ahmedoab/cargo_robot/cad/README.md

# Cargo robot: mechanical design v2 with a tilting bed (Phase II)

**Overall size:** 407 × 382 × 220 mm (L × W × H) with the bed flat.

**Layout:**

- Two drive wheels in the middle (JGB37-520 110 RPM motor sets with 65 mm wheels), and a printed ball caster at the front and rear (a 25 mm steel ball in a cup, on an M8 bolt whose nuts set the height).
- All four plates are laser-cut from **6 mm acrylic**.
- The bottom plate carries the electronics: ESP32, motor drivers, battery, two buck converters.
- The top deck sits on 6 M6 threaded rods. The E-stop and master switch are at its front, the start button and two LEDs at its rear.
- **Tilting bed:** the tilting plate carries the cargo plate on 4 printed risers. Two 60 kg·cm servos on the deck's right edge, one at each end of the bed, turn it about their shafts (the shafts are the hinge). The bed tips 40° to the right and the package slides off onto the conveyor. Flat, it rests on two printed posts.
- **Sensors:** 3 IR line sensors on a printed bar under the bottom plate (in front of the wheels, nothing sticks out), and one HC-SR04 ultrasonic sensor at the front of the electronics bay looking ahead. Everything is wired straight to the ESP32 (no I/O expander, no I2C).

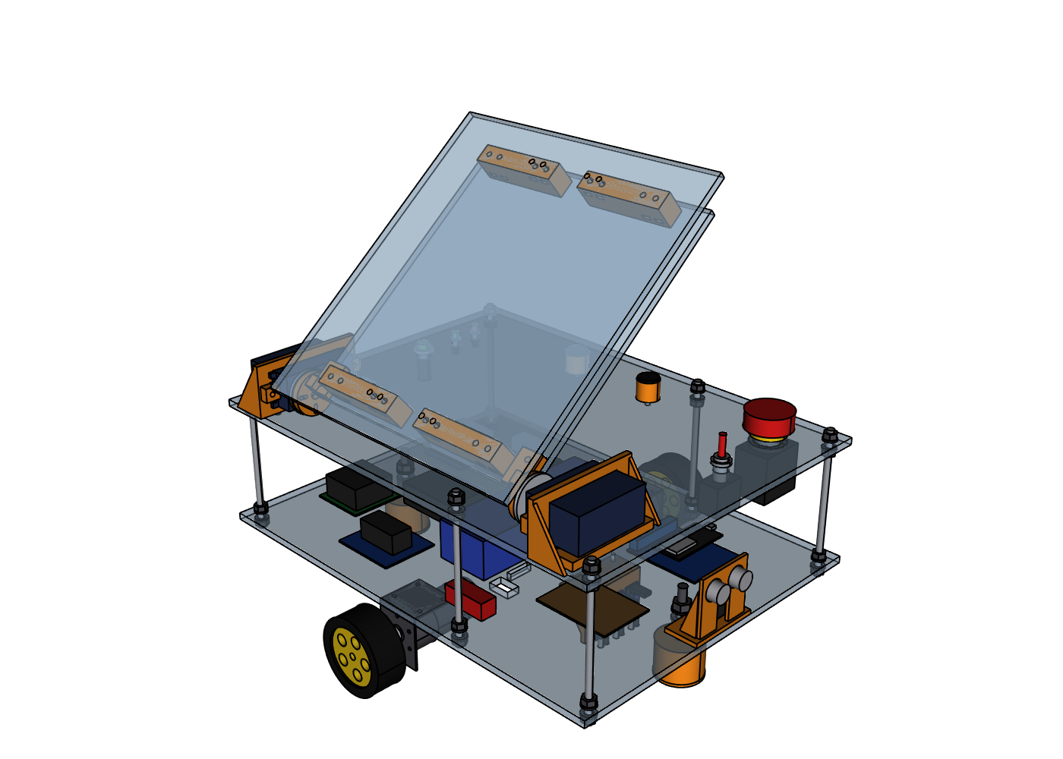
[picture p2: cad/output/views/render_tipped.png]
The robot, bed tipped


## AutoCAD

`autocad/CargoRobot_v2.dxf` is the design in AutoCAD's own format.

- **Open it:** File → Open → *Files of type: DXF* → the file. Then File → Save As → *AutoCAD 2018 Drawing (*.dwg)*.
- **Model tab:** the full 3D robot on layers `3D-CHASSIS`, `3D-DRIVE`, `3D-ELECTRONICS`, `3D-SENSORS`, `3D-CONTROLS`, `3D-TILT` (servos and their mounts) and `3D-PAYLOAD` (everything that tips).
  - Orbit with Shift + middle mouse button, or the ViewCube.
  - Set the visual style (top-left corner of the view) to *Shaded with Edges*.
- **Layout tabs 01–10:** A3 engineering drawings with dimensions, a title block and a bill of materials.
  - 01 general arrangement, 02 layout with the deck removed, 03–06 the four plates with hole tables, 07 the tilting bed, 08–09 printed parts, 10 BOM.
  - They're set up to plot on *DWG To PDF*, A3, 1:1.
  - Fill in the "DRAWN" box in the title block.
- **True 3D solids** (full AutoCAD, not LT): type `IMPORT` and pick `output/robot_assembly.step` (or `robot_assembly_tipped.step`).

`autocad/CargoRobot_v2_drawings.pdf` has the same 10 sheets as a PDF (true A3 pages, 1:1), for printing or showing without AutoCAD.

## Electrical schematics

`autocad/CargoRobot_v2_schematics.dxf` (AutoCAD, 4 layout tabs) and `autocad/CargoRobot_v2_schematics.pdf`:

- **E01 System block diagram:** every part and how power and signals flow between them.
- **E02 Power distribution:** battery → fuse → master switch → E-stop → motor drivers, motors and the 7.4 V servo buck; the 5.1 V buck for the ESP32 and sensors; the battery/E-stop sense divider. Wire IDs P1–P19 match the power wire list in `BUILD_GUIDE.md` (week 2).
- **E03 ESP32 wiring:** the DevKit's 38 pins with every used one, the motor/encoder cables, both BTS7960 drivers, the ultrasonic sensor with its divider, and the servo signals.
- **E04 Line sensors and panel:** the 3 IR modules, the start button, LEDs, buzzer and the motor-enable pull-down.

Pin numbers come from `firmware/cargo_robot/config.h`: change a pin there and re-run `make_schematics.py`.

## Assembly and connections

- `autocad/CargoRobot_v2_assembly.pdf`: every component (bought, laser-cut, 3D-printed), the tools, and the assembly in 11 steps with a picture of each stage; then drawing sheets 01, 02 and 07.
- `autocad/CargoRobot_v2_connections.pdf`: every wire (power P1–P19, signal S1–S28), the parts on the I/O board, the connections of each part pin by pin, then the 4 schematic sheets.

Both are made by `make_docs.py` from `robot_cad.py` (parts), `wiring.py` (wires) and `firmware/cargo_robot/config.h` (pin numbers).

## Open it in other CAD programs

- **Fusion 360:** Upload → `output/robot_assembly.step`
- **SolidWorks:** File → Open → change the file type to STEP → `output/robot_assembly.step`
- **Onshape:** Import → `output/robot_assembly.step`
- **FreeCAD:** File → Open → `output/robot_assembly.step`

## Make it

| File | How it's made |
|---|---|
| `output/dxf/bottom_plate.dxf`, `top_deck.dxf`, `tilt_plate.dxf`, `cargo_plate.dxf` | Laser-cut 6 mm acrylic. Every hole and slot is in the files. Use washers on the acrylic and tighten only until snug. |
| `output/parts/*.stl` (ONLY the printed parts, see below) | 3D print, PETG. Each file already lies in its printing position. |
| `output/bom.csv` | Everything else (bought parts, rods, nuts) |

Printed parts (11 files, 19 prints): `servo_mount_front`, `servo_mount_rear`, `servo_clamp` (× 4), `horn_adapter_front`, `horn_adapter_rear`, `bed_rest` (× 2), `bed_riser` (× 4), `line_sensor_bar`, `sonar_bracket`, `caster_cup` (× 2), `caster_ring` (× 2). The plates are not in `output/parts/`: they are the DXF files, for the laser.

> **How the prints were checked.** `check_render.py` runs a rod slightly thinner than each bolt through every bolt path (57 of them) to prove the holes line up through all the parts they join, checks every part against every other with the bed at 0–45°, and checks that each printed part is one piece, fits a 200 × 200 mm printer and has a flat face on the bed. The servo mounts follow the DS5160 maker's drawing (65 × 30 mm body, 75 mm over the ears, ears 31 mm above the bottom); they clamp the ears and slide ±4 mm, so they don't depend on the details the maker doesn't publish. The casters and the line sensors adjust on the robot for whatever height your motor brackets give.

## Change it

Edit the parameters at the top of `robot_cad.py`, then run:

```
.venv\Scripts\python robot_cad.py       # regenerate every file
.venv\Scripts\python check_render.py    # bolt paths, collisions (bed flat and tipped), printability, wheels on the floor, torque, PNG renders
.venv\Scripts\python make_autocad.py    # AutoCAD DXF (3D model + 10 drawing sheets) + PDF
.venv\Scripts\python make_schematics.py # electrical schematics DXF + PDF
.venv\Scripts\python make_docs.py       # assembly PDF + connections PDF (+ updates BUILD_GUIDE.md's wire tables)
.venv\Scripts\python make_missing_parts.py  # ../Missing_Parts_List.pdf: what is still to buy (edit its lists)
```

`make_docs.py` also needs `reportlab` and `pypdf`: `.venv\Scripts\python -m pip install reportlab pypdf`.
