ahmedoab/cargo_robot/cad/autocad/CargoRobot_v2_connections.pdf

Autonomous cargo robot - design v2 - connections | page 1

# Cargo robot v2 - all connections

Graduation Project II - 12 November 2026. Every wire of the robot: the power wires (P), the signal wires (S), the small parts on the I/O board, then the connections of each part. The 4 schematic sheets follow at the end (A3). GPIO numbers come from firmware/cargo_robot/config.h.

How to read it. One row = one wire, from the first place to the second. Rows with the same ID belong to one job (e.g. S6 = the VCC of both motor drivers). Label every wire with its ID at both ends. Buses: WAGO +12 V MAIN (after the switch), WAGO +12 V MOTOR (after the E-stop), WAGO +5 V, WAGO +7.4 V and WAGO GND are lever connectors on the bottom plate; the 3V3 bus and GND bus are rows of linked pins on the I/O board (3V3 comes from the ESP32's 3V3 pin).
Never connect 5 V or more to an ESP32 pin, the encoders or the line sensors: they all run on 3.3 V. Wire with the master switch OFF and the battery unplugged.

## Power wires

ID | From | To | Wire | Note
P1 | Battery BT1 + (XT60) | Fuse holder F1 in | 16 AWG red, 10 cm | XT60 soldered
P2 | Fuse holder F1 out | Master switch SW1 terminal 1 | 16 AWG red
P3 | Master switch SW1 terminal 2 | WAGO +12 V MAIN | 16 AWG red | WAGO 221-415
P4 | Battery BT1 - (XT60) | WAGO GND | 16 AWG black | WAGO 221-415, link a second one
P5 | WAGO +12 V MAIN | E-stop S1 NC terminal 1 | 16 AWG red, 40 cm | ferrule
P6 | E-stop S1 NC terminal 2 | WAGO +12 V MOTOR | 16 AWG red, 40 cm | ferrule
P7 | WAGO +12 V MOTOR | BTS7960 left U2 B+ | 16 AWG red | ferrule
P8 | WAGO +12 V MOTOR | BTS7960 right U3 B+ | 16 AWG red | ferrule
P9 | WAGO GND | BTS7960 left U2 B- | 16 AWG black | ferrule
P10 | WAGO GND | BTS7960 right U3 B- | 16 AWG black | ferrule
P11 | BTS7960 left U2 M+ | Left motor M1 red (motor +) | 20 AWG or the motor's wire | ferrule
P11 | BTS7960 left U2 M- | Left motor M1 white (motor -) | 20 AWG or the motor's wire | ferrule
P12 | BTS7960 right U3 M+ | Right motor M2 red (motor +) | 20 AWG or the motor's wire | ferrule
P12 | BTS7960 right U3 M- | Right motor M2 white (motor -) | 20 AWG or the motor's wire | ferrule
P13 | WAGO +12 V MAIN | 5 V buck U1 IN+ | 20 AWG red | ferrule
P14 | WAGO GND | 5 V buck U1 IN- | 20 AWG black | ferrule
P15 | 5 V buck U1 OUT+ | WAGO +5 V | 20 AWG red | set to 5.10 V first
P15 | 5 V buck U1 OUT- | WAGO GND | 20 AWG black
P15 | WAGO +5 V | ESP32 (breakout) 5V | 20 AWG red
P15 | WAGO GND | ESP32 (breakout) GND | 20 AWG black | the logic ground starts here
P16 | Battery BT1 balance plug | LiPo voltage alarm | - | set it to 3.5 V per cell

ID | From | To | Wire | Note
P17 | WAGO +12 V MOTOR | Servo buck U5 IN+ | 16 AWG red | ferrule
P18 | WAGO GND | Servo buck U5 IN- | 16 AWG black | ferrule
P19 | Servo buck U5 OUT+ | WAGO +7.4 V | 16 AWG red | set to 7.4 V first
P19 | Servo buck U5 OUT- | WAGO GND | 16 AWG black
P19 | WAGO +7.4 V | Front servo SV1 red (+) | servo lead
P19 | WAGO GND | Front servo SV1 brown (-) | servo lead
P19 | WAGO +7.4 V | Rear servo SV2 red (+) | servo lead
P19 | WAGO GND | Rear servo SV2 brown (-) | servo lead

## Signal wires

ID | From | To | Wire | Note
S1 | BTS7960 left U2 RPWM | ESP32 (breakout) GPIO 25 | jumper 24-26 AWG | forward PWM
S2 | BTS7960 left U2 LPWM | ESP32 (breakout) GPIO 26 | jumper 24-26 AWG | reverse PWM
S3 | BTS7960 right U3 RPWM | ESP32 (breakout) GPIO 27 | jumper 24-26 AWG | forward PWM
S4 | BTS7960 right U3 LPWM | ESP32 (breakout) GPIO 14 | jumper 24-26 AWG | reverse PWM
S5 | BTS7960 left U2 R_EN + L_EN (linked) | ESP32 (breakout) GPIO 13 | jumper 24-26 AWG | MOTOR_EN; 10k pull-down to GND
S5 | BTS7960 right U3 R_EN + L_EN (linked) | ESP32 (breakout) GPIO 13 | jumper 24-26 AWG | MOTOR_EN
S6 | BTS7960 left U2 VCC | 3V3 bus | jumper 24-26 AWG | 3.3 V, not 5 V
S6 | BTS7960 right U3 VCC | 3V3 bus | jumper 24-26 AWG | 3.3 V, not 5 V
S7 | BTS7960 left U2 GND (logic) | GND bus | jumper 24-26 AWG
S7 | BTS7960 right U3 GND (logic) | GND bus | jumper 24-26 AWG
S8 | Left motor M1 blue (encoder VCC) | 3V3 bus | jumper 24-26 AWG | 3.3 V, never 5 V
S9 | Left motor M1 black (encoder GND) | GND bus | jumper 24-26 AWG
S10 | Left motor M1 yellow (encoder A) | ESP32 (breakout) GPIO 34 | jumper 24-26 AWG | 10k pull-up to 3V3
S11 | Left motor M1 green (encoder B) | ESP32 (breakout) GPIO 35 | jumper 24-26 AWG | 10k pull-up to 3V3
S12 | Right motor M2 blue (encoder VCC) | 3V3 bus | jumper 24-26 AWG | 3.3 V, never 5 V
S13 | Right motor M2 black (encoder GND) | GND bus | jumper 24-26 AWG
S14 | Right motor M2 yellow (encoder A) | ESP32 (breakout) GPIO 36 (VP) | jumper 24-26 AWG | 10k pull-up to 3V3
S15 | Right motor M2 green (encoder B) | ESP32 (breakout) GPIO 39 (VN) | jumper 24-26 AWG | 10k pull-up to 3V3
S16 | HC-SR04 (front) VCC | WAGO +5 V | jumper 24-26 AWG | 5 V
S17 | HC-SR04 (front) GND | GND bus | jumper 24-26 AWG
S18 | HC-SR04 (front) TRIG | ESP32 (breakout) GPIO 4 | jumper 24-26 AWG
S19 | HC-SR04 (front) ECHO | ESP32 (breakout) GPIO 23 | jumper 24-26 AWG | through a 1k / 2k divider (5 V -> 3.3 V)
S20 | Front servo SV1 orange (signal) | ESP32 (breakout) GPIO 2 | servo lead
S21 | Rear servo SV2 orange (signal) | ESP32 (breakout) GPIO 12 | servo lead | nothing else on this pin (must be LOW at start-up)
S22 | ESP32 (breakout) 3V3 | 3V3 bus | jumper 24-26 AWG | feeds every 3.3 V part
S22 | ESP32 (breakout) GND | GND bus | jumper 24-26 AWG
S23 | IR line sensor 1 (left) VCC | 3V3 bus | jumper 24-26 AWG | 3.3 V, not 5 V
S23 | IR line sensor 1 (left) GND | GND bus | jumper 24-26 AWG
S23 | IR line sensor 2 (middle) VCC | 3V3 bus | jumper 24-26 AWG | 3.3 V, not 5 V
S23 | IR line sensor 2 (middle) GND | GND bus | jumper 24-26 AWG
S23 | IR line sensor 3 (right) VCC | 3V3 bus | jumper 24-26 AWG | 3.3 V, not 5 V
S23 | IR line sensor 3 (right) GND | GND bus | jumper 24-26 AWG
S24 | IR line sensor 1 (left) OUT | ESP32 (breakout) GPIO 16 | jumper 24-26 AWG | left

ID | From | To | Wire | Note
S24 | IR line sensor 2 (middle) OUT | ESP32 (breakout) GPIO 17 | jumper 24-26 AWG | middle
S24 | IR line sensor 3 (right) OUT | ESP32 (breakout) GPIO 18 | jumper 24-26 AWG | right
S25 | Start button S2 terminal 1 | ESP32 (breakout) GPIO 19 | jumper 24-26 AWG | internal pull-up
S25 | Start button S2 terminal 2 | GND bus | jumper 24-26 AWG
S26 | Green LED D1 + (long leg) | ESP32 (breakout) GPIO 21 | jumper 24-26 AWG | through 330 ohm
S26 | Green LED D1 - (short leg) | GND bus | jumper 24-26 AWG
S26 | Red LED D2 + (long leg) | ESP32 (breakout) GPIO 22 | jumper 24-26 AWG | through 330 ohm
S26 | Red LED D2 - (short leg) | GND bus | jumper 24-26 AWG
S27 | Buzzer module VCC | 3V3 bus | jumper 24-26 AWG
S27 | Buzzer module GND | GND bus | jumper 24-26 AWG
S27 | Buzzer module I/O | ESP32 (breakout) GPIO 32 | jumper 24-26 AWG
S28 | Bus-sense divider top of 10k | WAGO +12 V MOTOR | jumper 24-26 AWG | after the E-stop
S28 | Bus-sense divider bottom of 2.2k | GND bus | jumper 24-26 AWG | 100 nF across the 2.2k
S28 | Bus-sense divider junction | ESP32 (breakout) GPIO 33 | jumper 24-26 AWG | about 2.3 V at 12.6 V; 0 V = E-stop pressed

## The I/O board (5 x 7 cm perfboard, schematic E04)

Part | Connected
1 x 10k | MOTOR_EN (GPIO 13) -> GND: motors off until the ESP32 has started
4 x 10k | encoder lines GPIO 34, 35, 36, 39 -> 3V3 (these pins have no pull-ups inside)
1k + 2k | ultrasonic ECHO divider: ECHO - 1k - junction - 2k - GND; junction to the ESP32
10k + 2.2k + 100 nF | bus sense: +12 V MOTOR - 10k - junction - 2.2k - GND; junction to GPIO 33
2 x 330 | in series with the green and red LEDs
3 rows of linked pins | 3V3 bus, GND bus, 5 V (from WAGO +5 V)

# Connections of each part

The same wires again, listed under every part they touch: use it to check one part at a time.

## Battery BT1

ID | Pin here | Goes to | Wire | Note
P1 | + (XT60) | Fuse holder F1 in | 16 AWG red, 10 cm | XT60 soldered
P4 | - (XT60) | WAGO GND | 16 AWG black | WAGO 221-415, link a second one
P16 | balance plug | LiPo voltage alarm | - | set it to 3.5 V per cell

## Fuse holder F1

ID | Pin here | Goes to | Wire | Note
P1 | in | Battery BT1 + (XT60) | 16 AWG red, 10 cm | XT60 soldered
P2 | out | Master switch SW1 terminal 1 | 16 AWG red

## Master switch SW1

ID | Pin here | Goes to | Wire | Note
P2 | terminal 1 | Fuse holder F1 out | 16 AWG red
P3 | terminal 2 | WAGO +12 V MAIN | 16 AWG red | WAGO 221-415

## WAGO +12 V MAIN

ID | Pin here | Goes to | Wire | Note
P3 | | Master switch SW1 terminal 2 | 16 AWG red | WAGO 221-415
P5 | | E-stop S1 NC terminal 1 | 16 AWG red, 40 cm | ferrule
P13 | | 5 V buck U1 IN+ | 20 AWG red | ferrule

## WAGO GND

ID | Pin here | Goes to | Wire | Note
P4 | | Battery BT1 - (XT60) | 16 AWG black | WAGO 221-415, link a second one
P9 | | BTS7960 left U2 B- | 16 AWG black | ferrule
P10 | | BTS7960 right U3 B- | 16 AWG black | ferrule
P14 | | 5 V buck U1 IN- | 20 AWG black | ferrule
P15 | | 5 V buck U1 OUT- | 20 AWG black
P15 | | ESP32 (breakout) GND | 20 AWG black | the logic ground starts here
P18 | | Servo buck U5 IN- | 16 AWG black | ferrule
P19 | | Servo buck U5 OUT- | 16 AWG black
P19 | | Front servo SV1 brown (-) | servo lead
P19 | | Rear servo SV2 brown (-) | servo lead

## E-stop S1

ID | Pin here | Goes to | Wire | Note
P5 | NC terminal 1 | WAGO +12 V MAIN | 16 AWG red, 40 cm | ferrule
P6 | NC terminal 2 | WAGO +12 V MOTOR | 16 AWG red, 40 cm | ferrule

## WAGO +12 V MOTOR

ID | Pin here | Goes to | Wire | Note
P6 | | E-stop S1 NC terminal 2 | 16 AWG red, 40 cm | ferrule
P7 | | BTS7960 left U2 B+ | 16 AWG red | ferrule
P8 | | BTS7960 right U3 B+ | 16 AWG red | ferrule
P17 | | Servo buck U5 IN+ | 16 AWG red | ferrule
S28 | | Bus-sense divider top of 10k | jumper 24-26 AWG | after the E-stop

## BTS7960 left U2

ID | Pin here | Goes to | Wire | Note
P7 | B+ | WAGO +12 V MOTOR | 16 AWG red | ferrule
P9 | B- | WAGO GND | 16 AWG black | ferrule
P11 | M+ | Left motor M1 red (motor +) | 20 AWG or the motor's wire | ferrule
P11 | M- | Left motor M1 white (motor -) | 20 AWG or the motor's wire | ferrule
S1 | RPWM | ESP32 (breakout) GPIO 25 | jumper 24-26 AWG | forward PWM
S2 | LPWM | ESP32 (breakout) GPIO 26 | jumper 24-26 AWG | reverse PWM
S5 | R_EN + L_EN (linked) | ESP32 (breakout) GPIO 13 | jumper 24-26 AWG | MOTOR_EN; 10k pull-down to GND
S6 | VCC | 3V3 bus | jumper 24-26 AWG | 3.3 V, not 5 V
S7 | GND (logic) | GND bus | jumper 24-26 AWG

## BTS7960 right U3

ID | Pin here | Goes to | Wire | Note
P8 | B+ | WAGO +12 V MOTOR | 16 AWG red | ferrule
P10 | B- | WAGO GND | 16 AWG black | ferrule
P12 | M+ | Right motor M2 red (motor +) | 20 AWG or the motor's wire | ferrule
P12 | M- | Right motor M2 white (motor -) | 20 AWG or the motor's wire | ferrule
S3 | RPWM | ESP32 (breakout) GPIO 27 | jumper 24-26 AWG | forward PWM
S4 | LPWM | ESP32 (breakout) GPIO 14 | jumper 24-26 AWG | reverse PWM
S5 | R_EN + L_EN (linked) | ESP32 (breakout) GPIO 13 | jumper 24-26 AWG | MOTOR_EN
S6 | VCC | 3V3 bus | jumper 24-26 AWG | 3.3 V, not 5 V
S7 | GND (logic) | GND bus | jumper 24-26 AWG

## Left motor M1

ID | Pin here | Goes to | Wire | Note
P11 | red (motor +) | BTS7960 left U2 M+ | 20 AWG or the motor's wire | ferrule
P11 | white (motor -) | BTS7960 left U2 M- | 20 AWG or the motor's wire | ferrule
S8 | blue (encoder VCC) | 3V3 bus | jumper 24-26 AWG | 3.3 V, never 5 V
S9 | black (encoder GND) | GND bus | jumper 24-26 AWG
S10 | yellow (encoder A) | ESP32 (breakout) GPIO 34 | jumper 24-26 AWG | 10k pull-up to 3V3
S11 | green (encoder B) | ESP32 (breakout) GPIO 35 | jumper 24-26 AWG | 10k pull-up to 3V3

## Right motor M2

ID | Pin here | Goes to | Wire | Note
P12 | red (motor +) | BTS7960 right U3 M+ | 20 AWG or the motor's wire | ferrule
P12 | white (motor -) | BTS7960 right U3 M- | 20 AWG or the motor's wire | ferrule
S12 | blue (encoder VCC) | 3V3 bus | jumper 24-26 AWG | 3.3 V, never 5 V
S13 | black (encoder GND) | GND bus | jumper 24-26 AWG
S14 | yellow (encoder A) | ESP32 (breakout) GPIO 36 (VP) | jumper 24-26 AWG | 10k pull-up to 3V3
S15 | green (encoder B) | ESP32 (breakout) GPIO 39 (VN) | jumper 24-26 AWG | 10k pull-up to 3V3

## 5 V buck U1

ID | Pin here | Goes to | Wire | Note
P13 | IN+ | WAGO +12 V MAIN | 20 AWG red | ferrule
P14 | IN- | WAGO GND | 20 AWG black | ferrule
P15 | OUT+ | WAGO +5 V | 20 AWG red | set to 5.10 V first
P15 | OUT- | WAGO GND | 20 AWG black

## WAGO +5 V

ID | Pin here | Goes to | Wire | Note
P15 | | 5 V buck U1 OUT+ | 20 AWG red | set to 5.10 V first
P15 | | ESP32 (breakout) 5V | 20 AWG red
S16 | | HC-SR04 (front) VCC | jumper 24-26 AWG | 5 V

## ESP32 (breakout)

ID | Pin here | Goes to | Wire | Note
P15 | 5V | WAGO +5 V | 20 AWG red
P15 | GND | WAGO GND | 20 AWG black | the logic ground starts here
S1 | GPIO 25 | BTS7960 left U2 RPWM | jumper 24-26 AWG | forward PWM
S2 | GPIO 26 | BTS7960 left U2 LPWM | jumper 24-26 AWG | reverse PWM
S3 | GPIO 27 | BTS7960 right U3 RPWM | jumper 24-26 AWG | forward PWM
S4 | GPIO 14 | BTS7960 right U3 LPWM | jumper 24-26 AWG | reverse PWM
S5 | GPIO 13 | BTS7960 left U2 R_EN + L_EN (linked) | jumper 24-26 AWG | MOTOR_EN; 10k pull-down to GND
S5 | GPIO 13 | BTS7960 right U3 R_EN + L_EN (linked) | jumper 24-26 AWG | MOTOR_EN
S10 | GPIO 34 | Left motor M1 yellow (encoder A) | jumper 24-26 AWG | 10k pull-up to 3V3
S11 | GPIO 35 | Left motor M1 green (encoder B) | jumper 24-26 AWG | 10k pull-up to 3V3
S14 | GPIO 36 (VP) | Right motor M2 yellow (encoder A) | jumper 24-26 AWG | 10k pull-up to 3V3
S15 | GPIO 39 (VN) | Right motor M2 green (encoder B) | jumper 24-26 AWG | 10k pull-up to 3V3
S18 | GPIO 4 | HC-SR04 (front) TRIG | jumper 24-26 AWG
S19 | GPIO 23 | HC-SR04 (front) ECHO | jumper 24-26 AWG | through a 1k / 2k divider (5 V -> 3.3 V)
S20 | GPIO 2 | Front servo SV1 orange (signal) | servo lead
S21 | GPIO 12 | Rear servo SV2 orange (signal) | servo lead | nothing else on this pin (must be LOW at start-up)
S22 | 3V3 | 3V3 bus | jumper 24-26 AWG | feeds every 3.3 V part
S22 | GND | GND bus | jumper 24-26 AWG
S24 | GPIO 16 | IR line sensor 1 (left) OUT | jumper 24-26 AWG | left
S24 | GPIO 17 | IR line sensor 2 (middle) OUT | jumper 24-26 AWG | middle
S24 | GPIO 18 | IR line sensor 3 (right) OUT | jumper 24-26 AWG | right
S25 | GPIO 19 | Start button S2 terminal 1 | jumper 24-26 AWG | internal pull-up
S26 | GPIO 21 | Green LED D1 + (long leg) | jumper 24-26 AWG | through 330 ohm
S26 | GPIO 22 | Red LED D2 + (long leg) | jumper 24-26 AWG | through 330 ohm
S27 | GPIO 32 | Buzzer module I/O | jumper 24-26 AWG
S28 | GPIO 33 | Bus-sense divider junction | jumper 24-26 AWG | about 2.3 V at 12.6 V; 0 V = E-stop pressed

## LiPo voltage alarm

ID | Pin here | Goes to | Wire | Note
P16 | | Battery BT1 balance plug | - | set it to 3.5 V per cell

## Servo buck U5

ID | Pin here | Goes to | Wire | Note
P17 | IN+ | WAGO +12 V MOTOR | 16 AWG red | ferrule
P18 | IN- | WAGO GND | 16 AWG black | ferrule
P19 | OUT+ | WAGO +7.4 V | 16 AWG red | set to 7.4 V first
P19 | OUT- | WAGO GND | 16 AWG black

## WAGO +7.4 V

ID | Pin here | Goes to | Wire | Note
P19 | | Servo buck U5 OUT+ | 16 AWG red | set to 7.4 V first
P19 | | Front servo SV1 red (+) | servo lead
P19 | | Rear servo SV2 red (+) | servo lead

## Front servo SV1

ID | Pin here | Goes to | Wire | Note
P19 | red (+) | WAGO +7.4 V | servo lead
P19 | brown (-) | WAGO GND | servo lead
S20 | orange (signal) | ESP32 (breakout) GPIO 2 | servo lead

## Rear servo SV2

ID | Pin here | Goes to | Wire | Note
P19 | red (+) | WAGO +7.4 V | servo lead
P19 | brown (-) | WAGO GND | servo lead
S21 | orange (signal) | ESP32 (breakout) GPIO 12 | servo lead | nothing else on this pin (must be LOW at start-up)

## 3V3 bus

ID | Pin here | Goes to | Wire | Note
S6 | | BTS7960 left U2 VCC | jumper 24-26 AWG | 3.3 V, not 5 V
S6 | | BTS7960 right U3 VCC | jumper 24-26 AWG | 3.3 V, not 5 V
S8 | | Left motor M1 blue (encoder VCC) | jumper 24-26 AWG | 3.3 V, never 5 V
S12 | | Right motor M2 blue (encoder VCC) | jumper 24-26 AWG | 3.3 V, never 5 V
S22 | | ESP32 (breakout) 3V3 | jumper 24-26 AWG | feeds every 3.3 V part
S23 | | IR line sensor 1 (left) VCC | jumper 24-26 AWG | 3.3 V, not 5 V
S23 | | IR line sensor 2 (middle) VCC | jumper 24-26 AWG | 3.3 V, not 5 V
S23 | | IR line sensor 3 (right) VCC | jumper 24-26 AWG | 3.3 V, not 5 V
S27 | | Buzzer module VCC | jumper 24-26 AWG

## GND bus

ID | Pin here | Goes to | Wire | Note
S7 | | BTS7960 left U2 GND (logic) | jumper 24-26 AWG
S7 | | BTS7960 right U3 GND (logic) | jumper 24-26 AWG
S9 | | Left motor M1 black (encoder GND) | jumper 24-26 AWG
S13 | | Right motor M2 black (encoder GND) | jumper 24-26 AWG
S17 | | HC-SR04 (front) GND | jumper 24-26 AWG
S22 | | ESP32 (breakout) GND | jumper 24-26 AWG
S23 | | IR line sensor 1 (left) GND | jumper 24-26 AWG
S23 | | IR line sensor 2 (middle) GND | jumper 24-26 AWG
S23 | | IR line sensor 3 (right) GND | jumper 24-26 AWG
S25 | | Start button S2 terminal 2 | jumper 24-26 AWG
S26 | | Green LED D1 - (short leg) | jumper 24-26 AWG
S26 | | Red LED D2 - (short leg) | jumper 24-26 AWG
S27 | | Buzzer module GND | jumper 24-26 AWG
S28 | | Bus-sense divider bottom of 2.2k | jumper 24-26 AWG | 100 nF across the 2.2k

## HC-SR04 (front)

ID | Pin here | Goes to | Wire | Note
S16 | VCC | WAGO +5 V | jumper 24-26 AWG | 5 V
S17 | GND | GND bus | jumper 24-26 AWG
S18 | TRIG | ESP32 (breakout) GPIO 4 | jumper 24-26 AWG
S19 | ECHO | ESP32 (breakout) GPIO 23 | jumper 24-26 AWG | through a 1k / 2k divider (5 V -> 3.3 V)

## IR line sensor 1 (left)

ID | Pin here | Goes to | Wire | Note
S23 | VCC | 3V3 bus | jumper 24-26 AWG | 3.3 V, not 5 V
S23 | GND | GND bus | jumper 24-26 AWG
S24 | OUT | ESP32 (breakout) GPIO 16 | jumper 24-26 AWG | left

## IR line sensor 2 (middle)

ID | Pin here | Goes to | Wire | Note
S23 | VCC | 3V3 bus | jumper 24-26 AWG | 3.3 V, not 5 V
S23 | GND | GND bus | jumper 24-26 AWG
S24 | OUT | ESP32 (breakout) GPIO 17 | jumper 24-26 AWG | middle

## IR line sensor 3 (right)

ID | Pin here | Goes to | Wire | Note
S23 | VCC | 3V3 bus | jumper 24-26 AWG | 3.3 V, not 5 V
S23 | GND | GND bus | jumper 24-26 AWG
S24 | OUT | ESP32 (breakout) GPIO 18 | jumper 24-26 AWG | right

## Start button S2

ID | Pin here | Goes to | Wire | Note
S25 | terminal 1 | ESP32 (breakout) GPIO 19 | jumper 24-26 AWG | internal pull-up
S25 | terminal 2 | GND bus | jumper 24-26 AWG

## Green LED D1

ID | Pin here | Goes to | Wire | Note
S26 | + (long leg) | ESP32 (breakout) GPIO 21 | jumper 24-26 AWG | through 330 ohm
S26 | - (short leg) | GND bus | jumper 24-26 AWG

## Red LED D2

ID | Pin here | Goes to | Wire | Note
S26 | + (long leg) | ESP32 (breakout) GPIO 22 | jumper 24-26 AWG | through 330 ohm
S26 | - (short leg) | GND bus | jumper 24-26 AWG

## Buzzer module

ID | Pin here | Goes to | Wire | Note
S27 | VCC | 3V3 bus | jumper 24-26 AWG
S27 | GND | GND bus | jumper 24-26 AWG
S27 | I/O | ESP32 (breakout) GPIO 32 | jumper 24-26 AWG

## Bus-sense divider

ID | Pin here | Goes to | Wire | Note
S28 | top of 10k | WAGO +12 V MOTOR | jumper 24-26 AWG | after the E-stop
S28 | bottom of 2.2k | GND bus | jumper 24-26 AWG | 100 nF across the 2.2k
S28 | junction | ESP32 (breakout) GPIO 33 | jumper 24-26 AWG | about 2.3 V at 12.6 V; 0 V = E-stop pressed

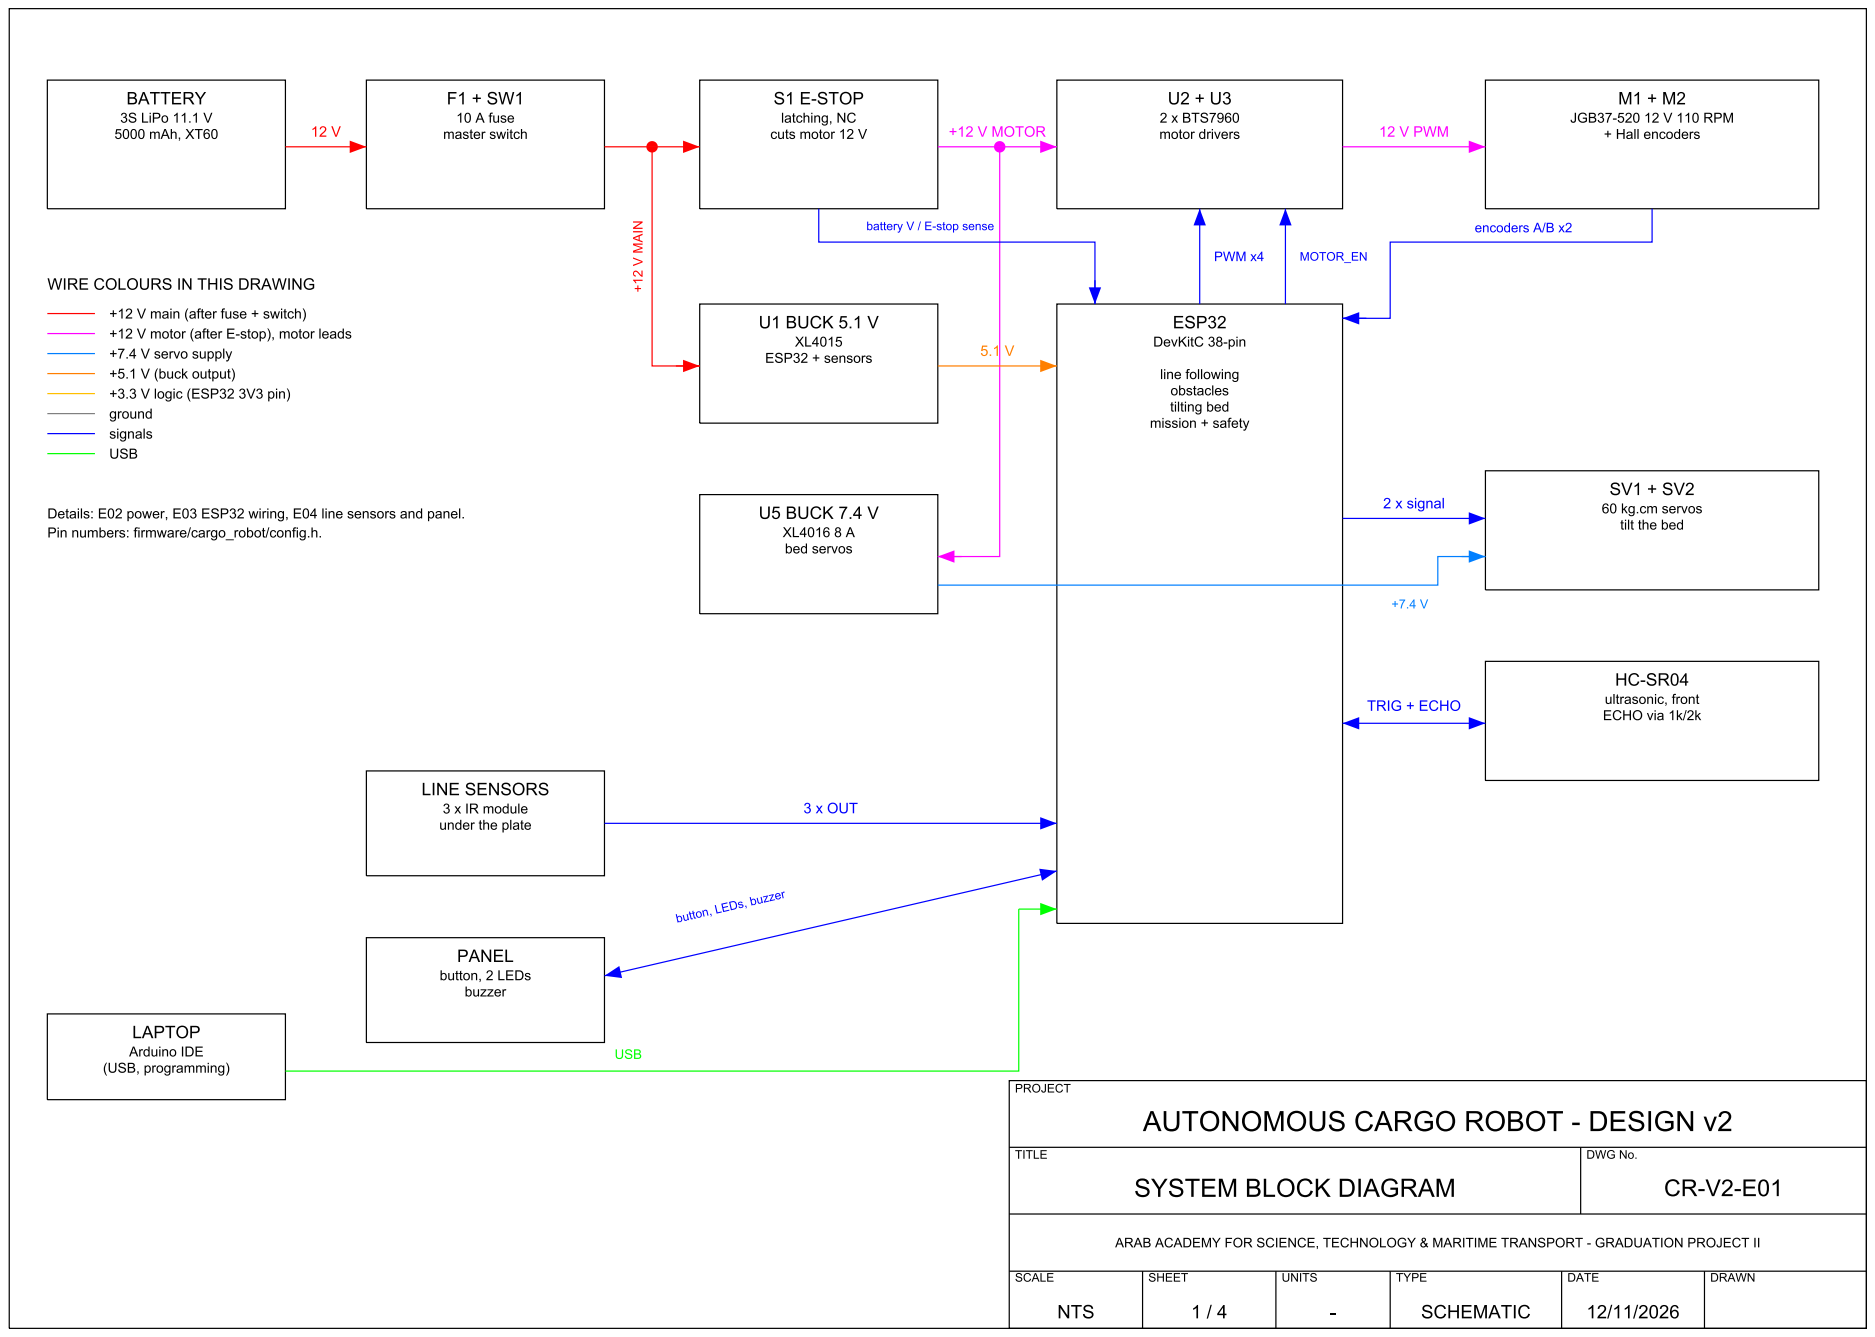
[picture p9: page 14]

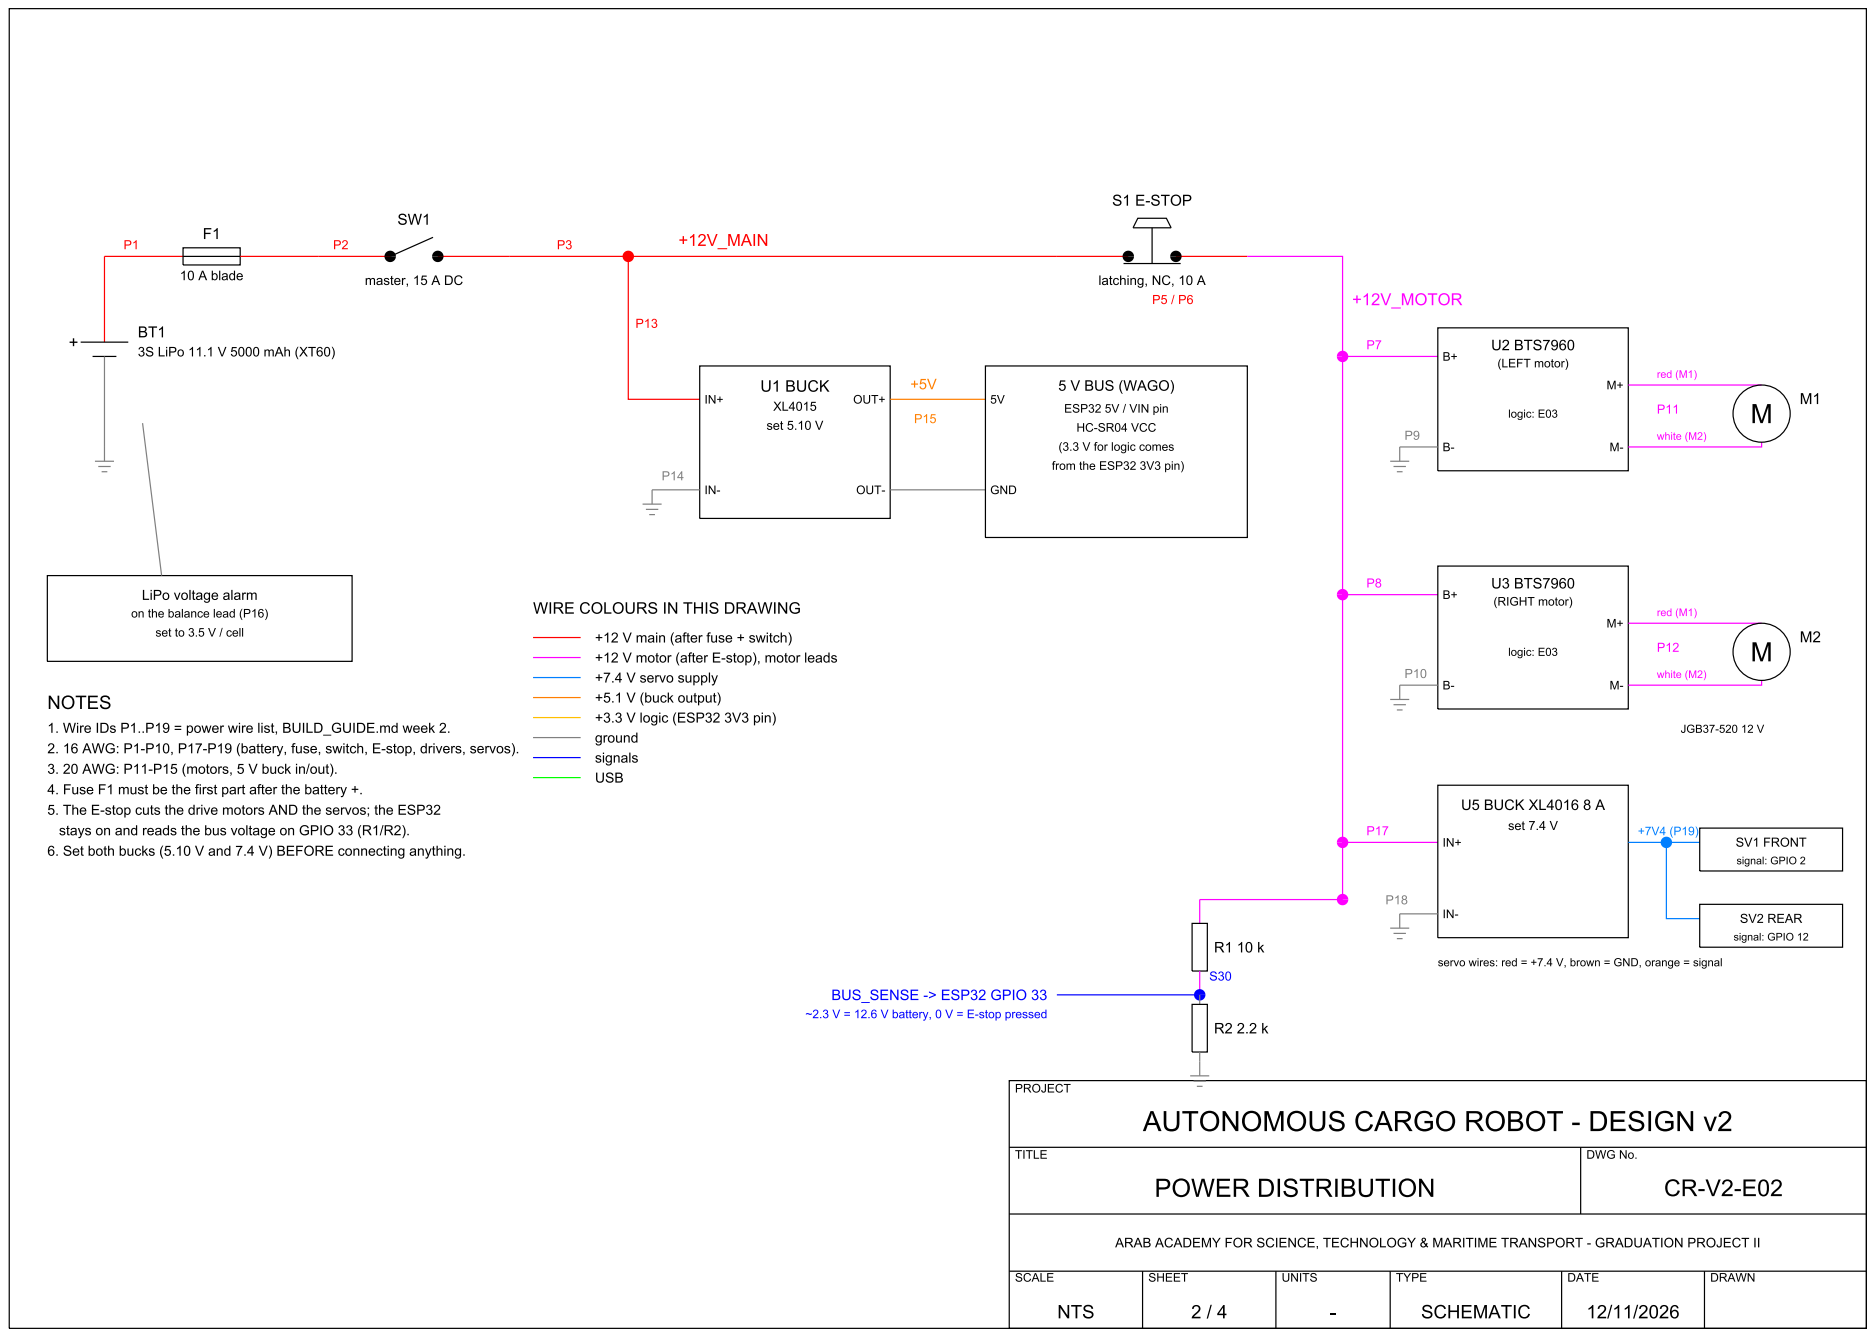
[picture p10: page 15]

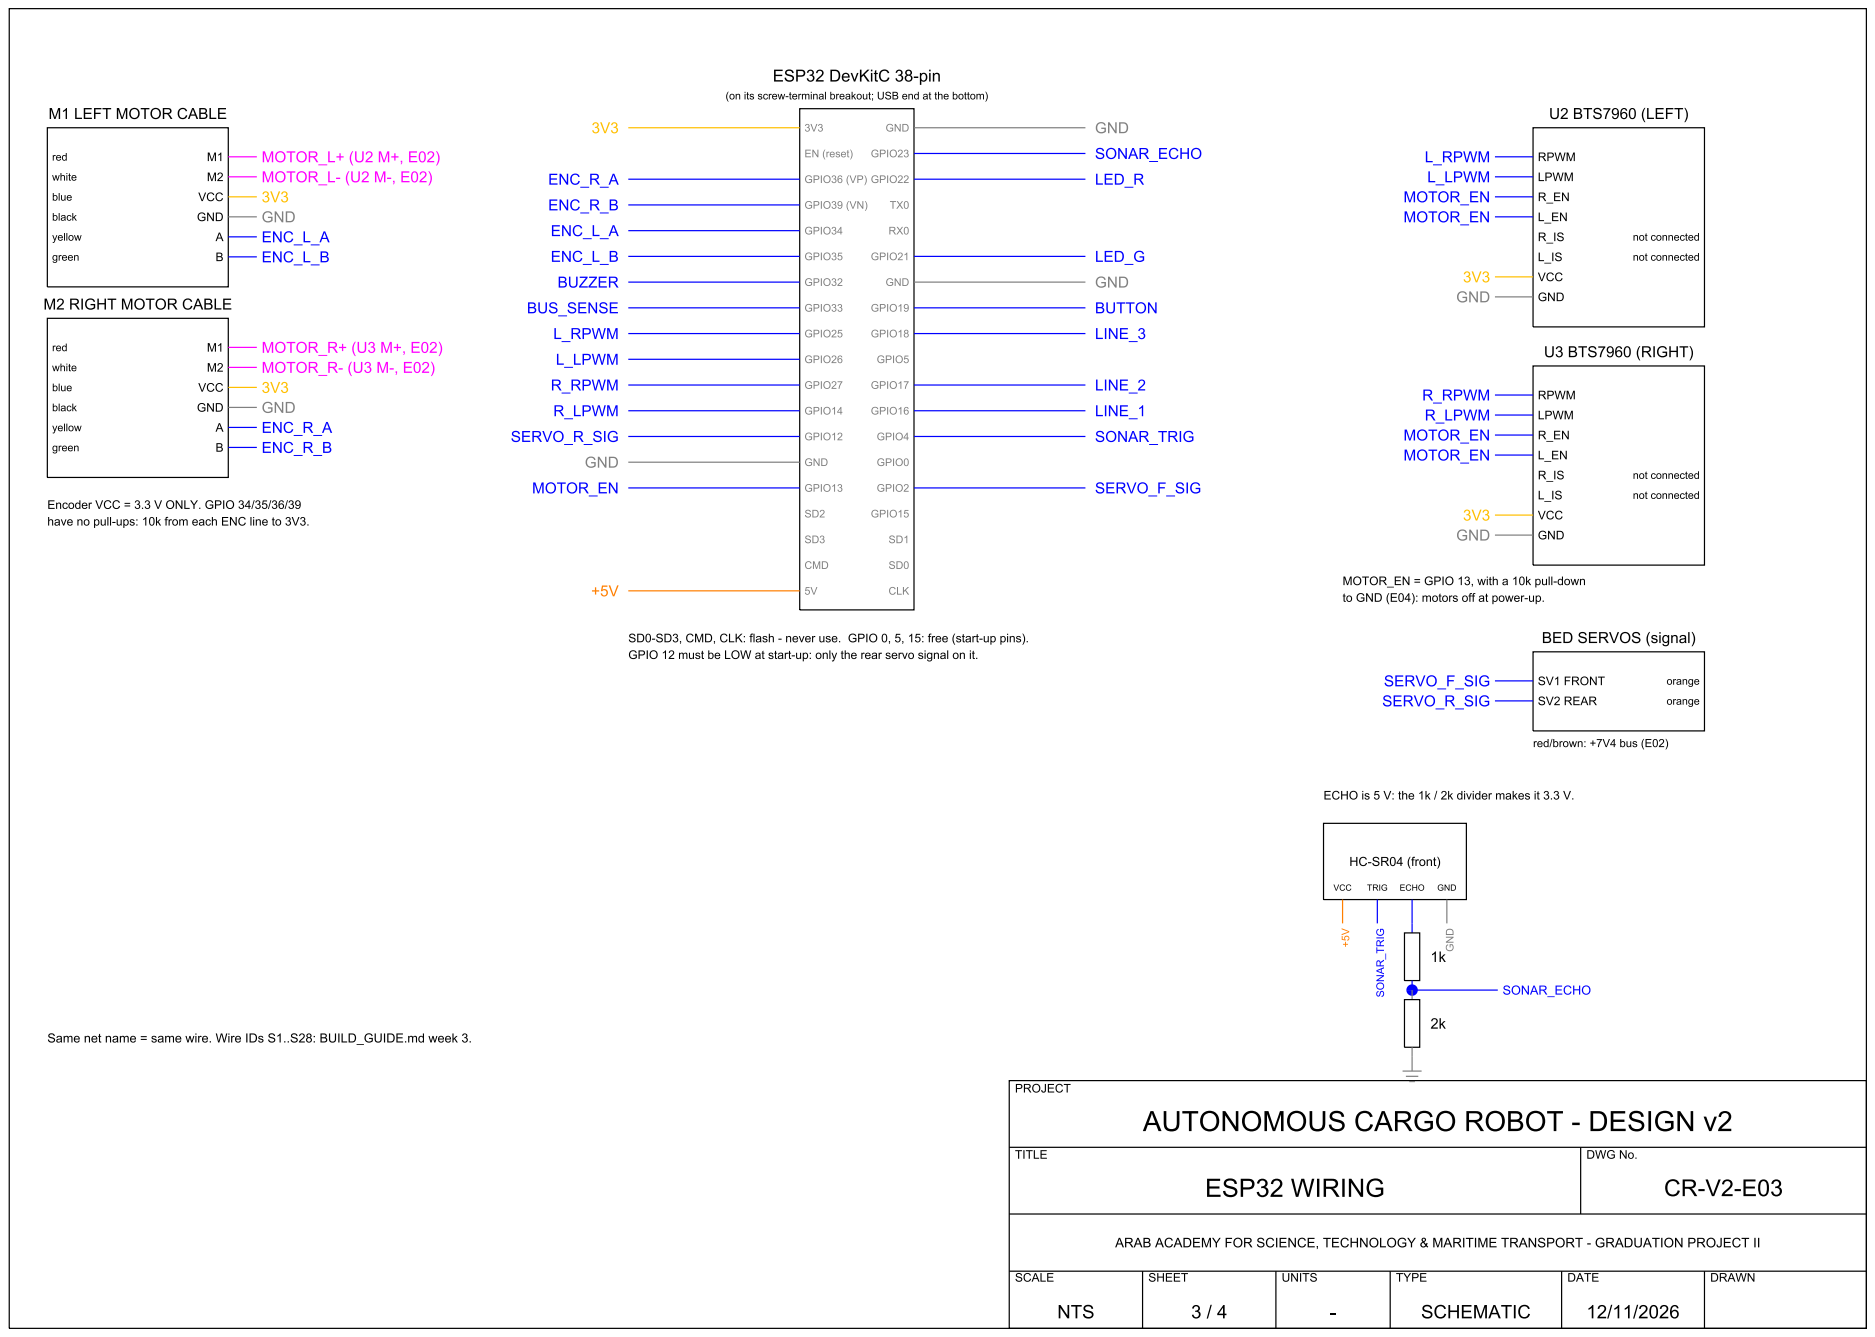
[picture p11: page 16]

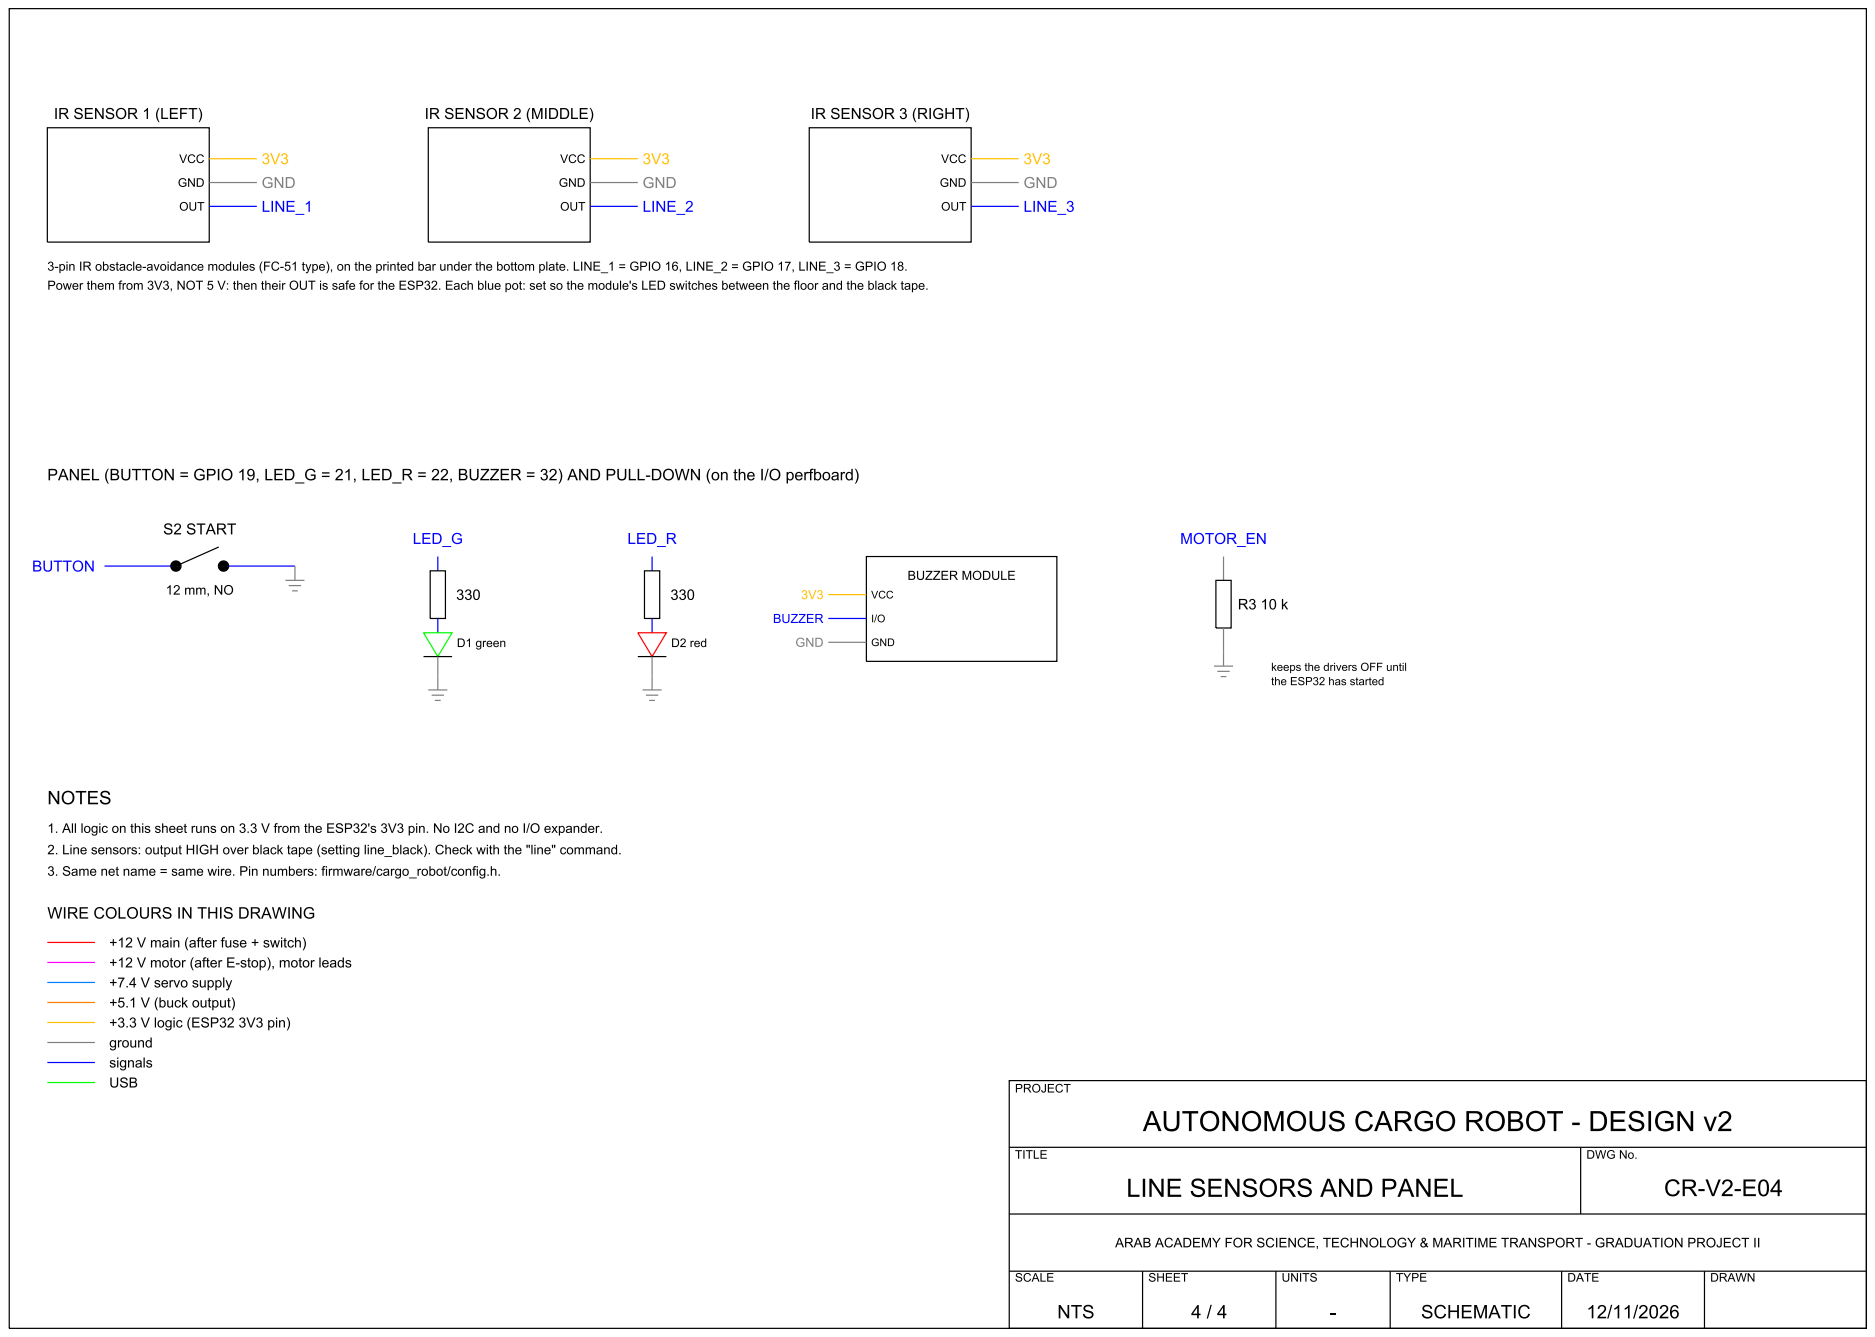
[picture p12: page 17]
