ahmedoab/cargo_robot/backup_v2/cad/autocad/previews/05_CARGO_PLATE.png

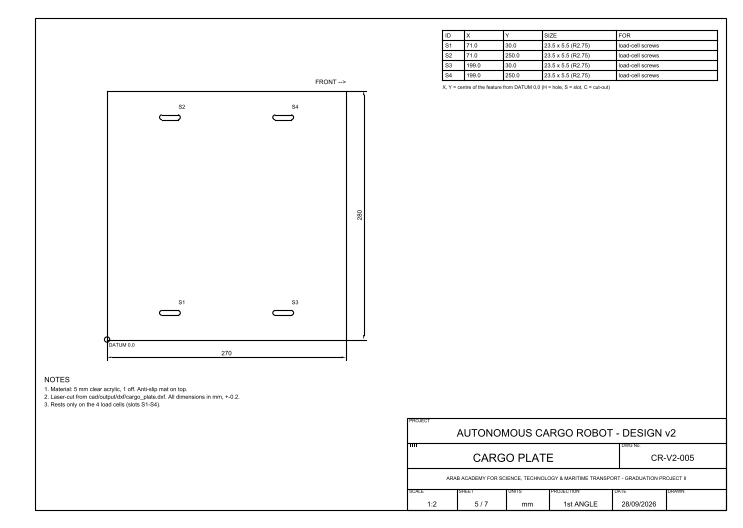
backup_v2/cad/autocad/previews/05_CARGO_PLATE.png
