ahmedoab/cargo_robot/backup_v2/cad/autocad/previews/E01_SYSTEM_BLOCK_DIAGRAM.png

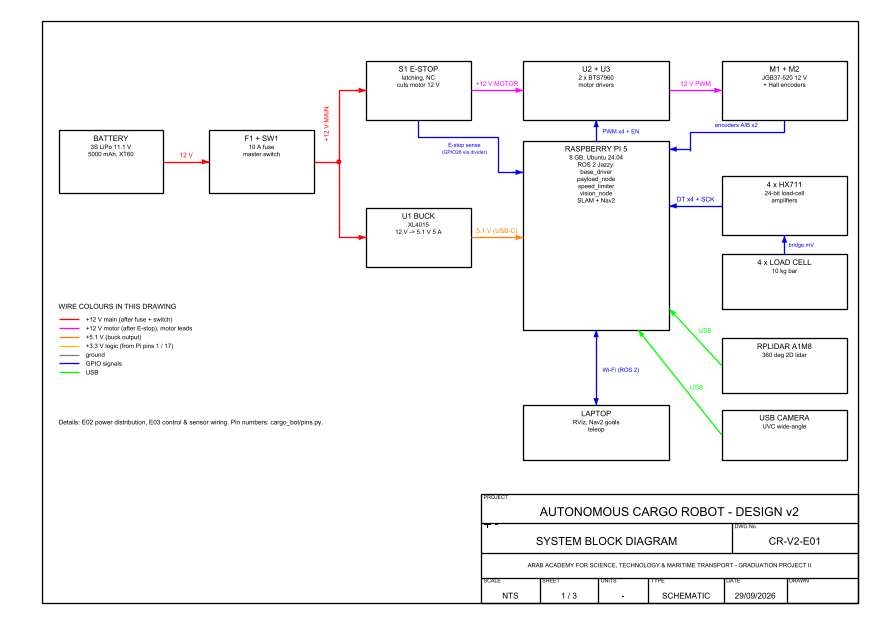
backup_v2/cad/autocad/previews/E01_SYSTEM_BLOCK_DIAGRAM.png
