ahmedoab/cargo_robot/backup_v2/cad/autocad/previews/E02_POWER_DISTRIBUTION.png

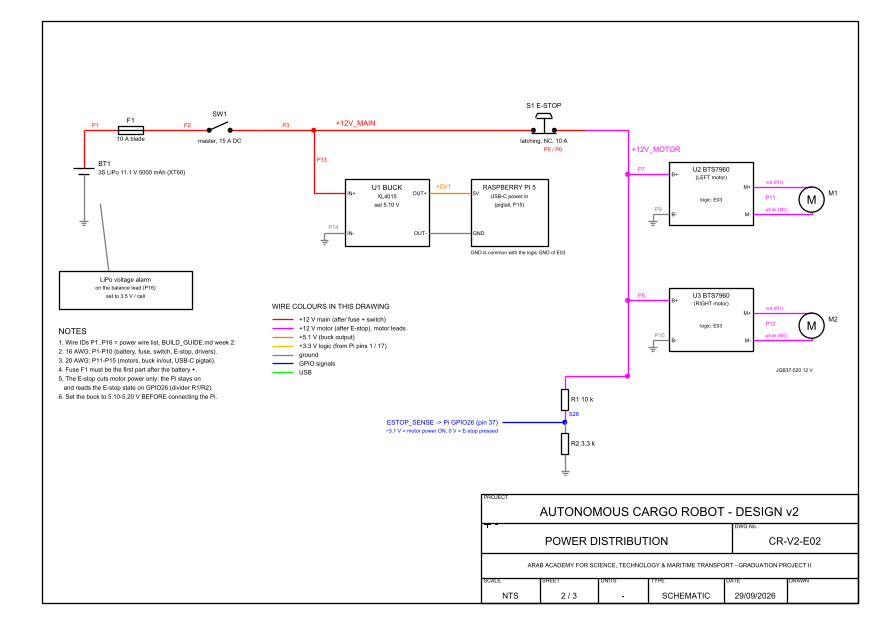
backup_v2/cad/autocad/previews/E02_POWER_DISTRIBUTION.png
