ahmedoab/cargo_robot/backup_v2/cad/output/views/render_front.png

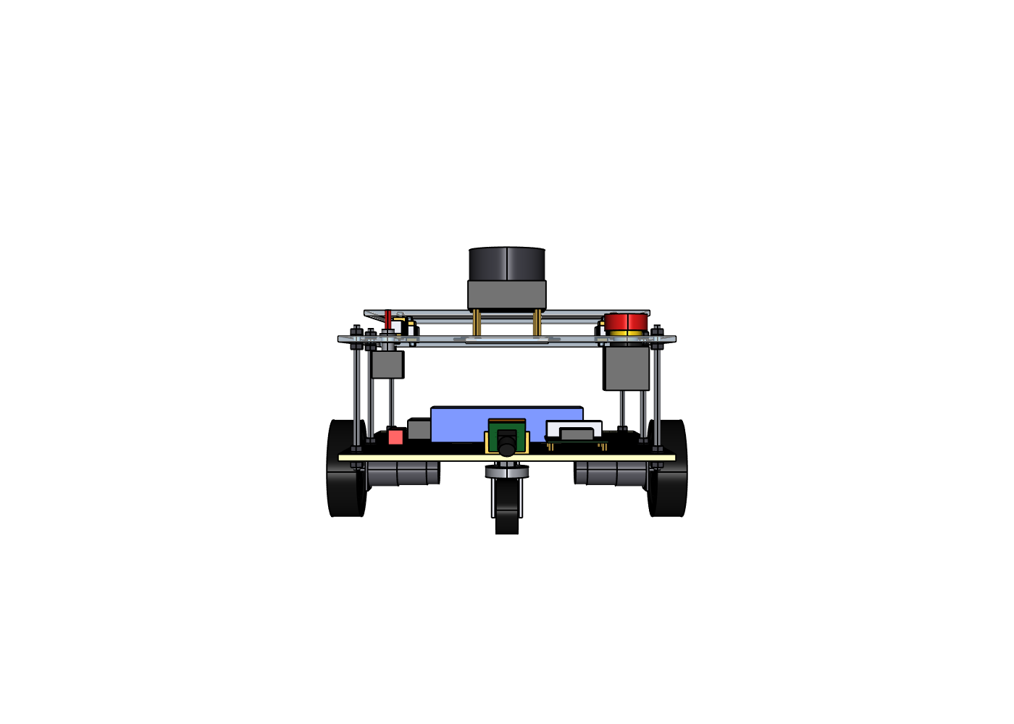
backup_v2/cad/output/views/render_front.png
