ahmedoab/cargo_robot/cad/autocad/previews/01_GENERAL_ARRANGEMENT.png

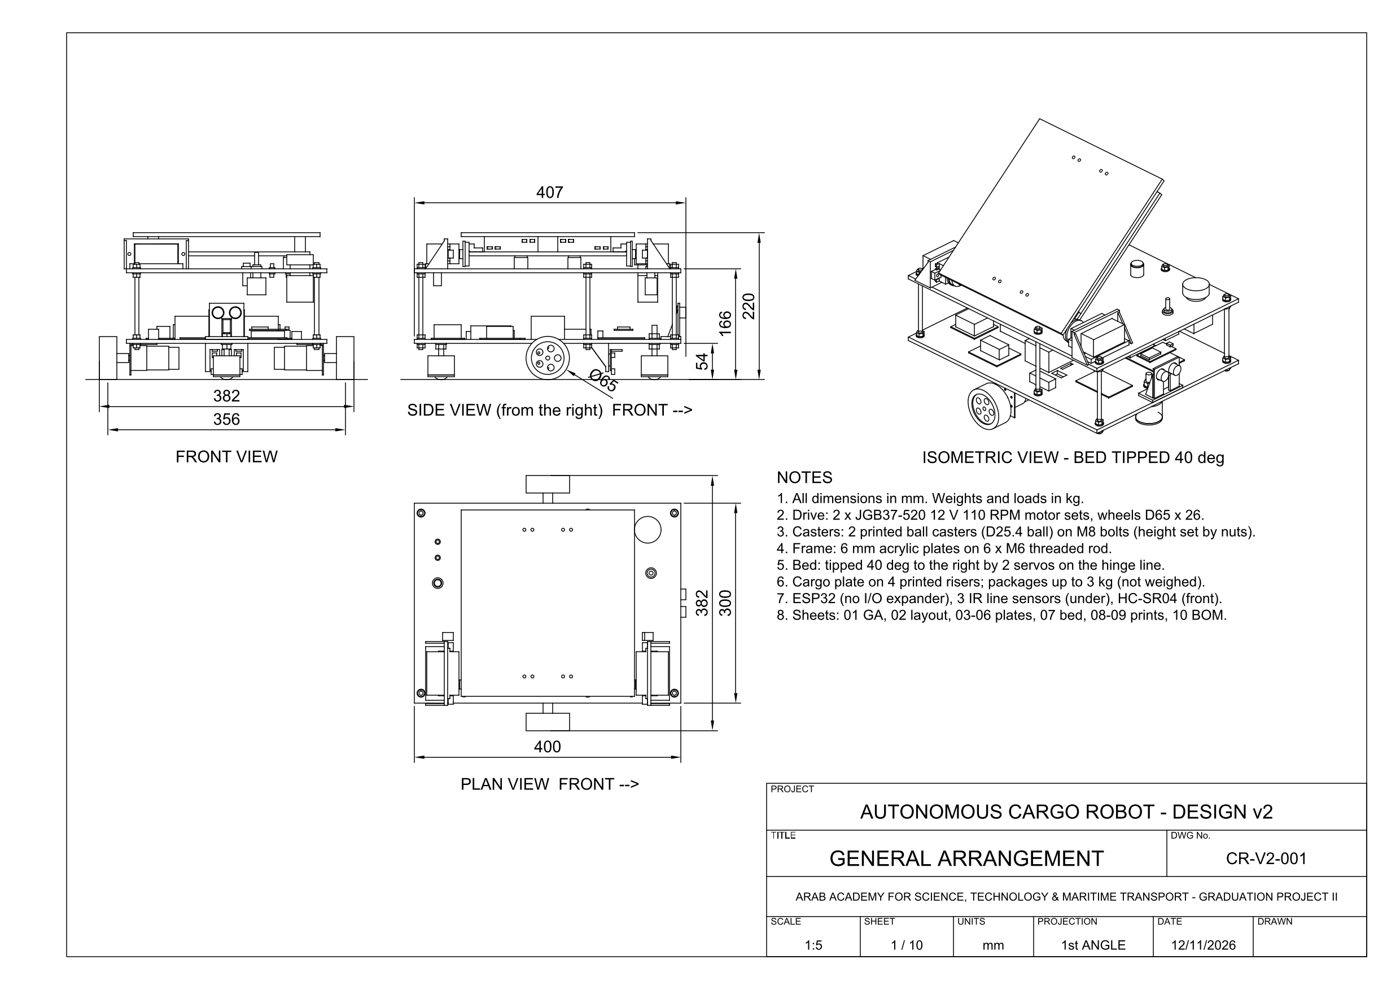
cad/autocad/previews/01_GENERAL_ARRANGEMENT.png
