ahmedoab/cargo_robot/cad/autocad/previews/02_LAYOUT_DECK_REMOVED.png

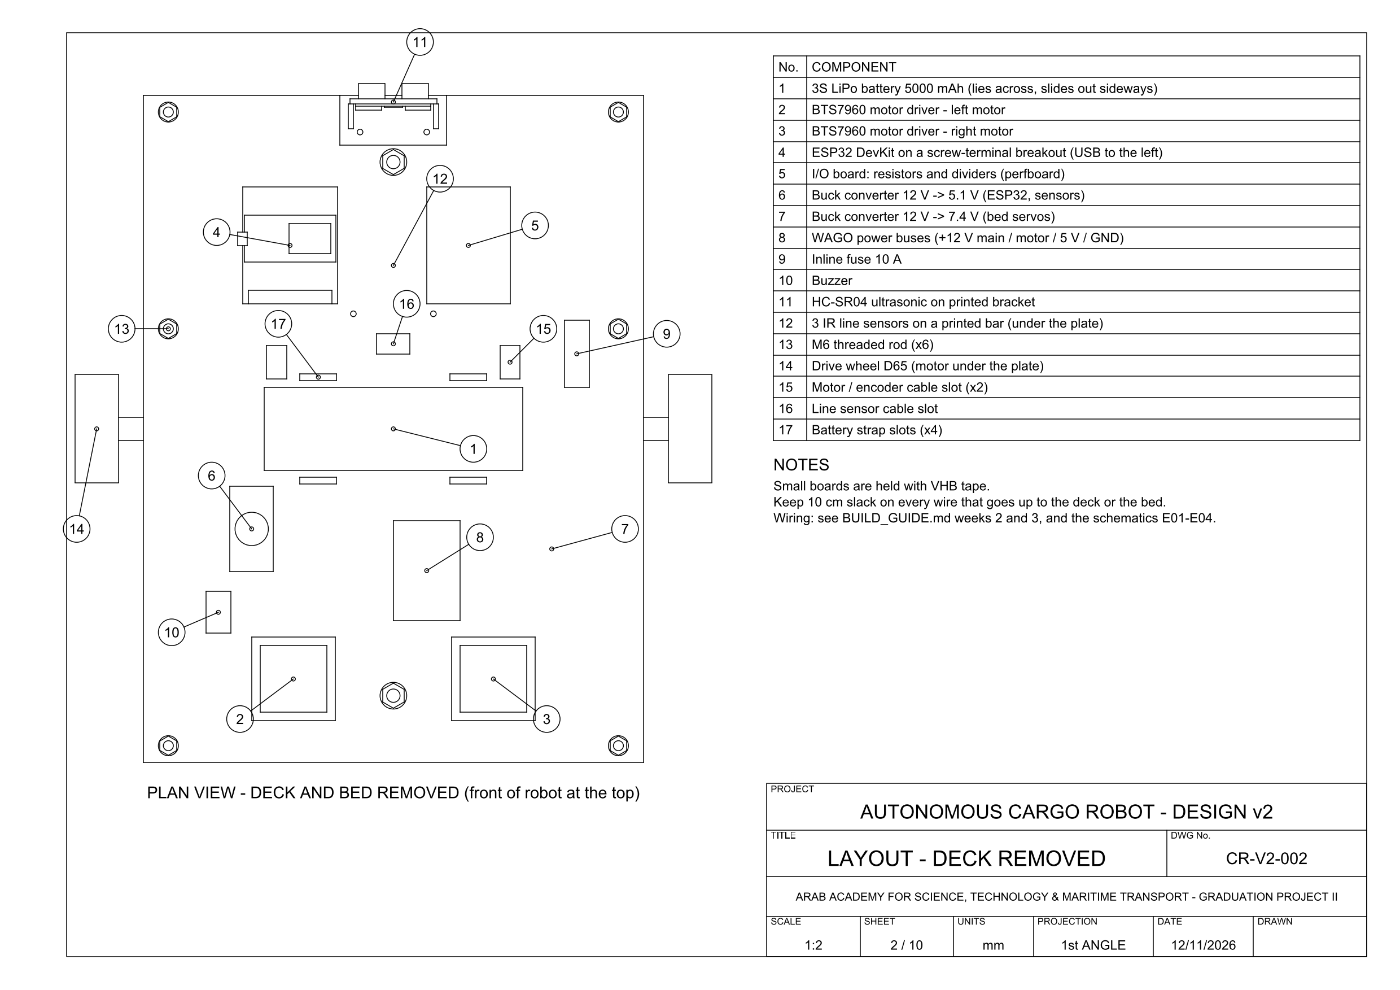
cad/autocad/previews/02_LAYOUT_DECK_REMOVED.png
