ahmedoab/cargo_robot/cad/autocad/previews/03_BOTTOM_PLATE.png

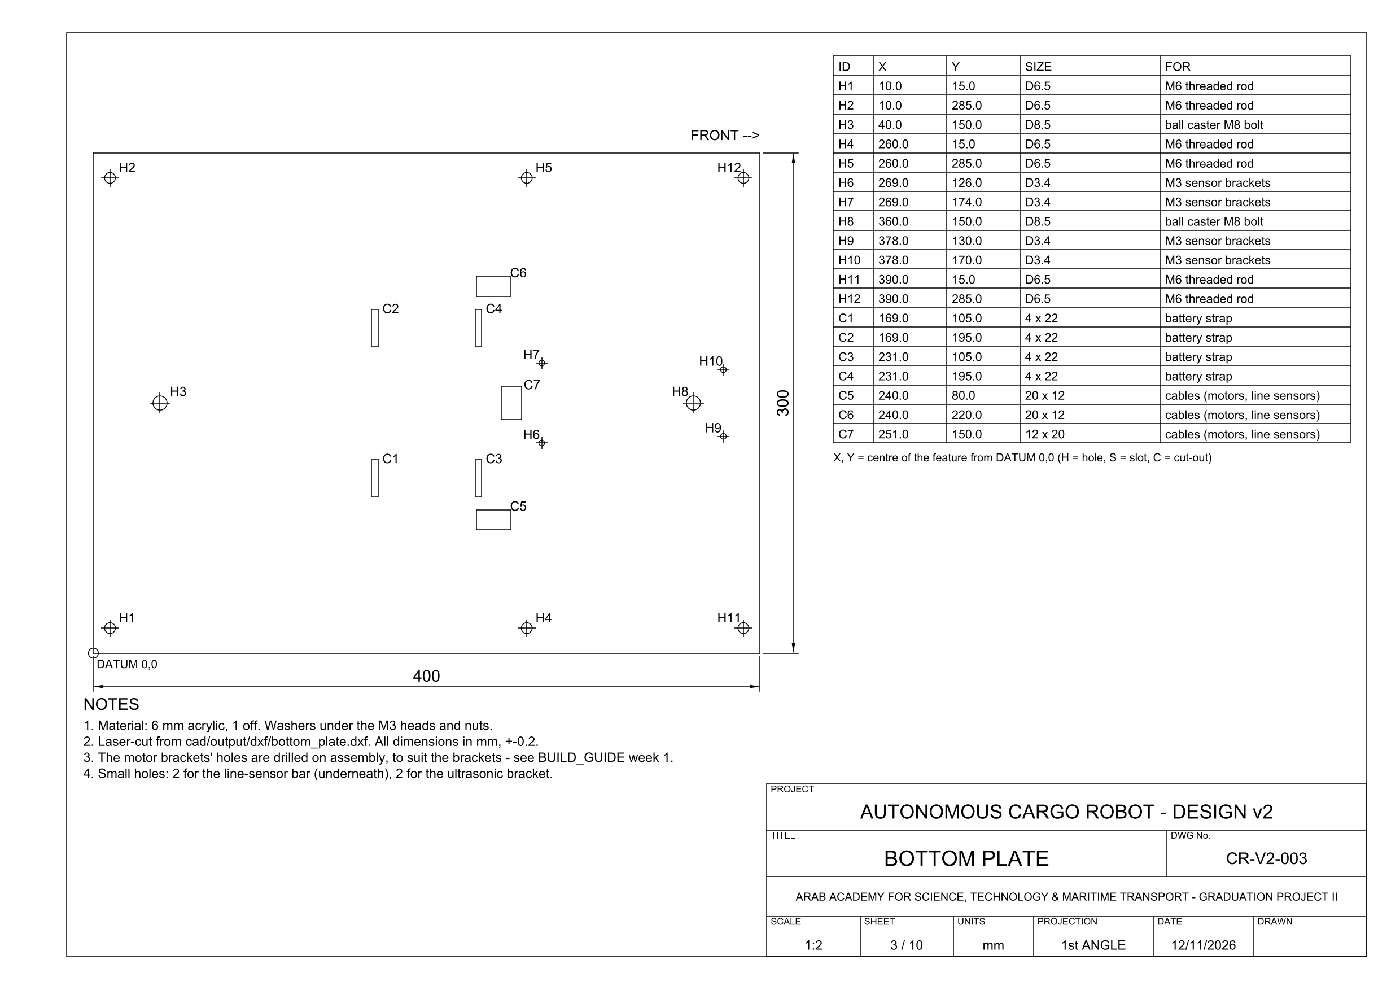
cad/autocad/previews/03_BOTTOM_PLATE.png
