ahmedoab/cargo_robot/cad/autocad/previews/04_TOP_DECK.png

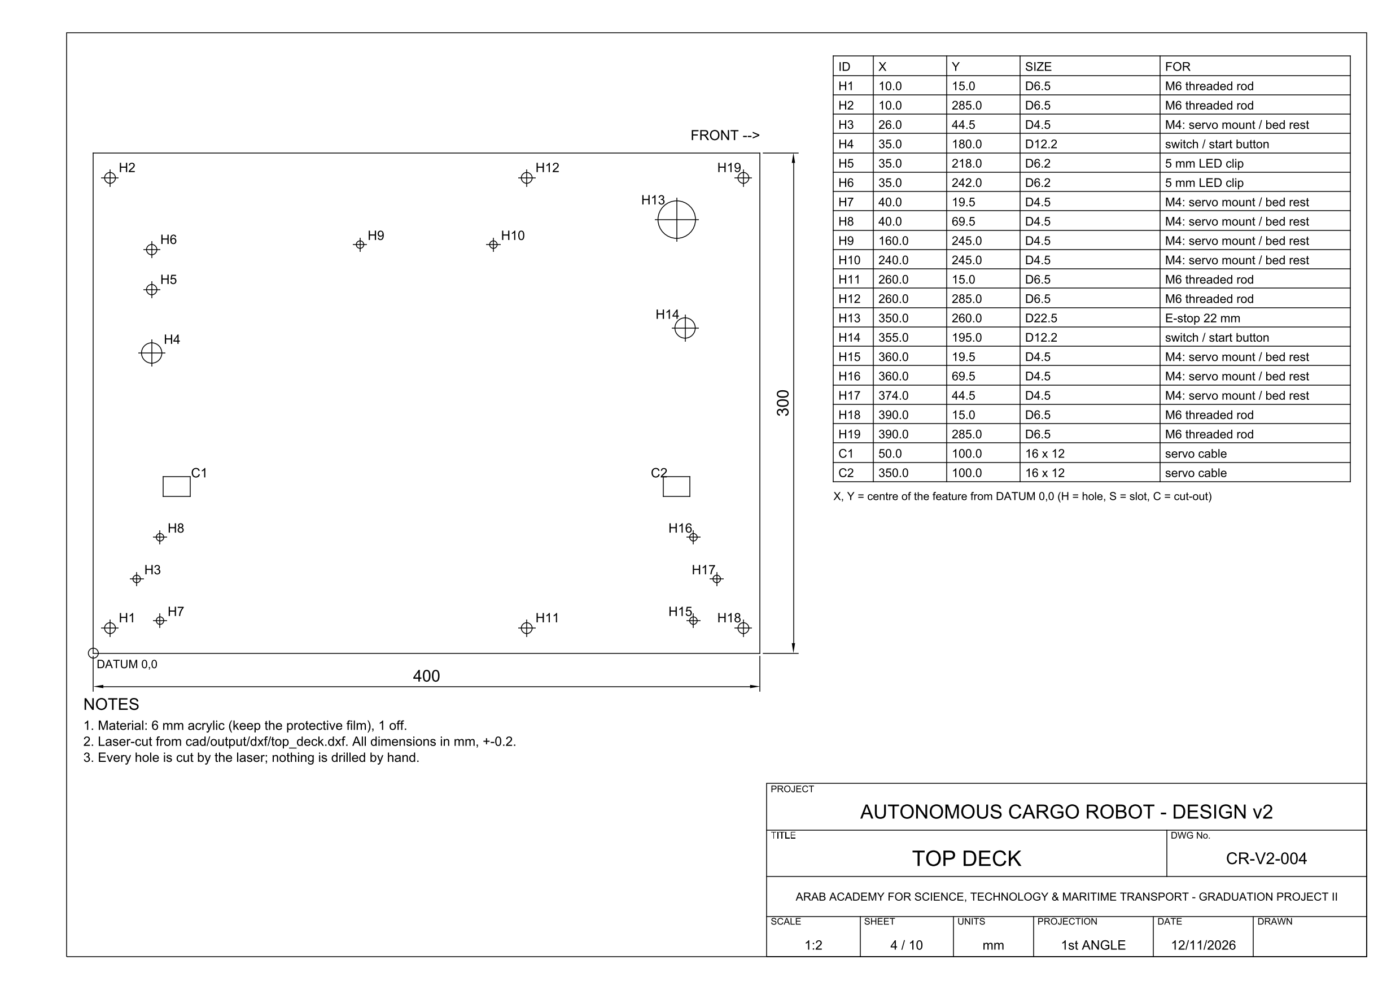
cad/autocad/previews/04_TOP_DECK.png
