ahmedoab/cargo_robot/cad/autocad/previews/05_TILTING_PLATE.png

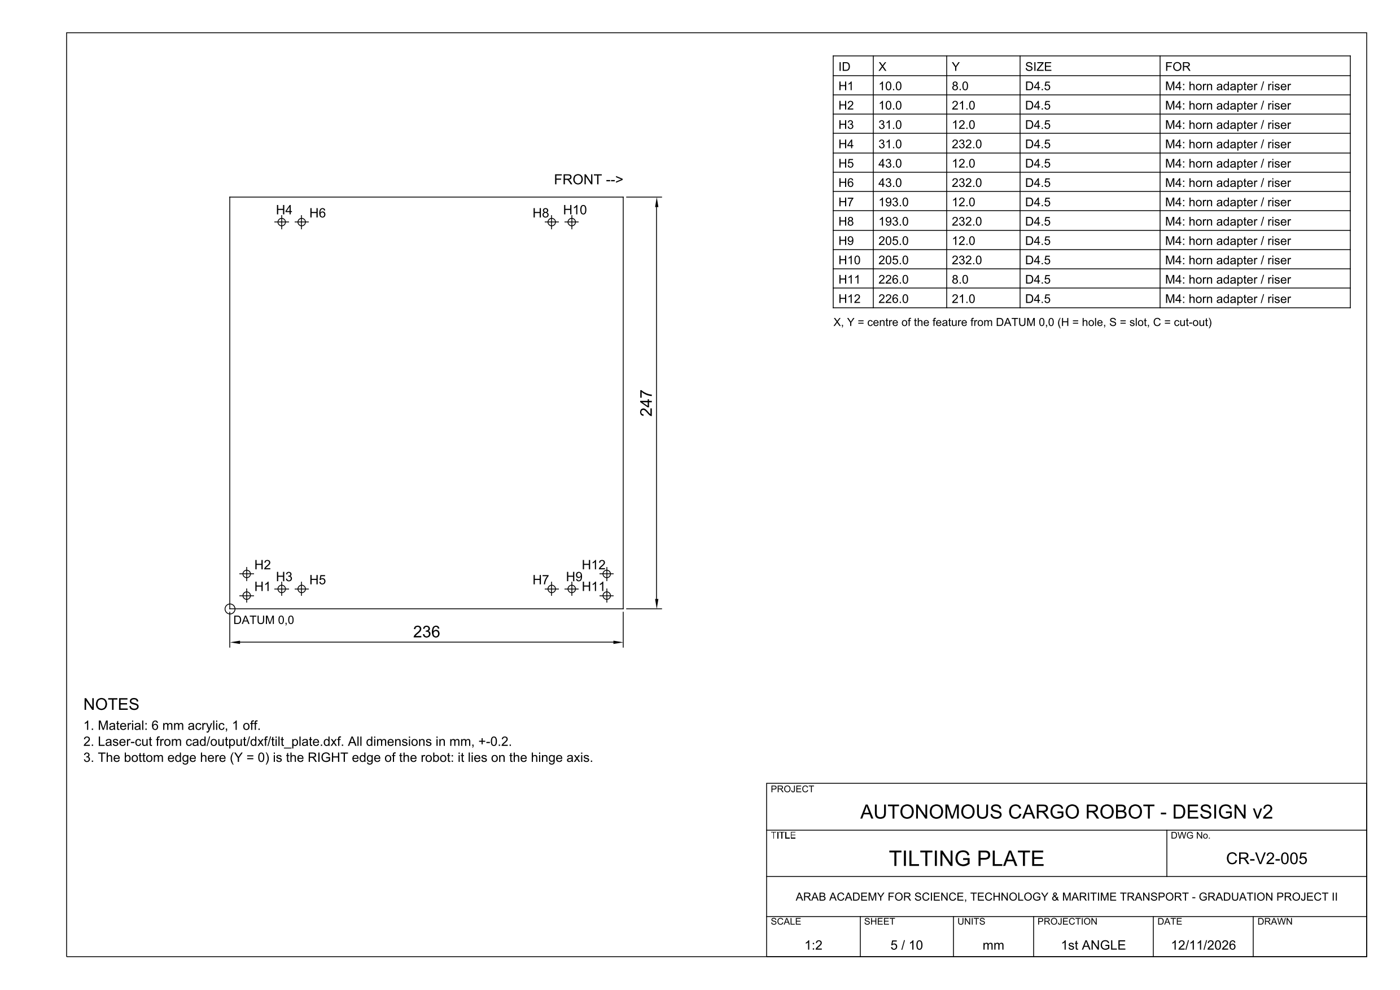
cad/autocad/previews/05_TILTING_PLATE.png
