ahmedoab/cargo_robot/cad/autocad/previews/06_CARGO_PLATE.png

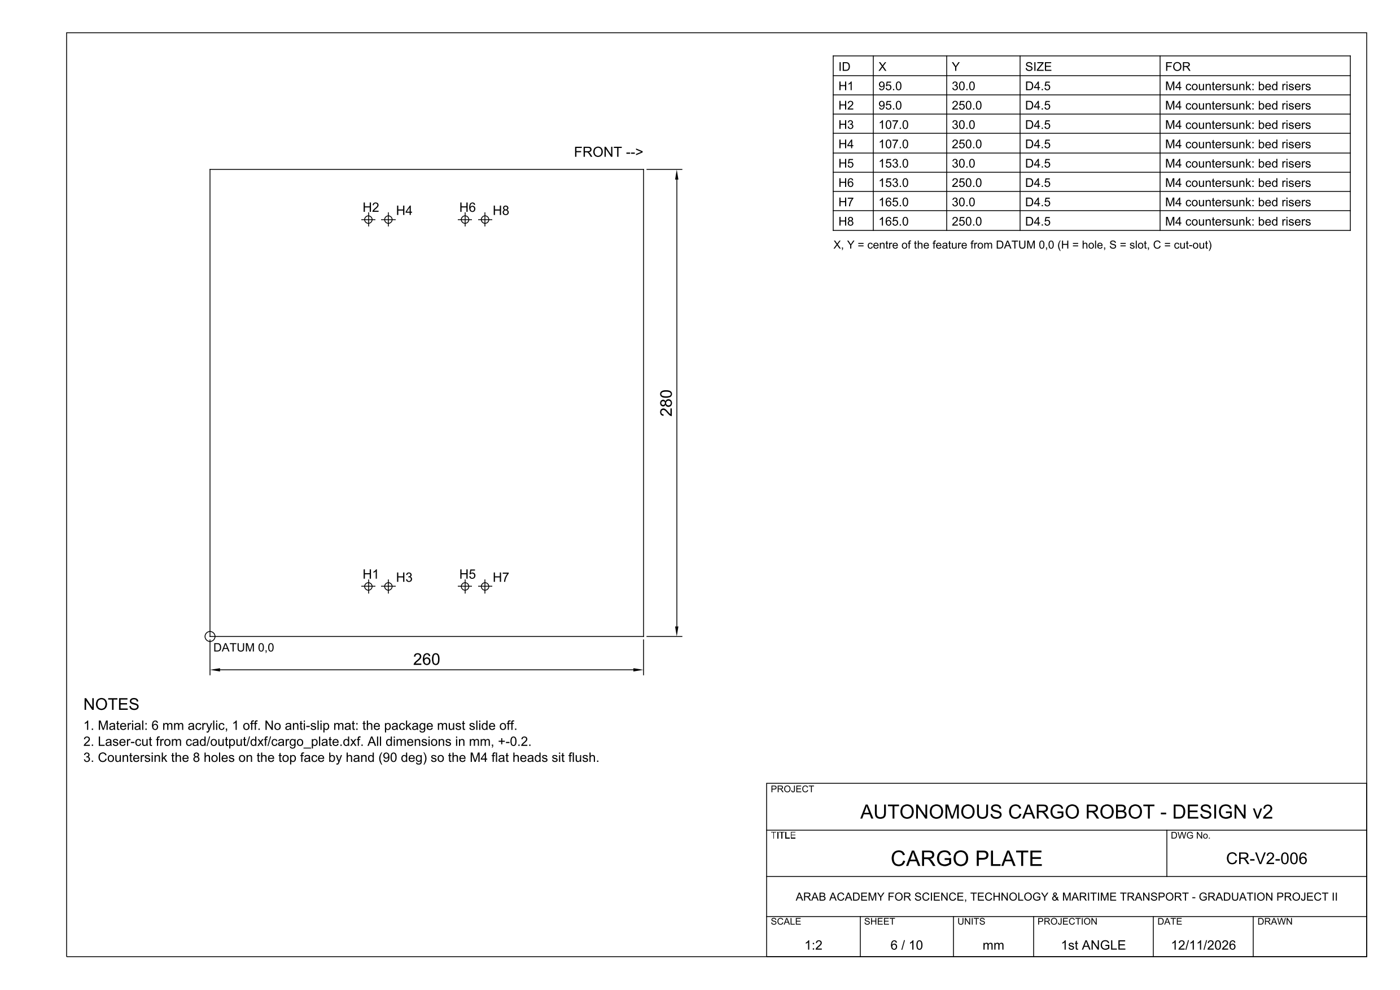
cad/autocad/previews/06_CARGO_PLATE.png
