ahmedoab/cargo_robot/cad/autocad/previews/07_PUSHER.png

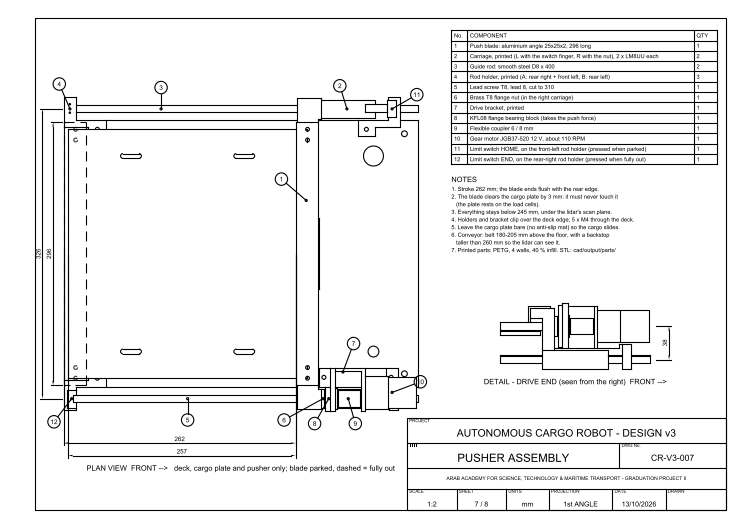
cad/autocad/previews/07_PUSHER.png
