ahmedoab/cargo_robot/cad/autocad/previews/07_TILTING_BED.png

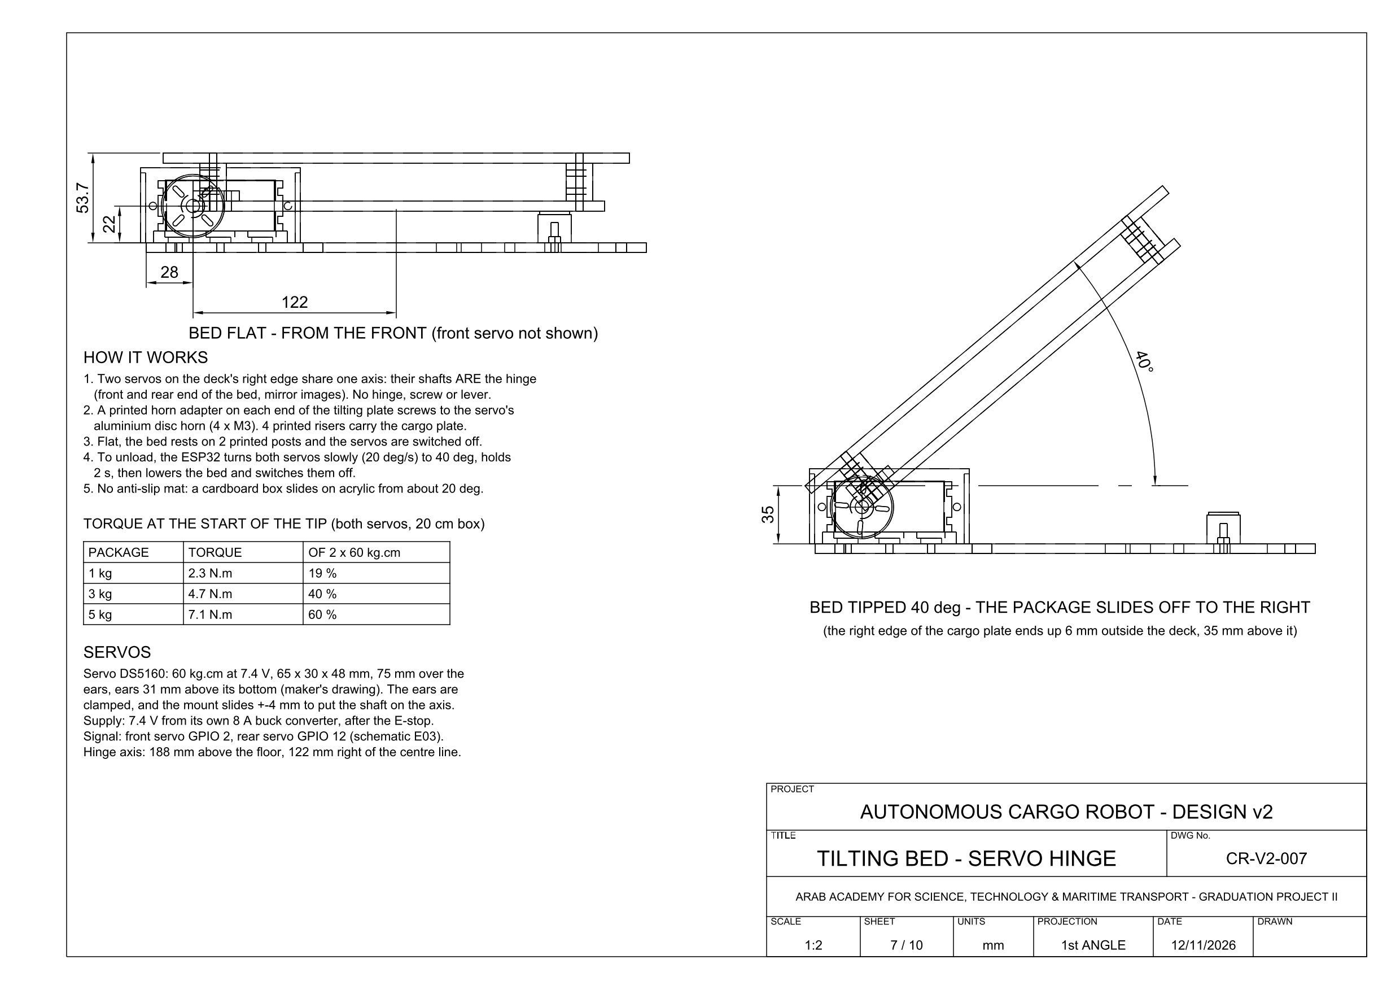
cad/autocad/previews/07_TILTING_BED.png
