ahmedoab/cargo_robot/cad/autocad/previews/E01_SYSTEM_BLOCK_DIAGRAM.png

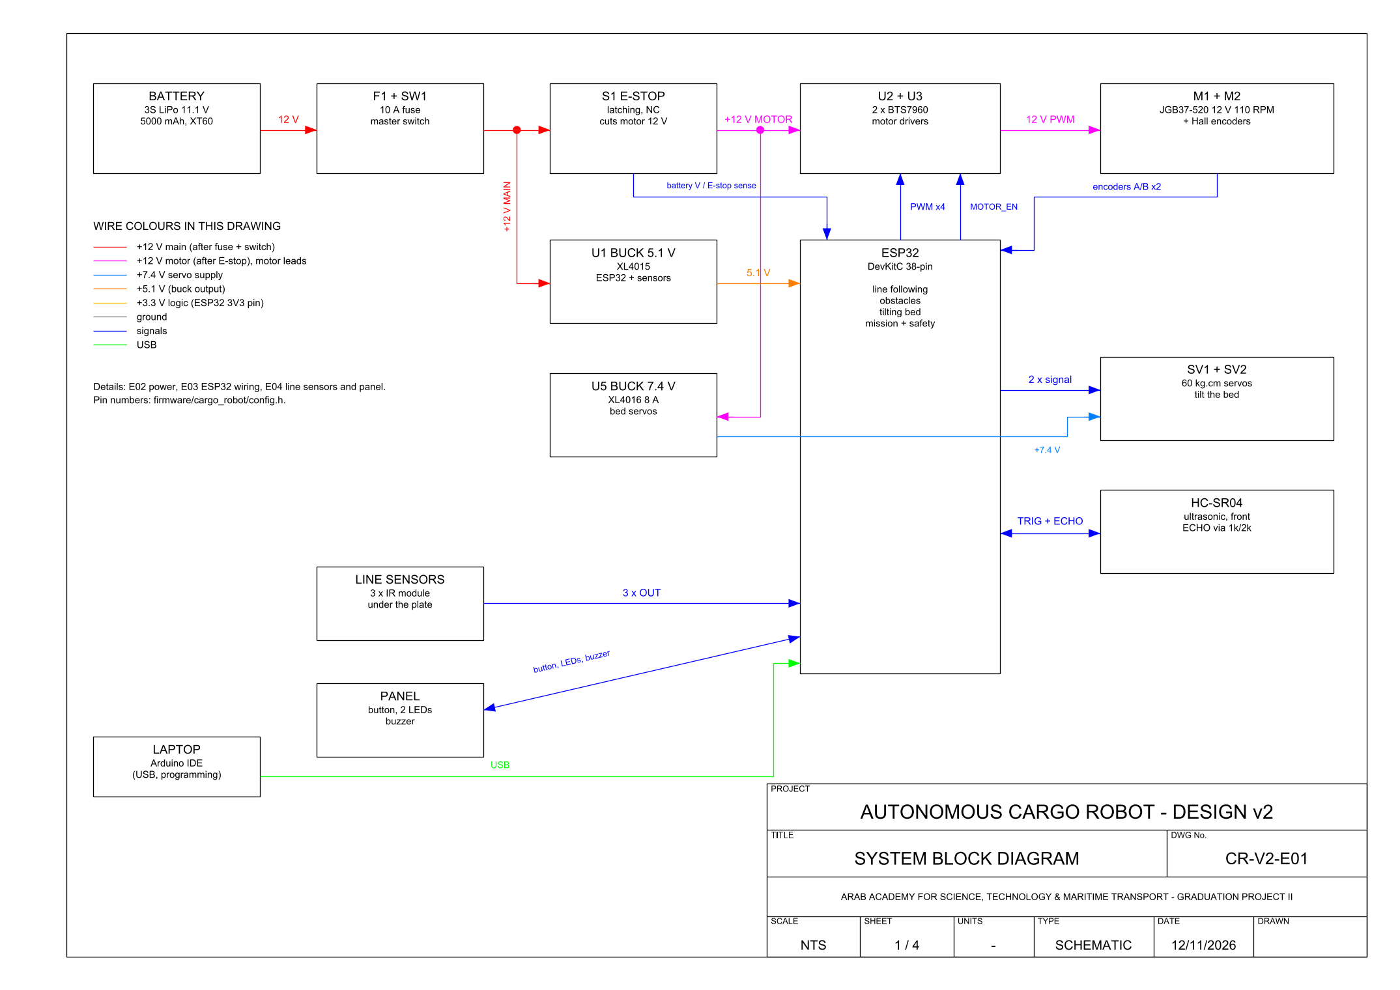
cad/autocad/previews/E01_SYSTEM_BLOCK_DIAGRAM.png
