ahmedoab/cargo_robot/cad/autocad/previews/E02_POWER_DISTRIBUTION.png

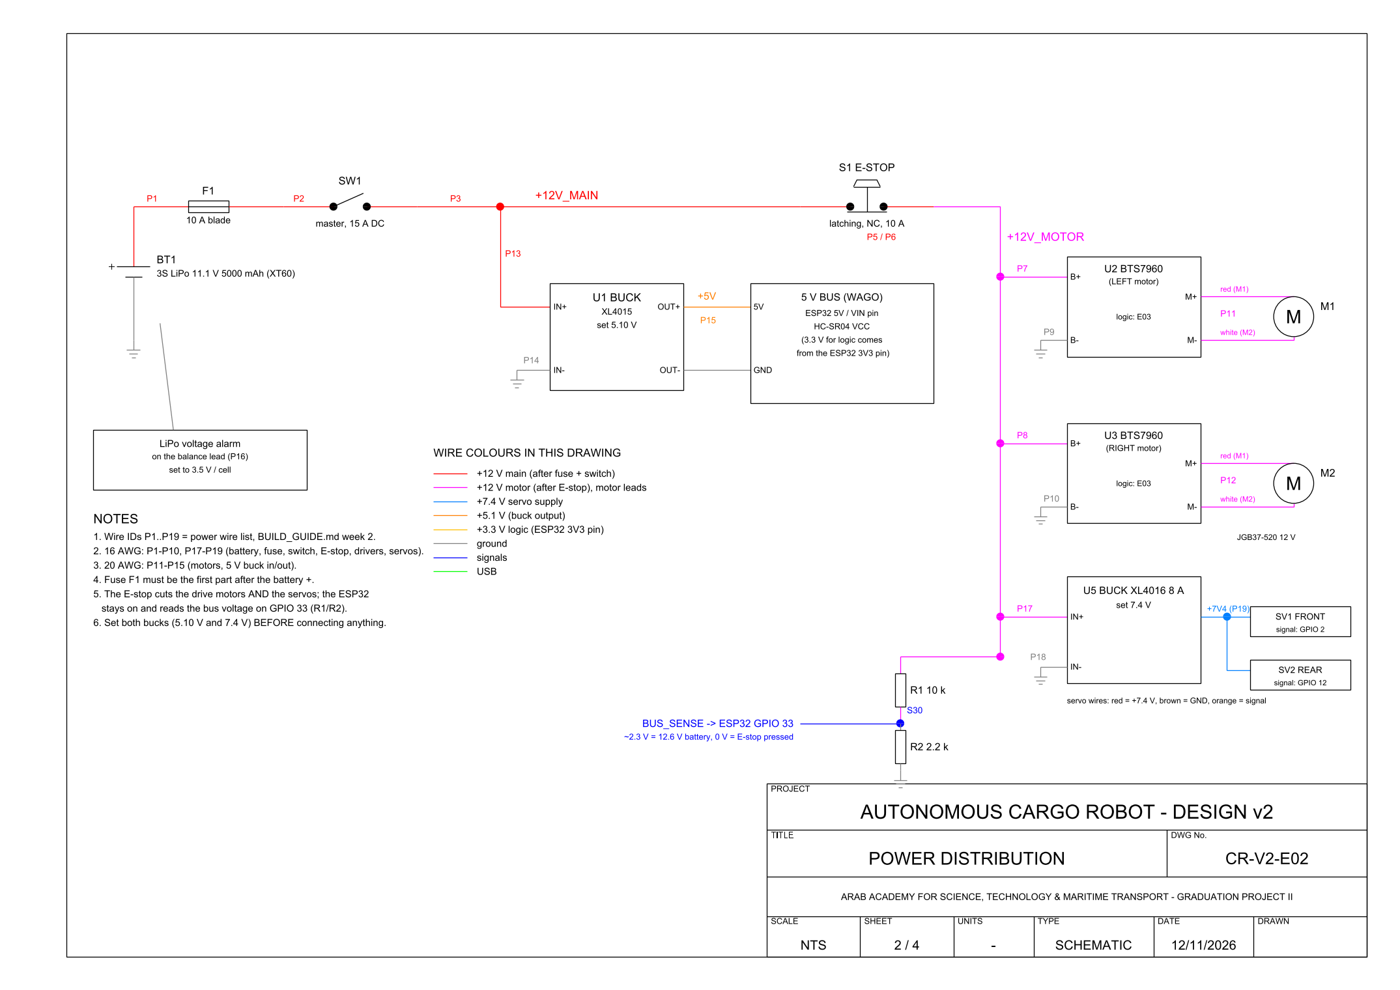
cad/autocad/previews/E02_POWER_DISTRIBUTION.png
