ahmedoab/cargo_robot/cad/autocad/previews/E04_I2C_LINE_SENSOR_AND_PANEL.png

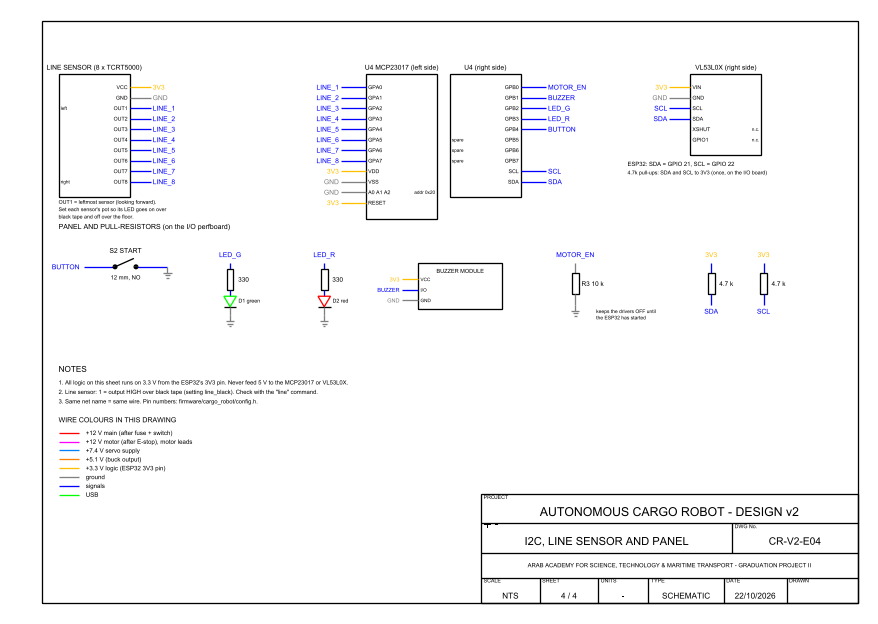
cad/autocad/previews/E04_I2C_LINE_SENSOR_AND_PANEL.png
