ahmedoab/cargo_robot/cad/autocad/previews/E04_LINE_SENSORS_AND_PANEL.png

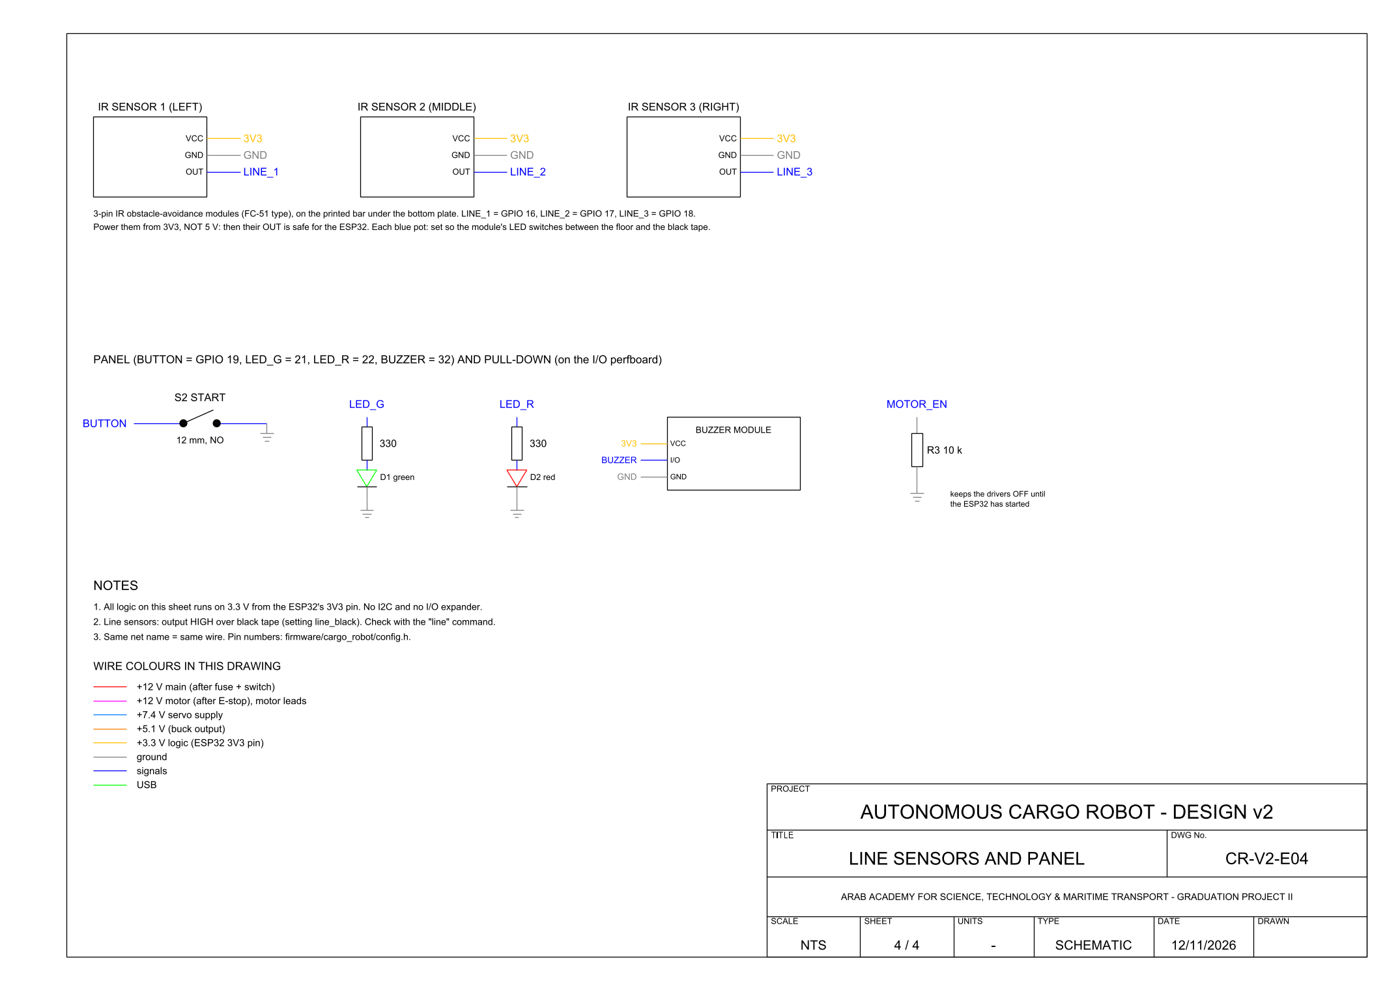
cad/autocad/previews/E04_LINE_SENSORS_AND_PANEL.png
