ahmedoab/cargo_robot/cad/output/views/render_front.png

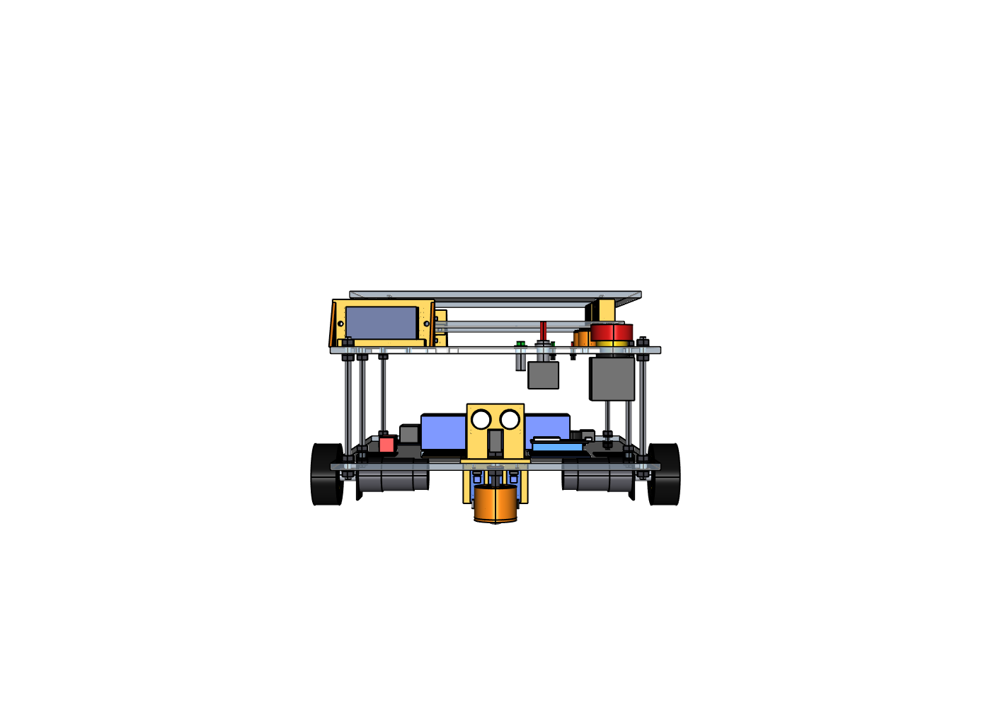
cad/output/views/render_front.png
