ahmedoab/cargo_robot/cad/output/views/render_layout.png

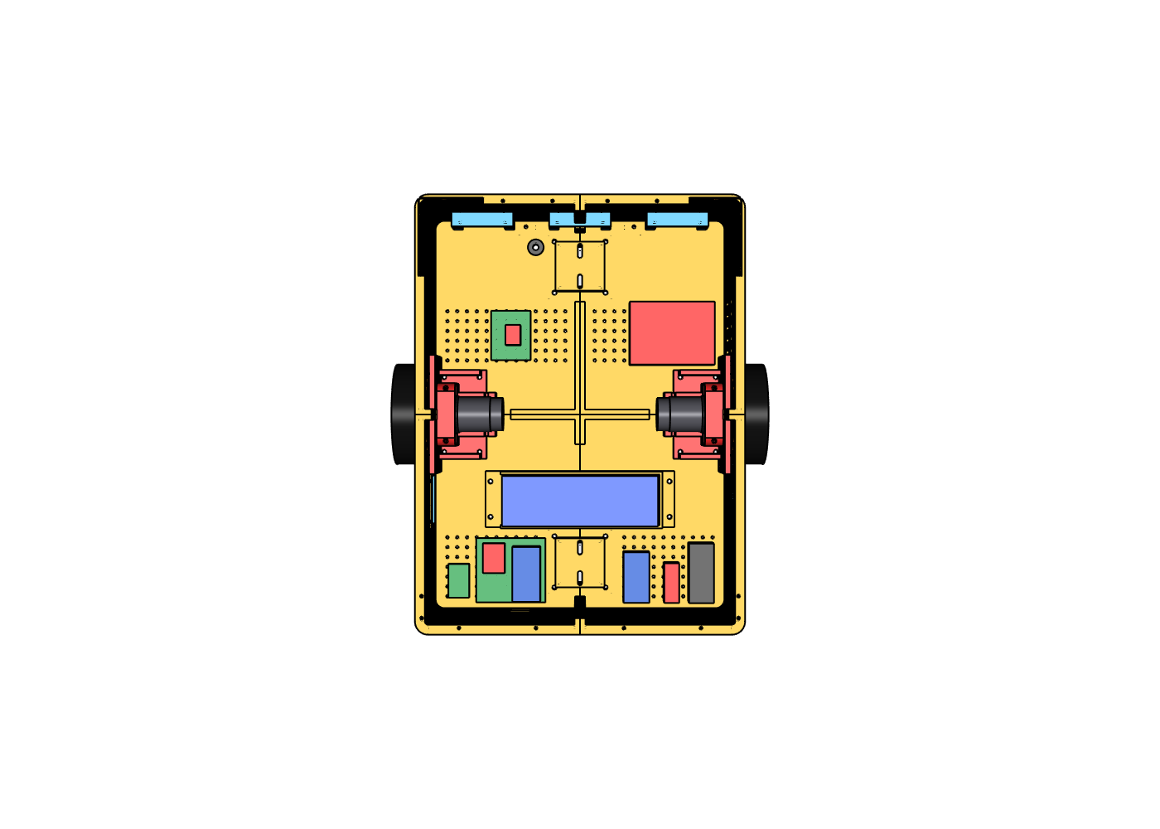
cad/output/views/render_layout.png
