ahmedoab/cargo_robot/cad/output/views/render_side.png

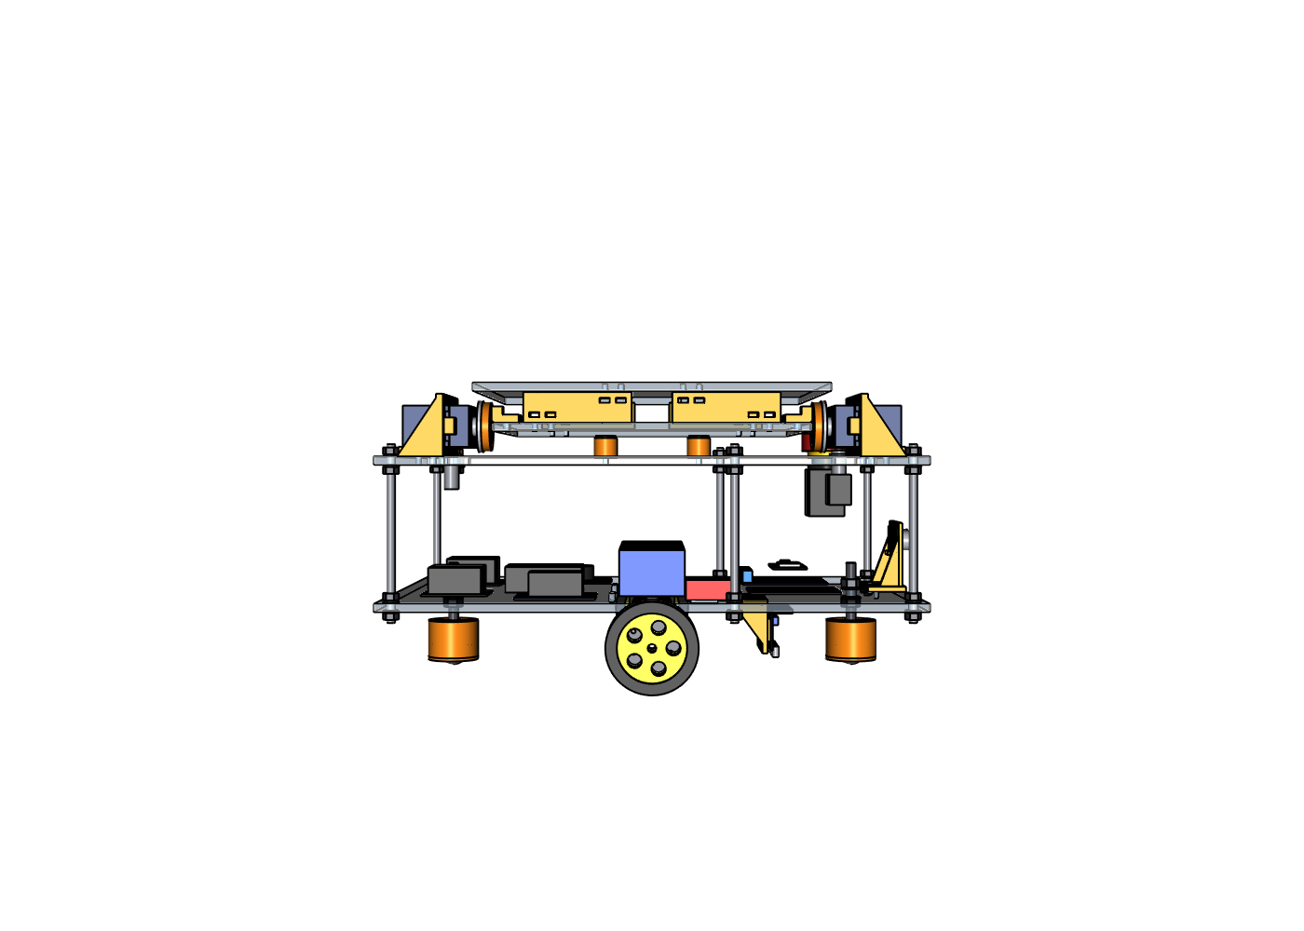
cad/output/views/render_side.png
