ahmedoab/cargo_robot/cad/output/views/render_tipped_front.png

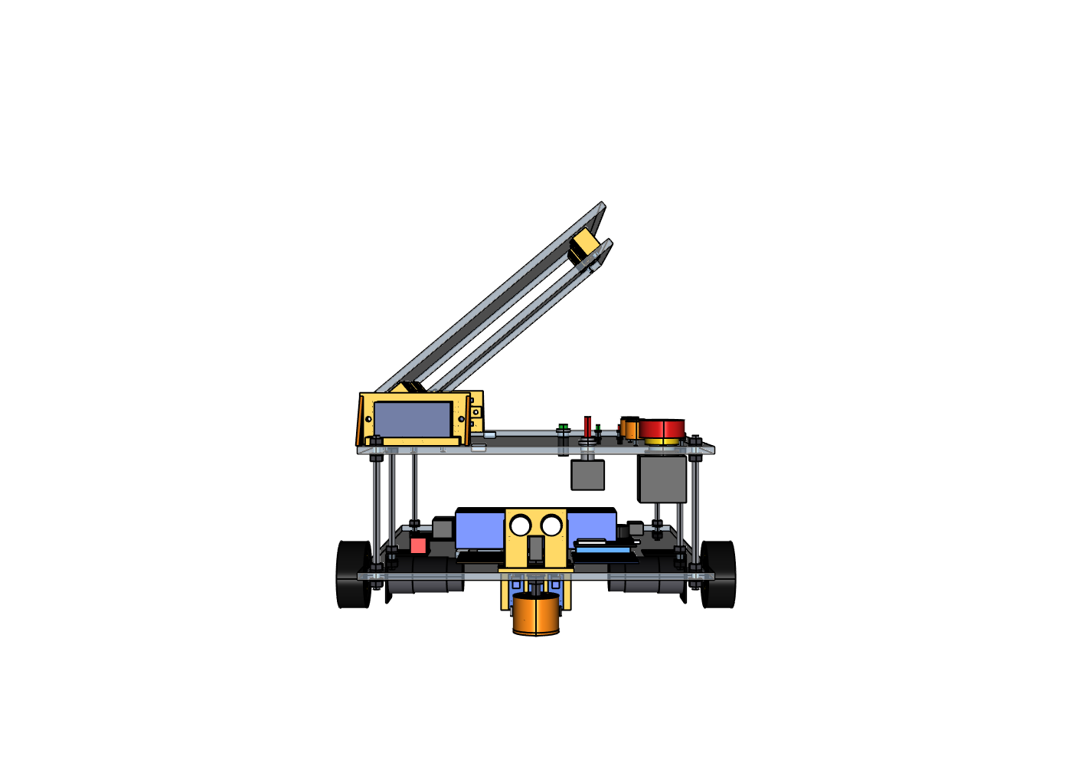
cad/output/views/render_tipped_front.png
