ahmedoab/cargo_robot/conveyor/output/views/render_end.png

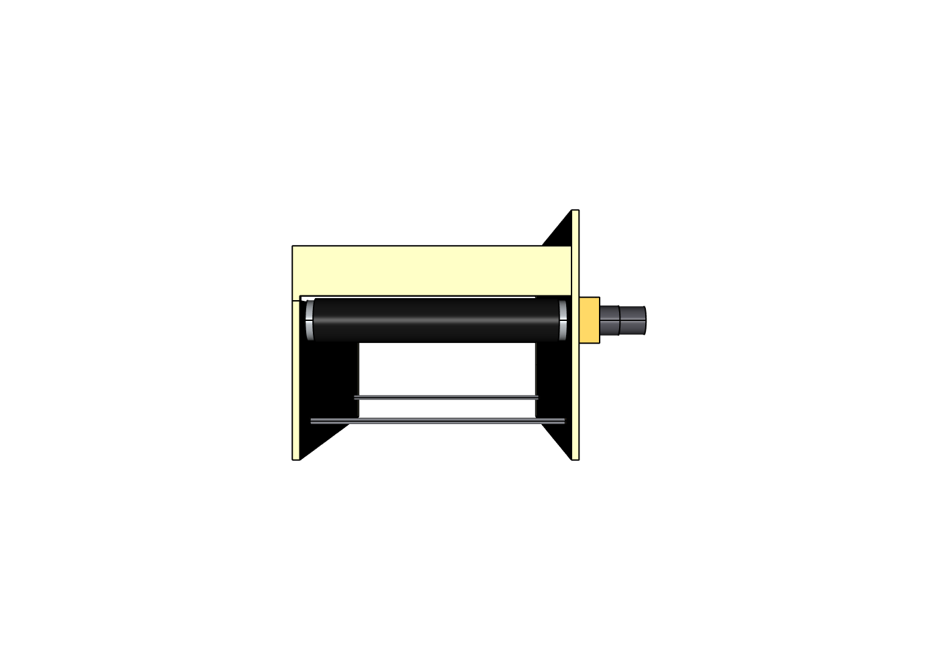
conveyor/output/views/render_end.png
