ahmedoab/cargo_robot/conveyor/output/views/render_iso_far.png

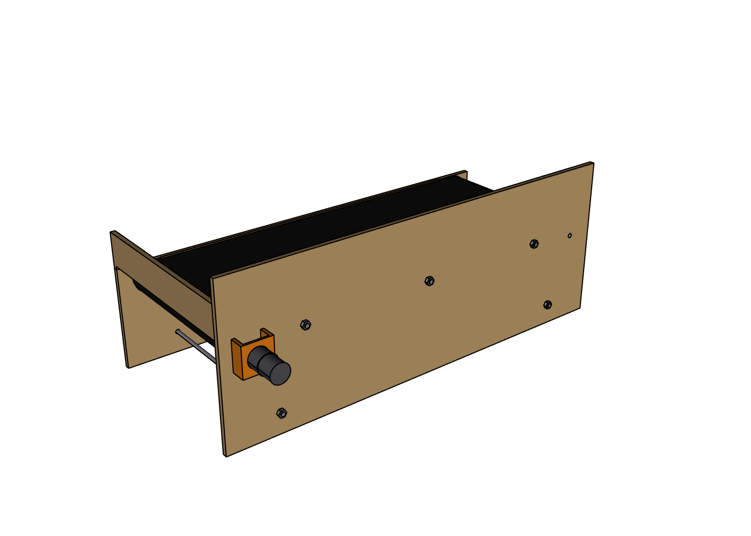
conveyor/output/views/render_iso_far.png
