ahmedoab/cargo_robot/conveyor/output/views/render_top.png

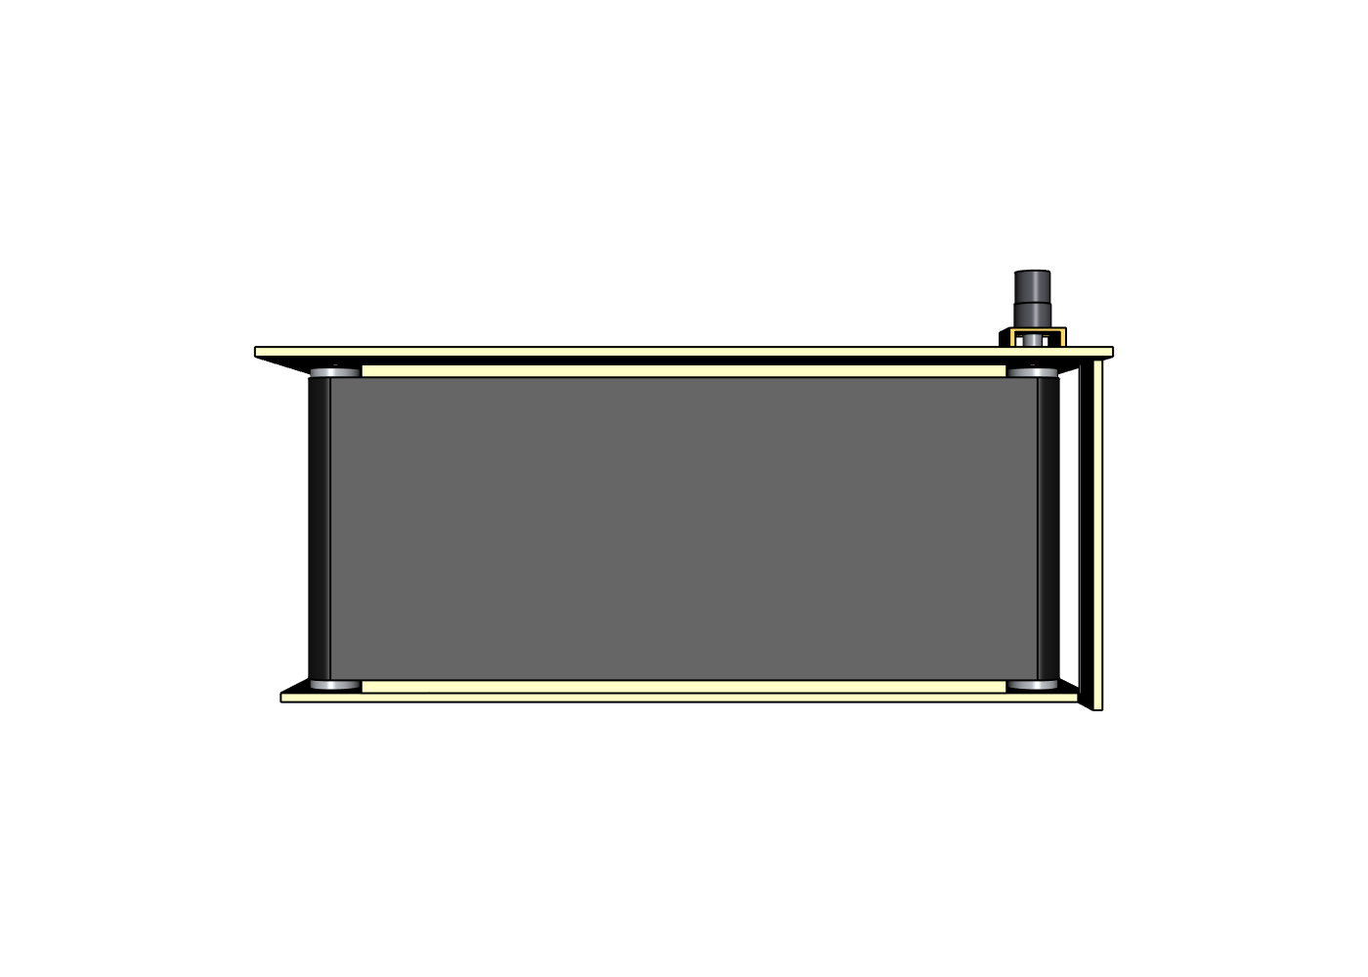
conveyor/output/views/render_top.png
