ahmedoab/cargo_robot/cad/output/bom.csv

Group | Item | Qty | Make/Buy
Compute | ESP32 DevKitC 38-pin (ESP32-WROOM-32, USB) + 38-pin screw-terminal breakout board | 1 | buy (get 2)
Drive | JGB37-520 12 V 110 RPM gear motor SET: motor with Hall encoder (6 wires) + steel bracket + hex coupling + 65 mm wheel | 2 | buy
Drive | BTS7960 (IBT-2) 43 A motor driver | 2 | buy
Drive | Ball caster: cup (caster_cup.stl) + ring (caster_ring.stl) | 2 | 3D print PETG
Drive | Steel bearing ball 25.4 mm (1 inch), or a 25 mm glass marble | 2 | buy (get 3)
Drive | M8 x 50 bolt + 2 M8 nuts + 2 M8 washers (one set per caster) | 2 | buy
Sensors | IR obstacle-avoidance module, 3 pins (VCC, GND, OUT), one blue pot (FC-51 / HW-201 type) | 3 | buy (get 4)
Sensors | Line sensor bar (line_sensor_bar.stl) | 1 | 3D print PETG
Sensors | HC-SR04 ultrasonic distance sensor | 1 | buy (get 2)
Sensors | Ultrasonic sensor bracket (sonar_bracket.stl) | 1 | 3D print PETG
Tilting bed | Cargo plate 260x280x6 (cargo_plate.dxf) | 1 | laser-cut 6 mm acrylic
Tilting bed | Bed riser (bed_riser.stl) | 4 | 3D print PETG
Tilting bed | Tilting plate 236x247x6 (tilt_plate.dxf) | 1 | laser-cut 6 mm acrylic
Tilting bed | Servo DS5160, 60 kg.cm, metal gears, 180 deg, 6-8.4 V, 65 x 30 x 48 mm | 2 | buy
Tilting bed | Aluminium DISC servo horn for the servo's spline (25T on most DS5160), 38 mm or smaller (not the 4-arm horn: its arms hit the deck) | 2 | buy
Tilting bed | Servo mount (servo_mount_front.stl + servo_mount_rear.stl) | 2 | 3D print PETG
Tilting bed | Servo ear clamp (servo_clamp.stl) | 4 | 3D print PETG
Tilting bed | Horn adapter (horn_adapter_front.stl + horn_adapter_rear.stl) | 2 | 3D print PETG 100 %
Tilting bed | Bed rest post (bed_rest.stl) + 18 mm self-adhesive rubber pad 2 mm | 2 | 3D print PETG
Tilting bed | Buck converter XL4016 8 A, set to 7.4 V for the servos | 1 | buy
Power | 3S LiPo 11.1 V 5000 mAh XT60 + balance charger + LiPo bag + voltage alarm | 1 | buy
Power | XL4015 5 A buck converter (5.1 V for the ESP32 and sensors) | 1 | buy
Power | Inline fuse holder + 10 A fuses, WAGO 221 connectors, XT60 pairs | 1 | buy
Power | Emergency stop 22 mm panel-mount, latching, NC contact block (must clamp a 6 mm panel) | 1 | buy
Power | Toggle switch 12 mm panel-mount, 12 V DC >= 15 A, thread >= 9 mm (6 mm deck) | 1 | buy
Controls | Push button 12 mm panel-mount, momentary, normally open (start), thread >= 9 mm | 1 | buy
Controls | 5 mm LED green + red, with panel clips for a 6 mm panel (or hot glue), + 330 ohm resistors | 1 | buy
Controls | Active buzzer module, 3-pin, 3.3-5 V | 1 | buy
Chassis | Bottom plate 400x300x6 (bottom_plate.dxf) | 1 | laser-cut 6 mm acrylic
Chassis | Top deck 400x300x6 (top_deck.dxf) | 1 | laser-cut 6 mm acrylic
Chassis | M6 threaded rod, cut to 130 mm | 6 | cut from 1 m rod
Chassis | M6 nut + M6 washer | 24 | buy
Hardware | M4: x10 (bed rests, 2), x12 (servo mounts, 6, NO washer), x16 (servo ear clamps, 4), x20 (horn adapters 4 + risers from below 8), x20 COUNTERSUNK (risers through the cargo plate, 8); 32 M4 nuts; 32 M4 washers | 1 | buy
Hardware | M3: x8 (servo horns, 8), x8 countersunk (caster rings, 6), x12 + nut (motor brackets 8, holes drilled by hand; IR modules 3), x16 + nut (line sensor bar 2, sonar bracket 2); 30 M3 washers | 1 | buy
Hardware | Resistors 1k x1, 2k x1, 10k x5, 2.2k x1, 100 nF x1, small perfboard; VHB tape, velcro strap, zip ties, a little grease (casters) | 1 | buy
