ahmedoab/cargo_robot/backup_v2/cad/autocad/previews/06_PRINTED_PARTS.png

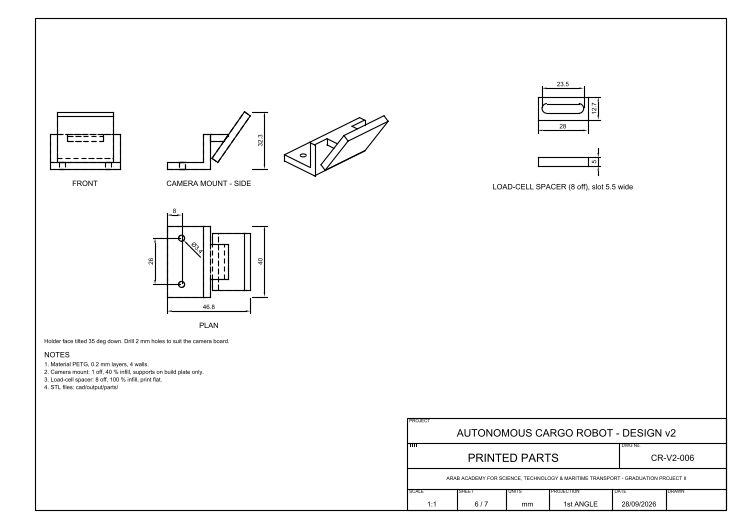
backup_v2/cad/autocad/previews/06_PRINTED_PARTS.png
