ahmedoab/cargo_robot/cad/autocad/previews/08_BILL_OF_MATERIALS.png

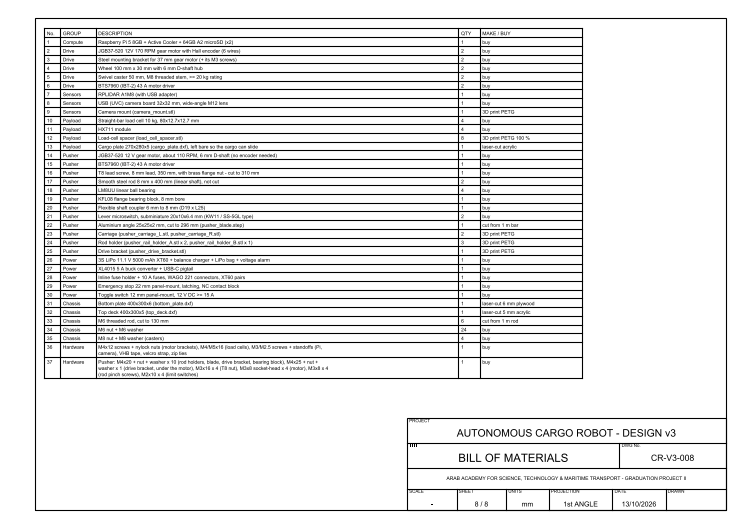
cad/autocad/previews/08_BILL_OF_MATERIALS.png
