ahmedoab/cargo_robot/cad/autocad/previews/08_PRINTED_PARTS_1.png

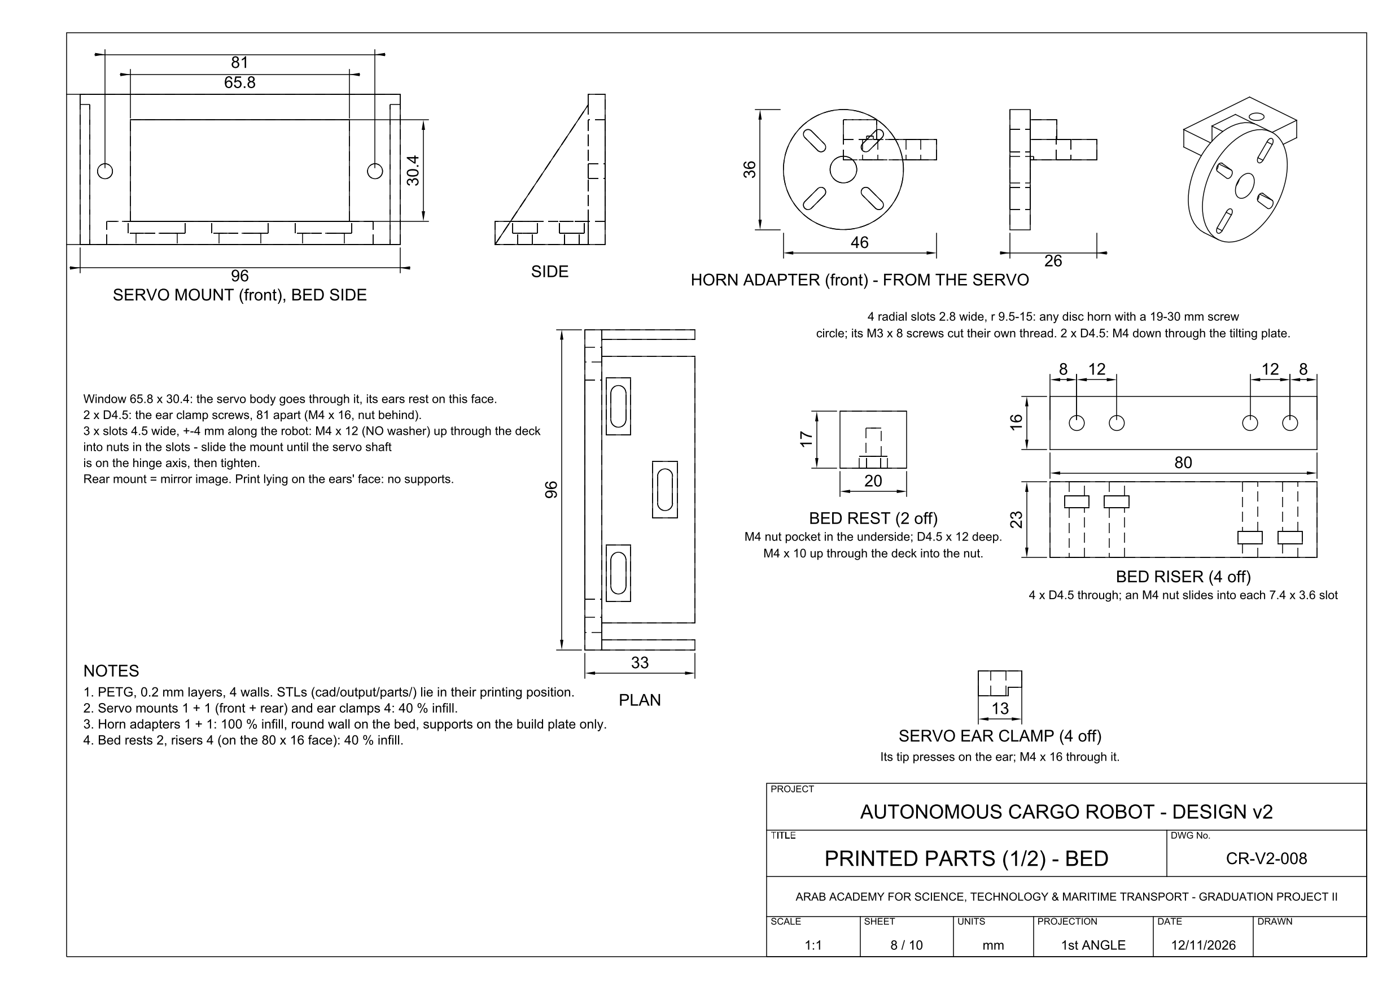
cad/autocad/previews/08_PRINTED_PARTS_1.png
