ahmedoab/cargo_robot/cad/autocad/previews/09_PRINTED_PARTS_2.png

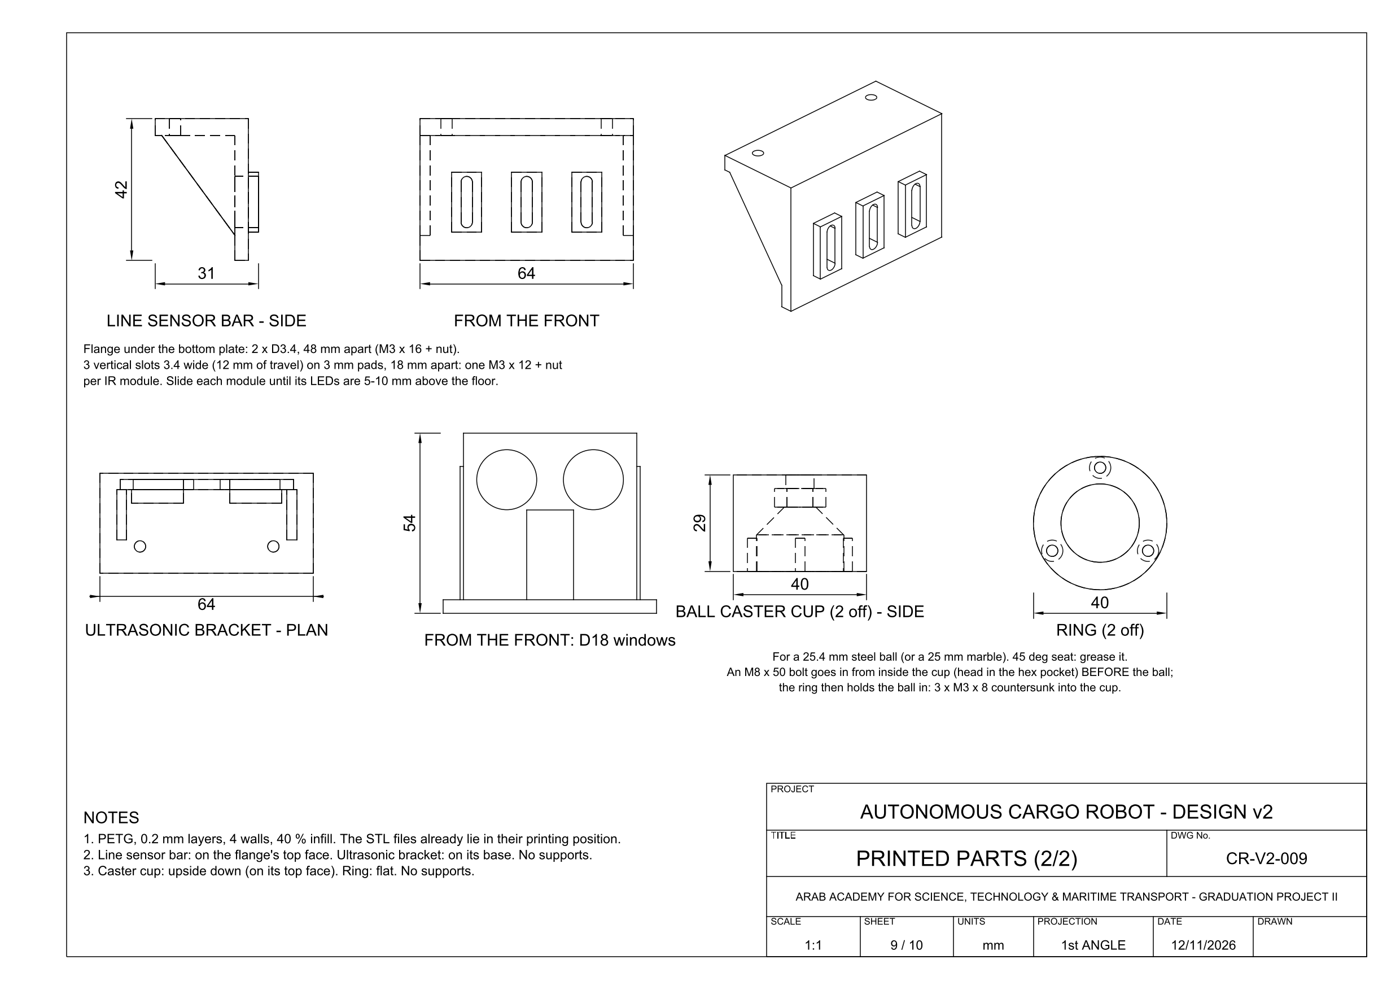
cad/autocad/previews/09_PRINTED_PARTS_2.png
