ahmedoab/cargo_robot/cad/autocad/previews/10_BILL_OF_MATERIALS.png

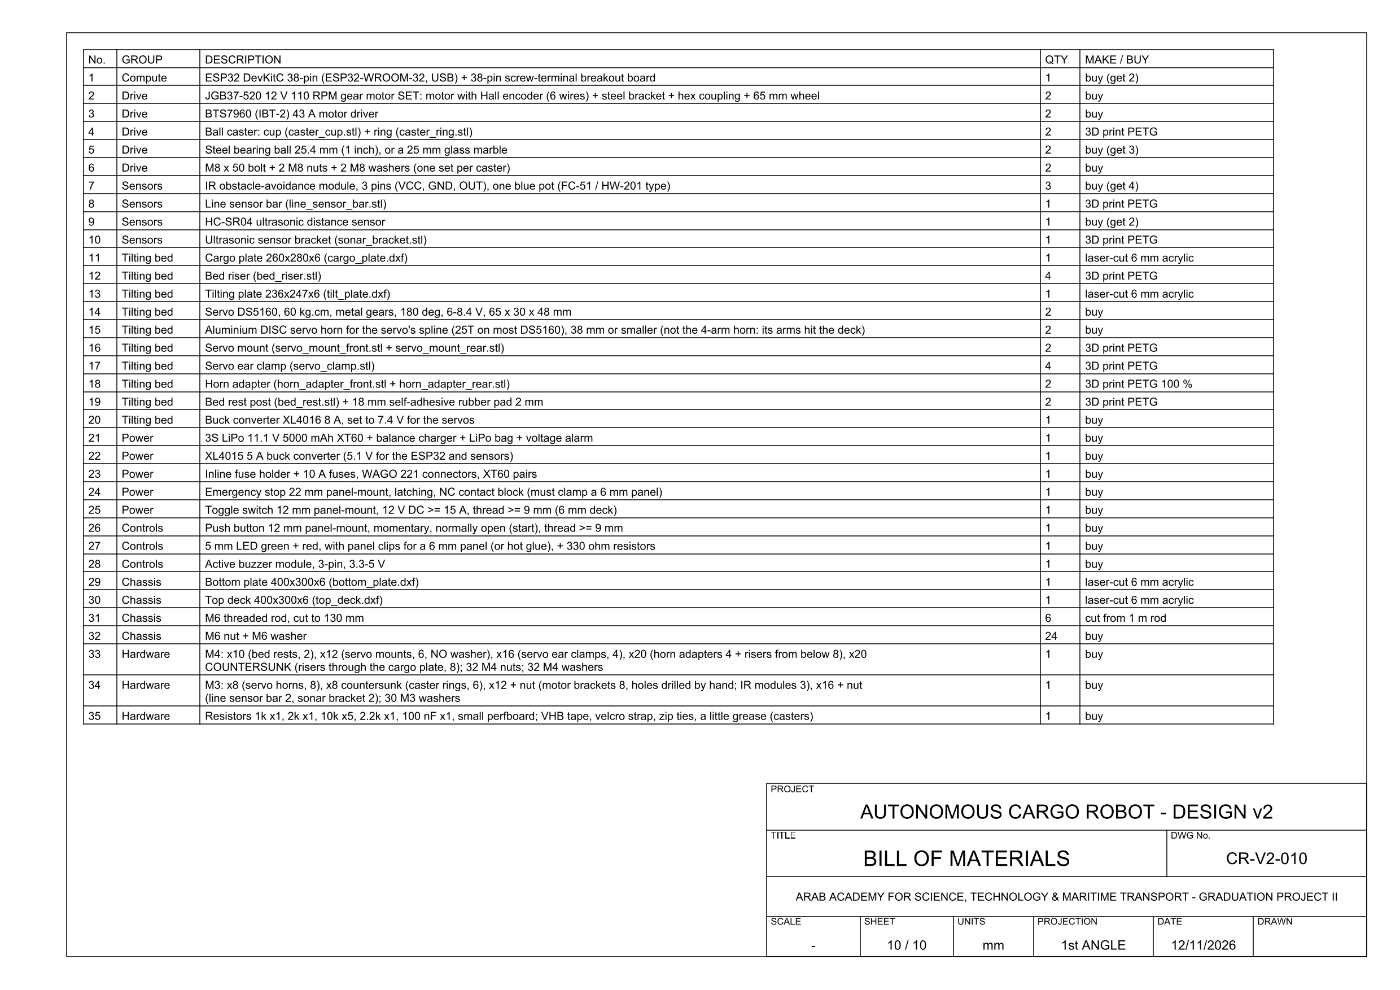
cad/autocad/previews/10_BILL_OF_MATERIALS.png
