ahmedoab/cargo_robot/cad/output/robot_assembly_tipped.step

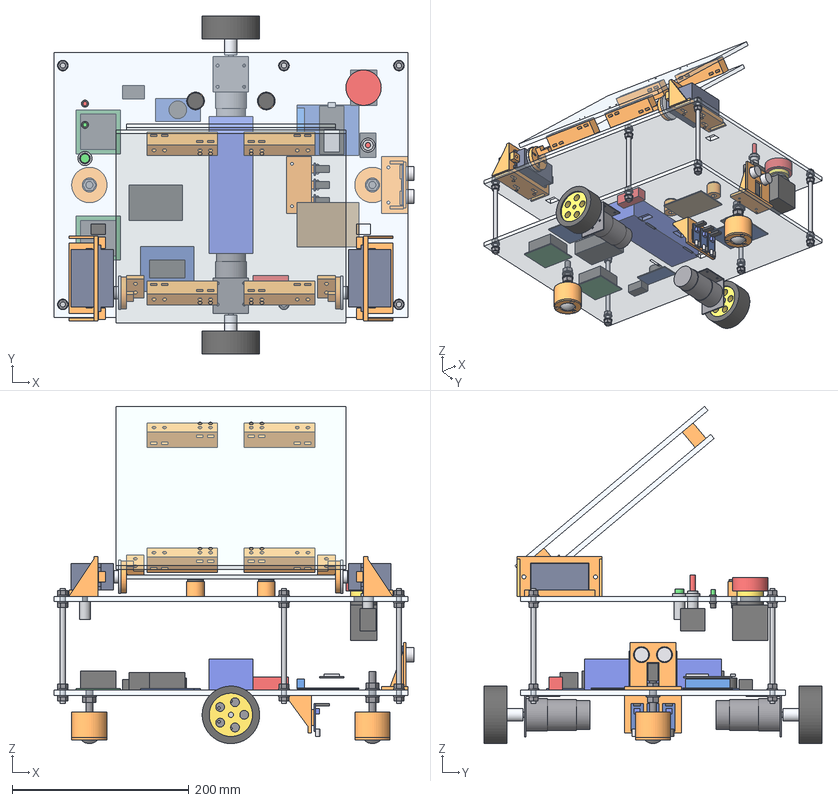
[picture p44: CAD file, 2026-11-12]
cad/output/robot_assembly_tipped.step
407.0 x 382.0 x 381.2 mm
bottom_plate
top_deck
rod_0
rod_nuts_0
rod_1
rod_nuts_1
rod_2
rod_nuts_2
rod_3
rod_nuts_3
rod_4
rod_nuts_4
rod_5
rod_nuts_5
motor_bracket_L
motor_bracket_R
gearmotor_L
gearmotor_R
shaft_L
coupling_L
tire_L
rim_L
shaft_R
coupling_R
tire_R
rim_R
caster_cup_front
caster_ring_front
caster_ball_front
caster_bolt_front
caster_cup_rear
caster_ring_rear
caster_ball_rear
caster_bolt_rear
battery_3S_5000mAh
BTS7960_L_pcb
BTS7960_L_heatsink
BTS7960_R_pcb
BTS7960_R_heatsink
esp32_breakout_pcb
esp32_terminals
esp32_devkit
esp32_module
esp32_usb
io_board_pcb
buck_12V_5V
buck_inductor
servo_buck_12V_7V4_pcb
servo_buck_heatsink
power_bus_wagos
inline_fuse_holder
buzzer_module
line_sensor_bar
ir_module_1_pcb
ir_module_1_leda
ir_module_1_ledb
ir_module_1_pot
ir_module_1_plug
ir_module_2_pcb
ir_module_2_leda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
