ahmedoab/cargo_robot/backup_v2/cad/autocad/CargoRobot_v2.dxf

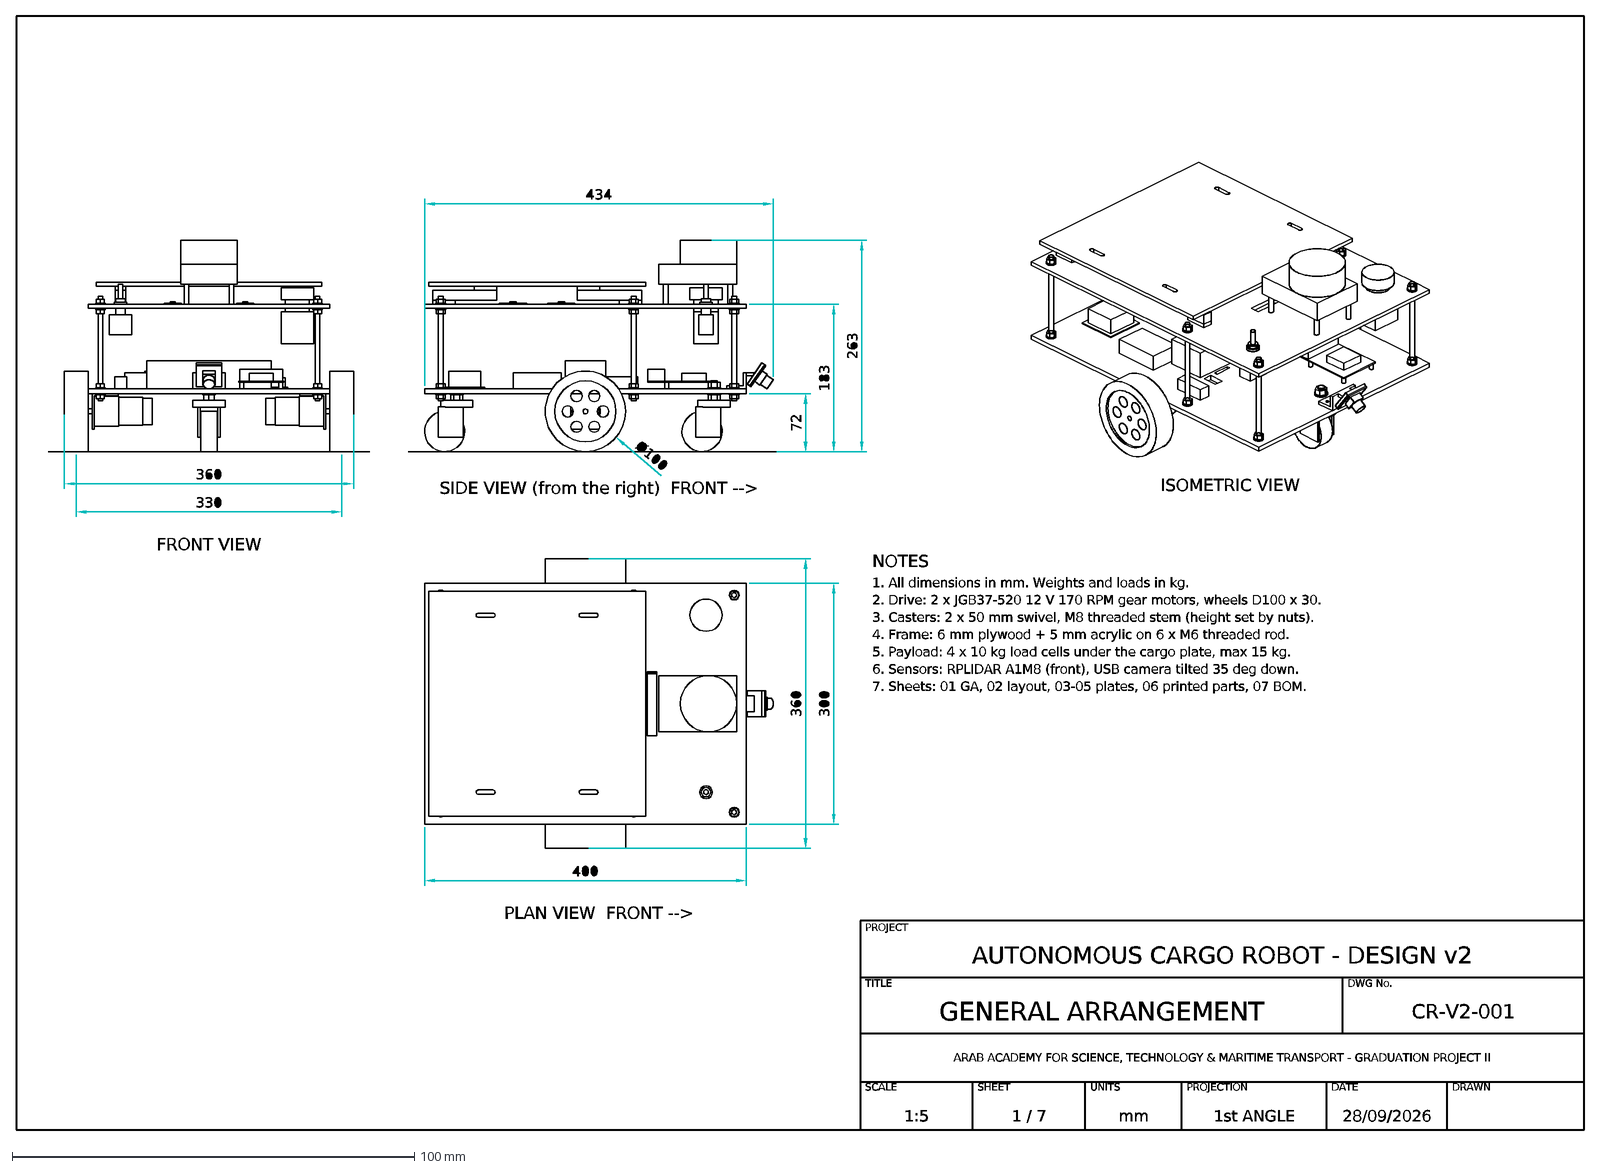
[picture p45: CAD file, 2026-09-29]
backup_v2/cad/autocad/CargoRobot_v2.dxf
SCALE
1:5
SHEET
1 / 7
UNITS
mm
PROJECTION
1st ANGLE
DATE
28/09/2026
DRAWN
PROJECT
AUTONOMOUS CARGO ROBOT - DESIGN v2
TITLE
GENERAL ARRANGEMENT
DWG No.
CR-V2-001
ARAB ACADEMY FOR SCIENCE, TECHNOLOGY & MARITIME TRANSPORT - GRADUATION PROJECT II
SIDE VIEW (from the right) FRONT -->
FRONT VIEW
PLAN VIEW FRONT -->
ISOMETRIC VIEW
NOTES
1. All dimensions in mm. Weights and loads in kg.
2. Drive: 2 x JGB37-520 12 V 170 RPM gear motors, wheels D100 x 30.
3. Casters: 2 x 50 mm swivel, M8 threaded stem (height set by nuts).
4. Frame: 6 mm plywood + 5 mm acrylic on 6 x M6 threaded rod.
5. Payload: 4 x 10 kg load cells under the cargo plate, max 15 kg.
6. Sensors: RPLIDAR A1M8 (front), USB camera tilted 35 deg down.
7. Sheets: 01 GA, 02 layout, 03-05 plates, 06 printed parts, 07 BOM.
