ahmedoab/cargo_robot/backup_v2/cad/output/parts/camera_mount.step

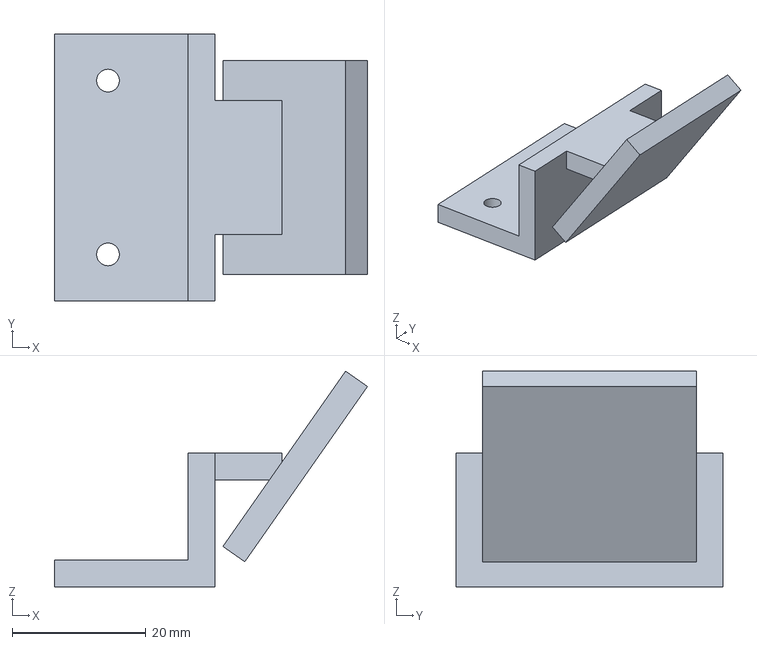
[picture p46: CAD file, 2026-09-29]
backup_v2/cad/output/parts/camera_mount.step
46.8 x 40.0 x 32.3 mm
