ahmedoab/cargo_robot/backup_v2/robot_ws/src/cargo_bot/meshes/cargo_bot_body.stl

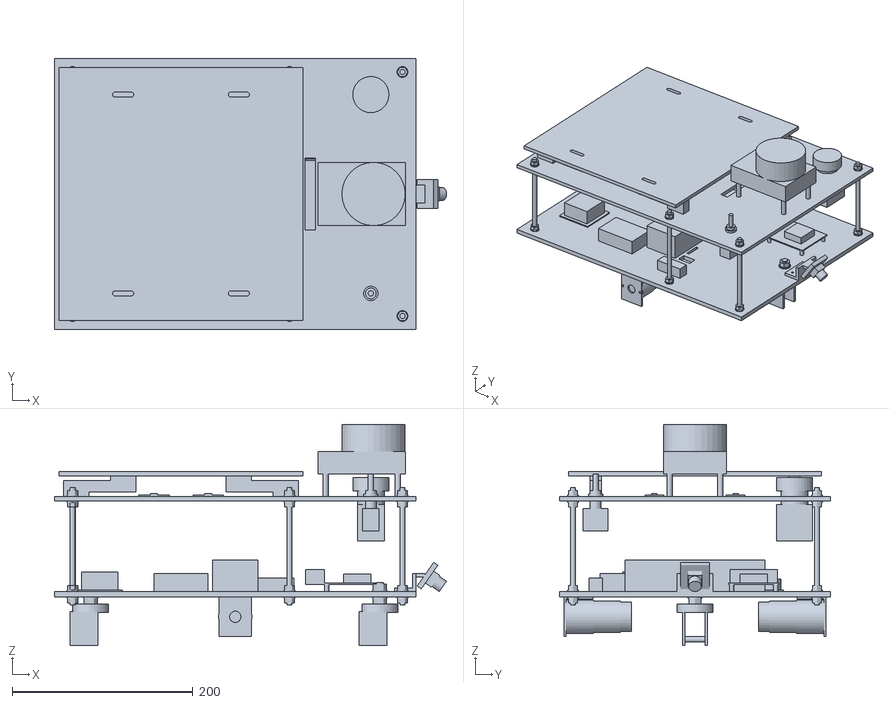
[picture p47: CAD file, 2026-09-29]
backup_v2/robot_ws/src/cargo_bot/meshes/cargo_bot_body.stl
433.7 x 300.0 x 245.0
