ahmedoab/cargo_robot/cad/output/parts/bed_rest.step

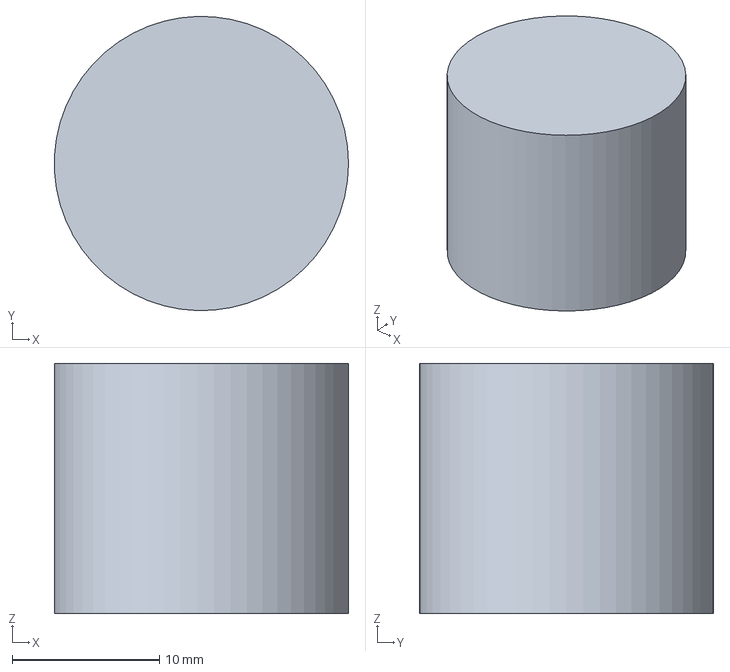
[picture p48: CAD file, 2026-11-10]
cad/output/parts/bed_rest.step
20.0 x 20.0 x 17.0 mm
