ahmedoab/cargo_robot/cad/output/parts_step/caster_pod.step

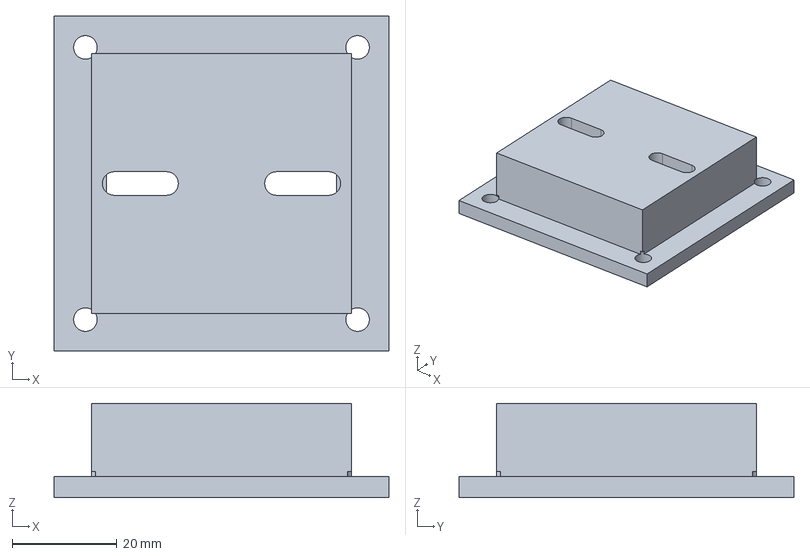
[picture p49: CAD file, 2026-10-20]
cad/output/parts_step/caster_pod.step
64.0 x 64.0 x 18.0 mm
