ahmedoab/cargo_robot/conveyor/output/conveyor.step

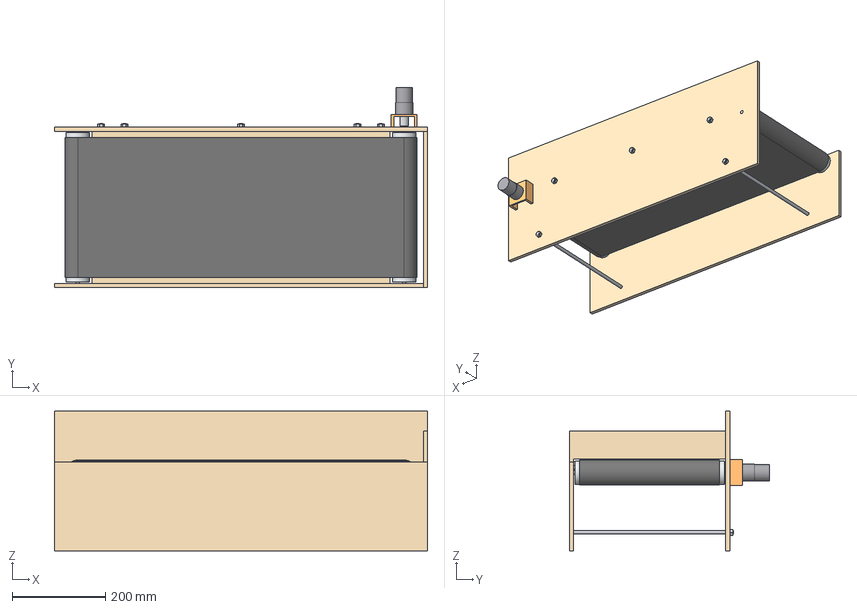
[picture p50: CAD file, 2026-10-13]
conveyor/output/conveyor.step
800.0 x 429.0 x 300.0 mm
side_plate_near
side_plate_far
belt_bed
tie_rods
motor_bracket
coupler
gear_motor
roller_idler
roller_drive
belt
end_stop
