ahmedoab/cargo_robot/conveyor/output/parts/belt.stl

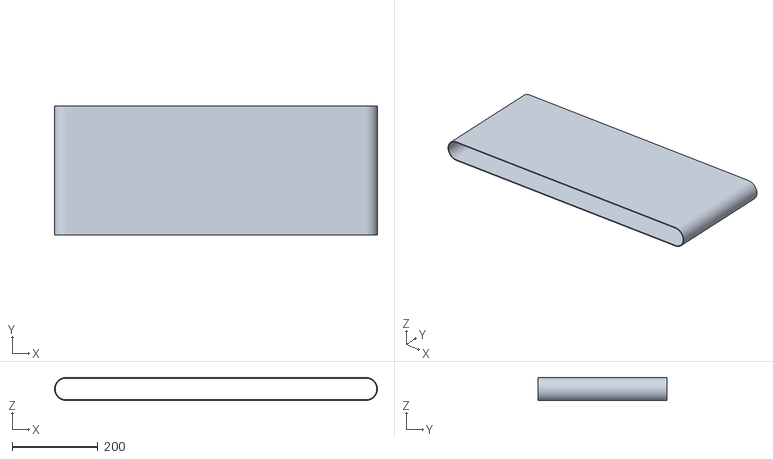
[picture p51: CAD file, 2026-10-13]
conveyor/output/parts/belt.stl
754.0 x 300.0 x 54.0
