ahmedoab/cargo_robot/print/ABS/motor_mount_left.stl

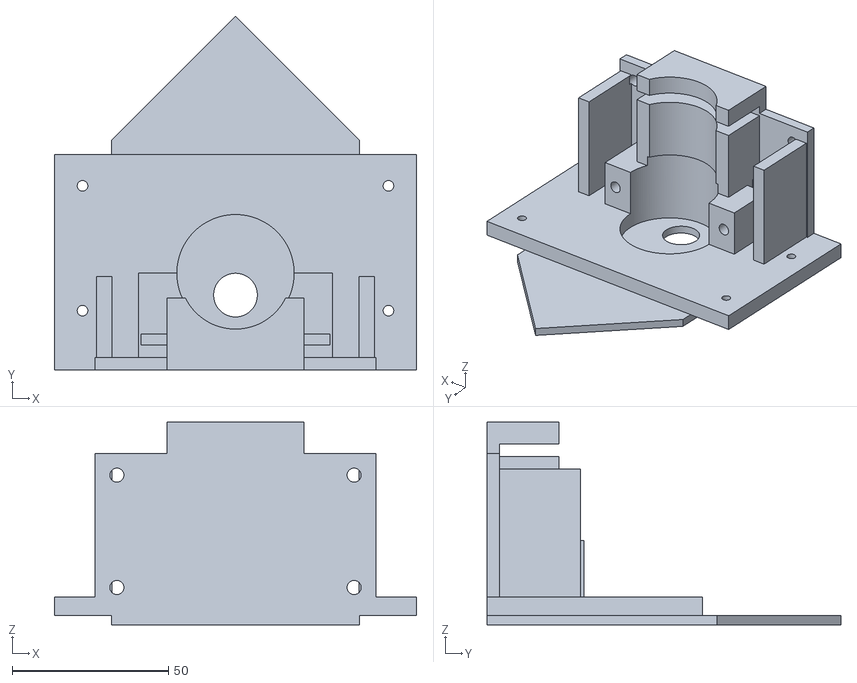
[picture p52: CAD file, 2026-10-20]
print/ABS/motor_mount_left.stl
116.0 x 113.4 x 65.0
