ahmedoab/cargo_robot/print/PETG/bed_rear_left.stl

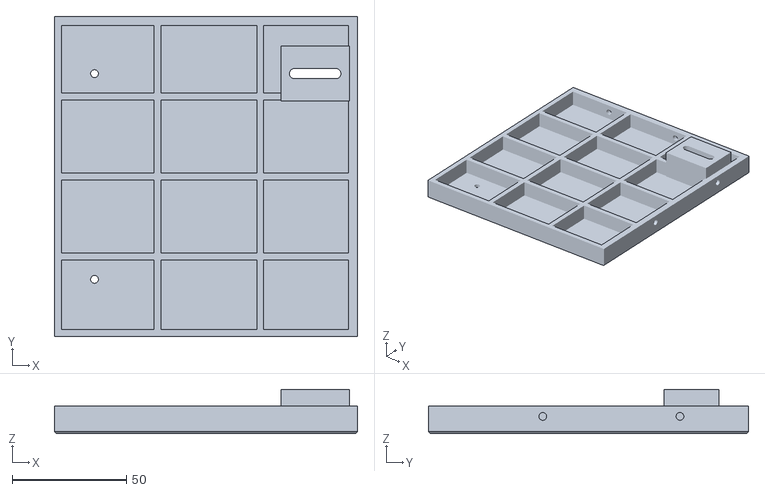
[picture p53: CAD file, 2026-10-20]
print/PETG/bed_rear_left.stl
132.5 x 140.0 x 19.3
