ahmedoab/cargo_robot/print/PLA/line_sensor_bar.stl

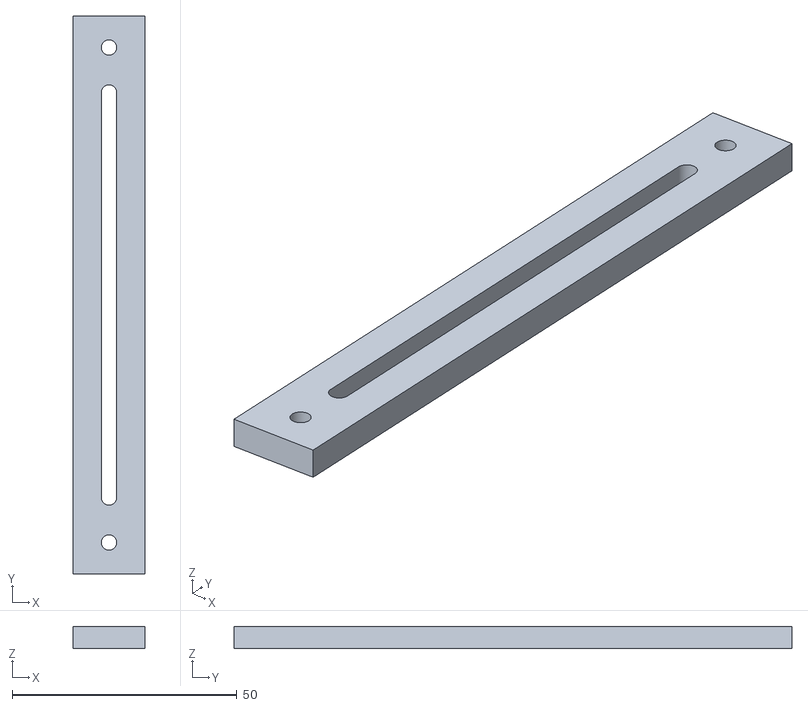
[picture p54: CAD file, 2026-10-20]
print/PLA/line_sensor_bar.stl
16.0 x 124.0 x 5.00
