ahmedoab/cargo_robot/print/TPU/cable_grommet_x2.stl

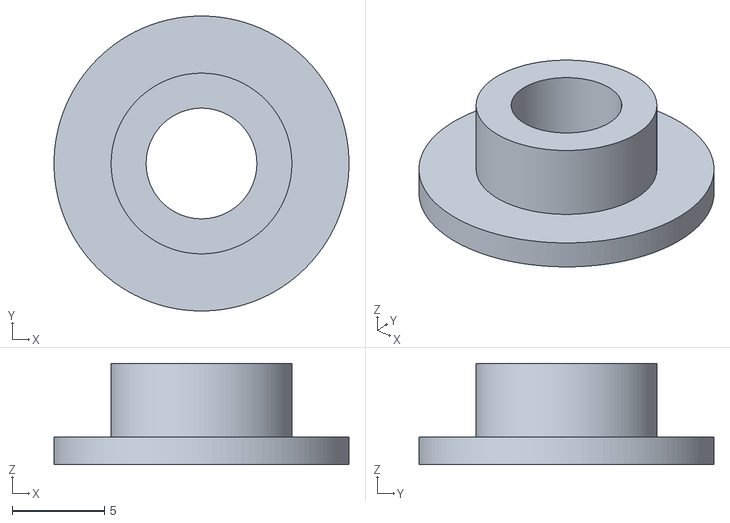
[picture p55: CAD file, 2026-10-20]
print/TPU/cable_grommet_x2.stl
16.0 x 16.0 x 5.50
