ahmedoab/cargo_robot/robot_ws/src/cargo_bot/meshes/cargo_bot_body.stl

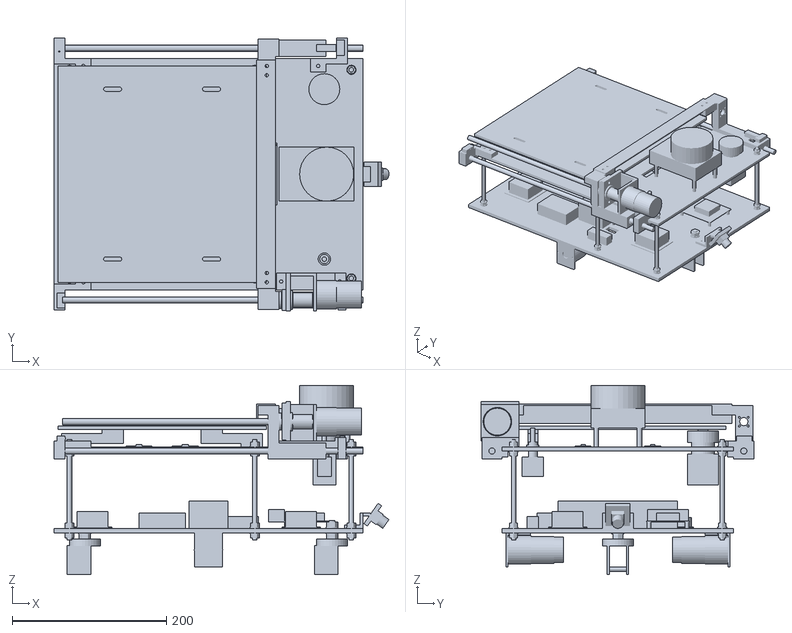
[picture p56: CAD file, 2026-10-13]
robot_ws/src/cargo_bot/meshes/cargo_bot_body.stl
433.7 x 353.0 x 245.0
