ahmedoab/cargo_robot/backup_v2/cad/autocad/CargoRobot_v2_schematics.dxf

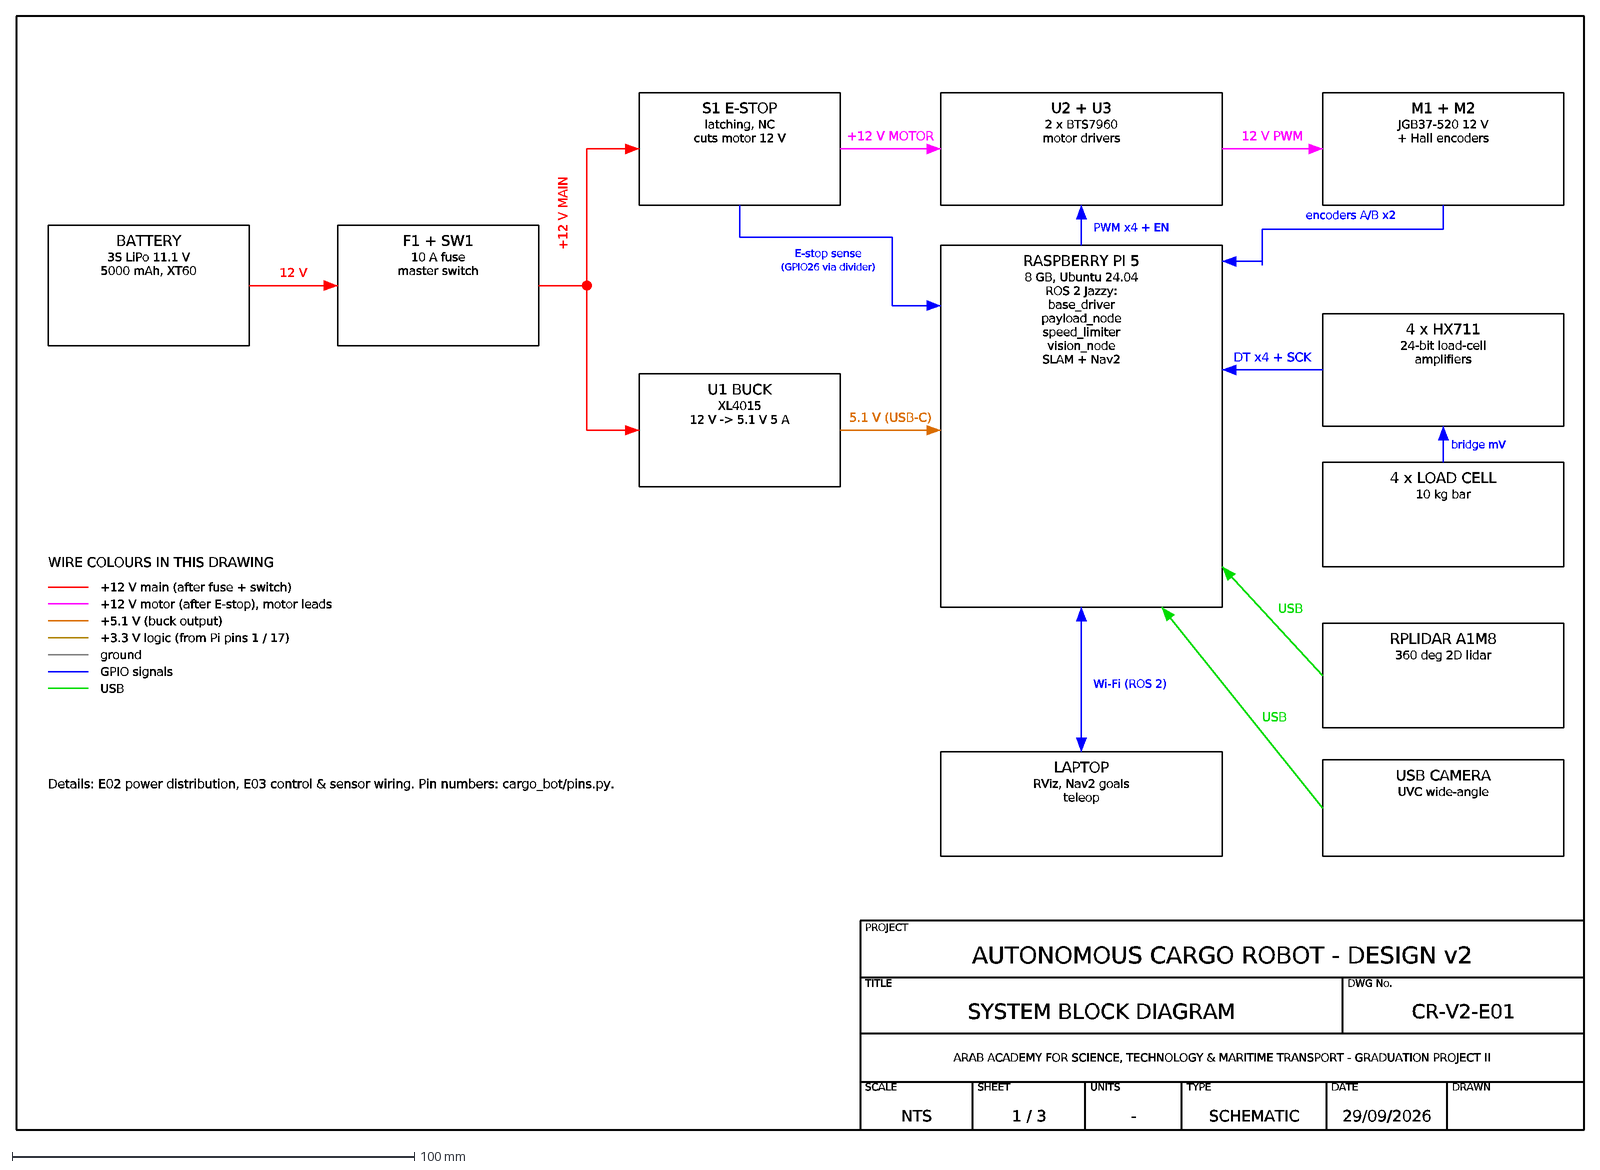
[picture p57: CAD file, 2026-09-29]
backup_v2/cad/autocad/CargoRobot_v2_schematics.dxf
SCALE
NTS
SHEET
1 / 3
UNITS
-
TYPE
SCHEMATIC
DATE
29/09/2026
DRAWN
PROJECT
AUTONOMOUS CARGO ROBOT - DESIGN v2
TITLE
SYSTEM BLOCK DIAGRAM
DWG No.
CR-V2-E01
ARAB ACADEMY FOR SCIENCE, TECHNOLOGY & MARITIME TRANSPORT - GRADUATION PROJECT II
BATTERY
3S LiPo 11.1 V
5000 mAh, XT60
F1 + SW1
10 A fuse
master switch
S1 E-STOP
latching, NC
cuts motor 12 V
U1 BUCK
XL4015
12 V -> 5.1 V 5 A
RASPBERRY PI 5
8 GB, Ubuntu 24.04
ROS 2 Jazzy:
base_driver
payload_node
speed_limiter
vision_node
SLAM + Nav2
U2 + U3
2 x BTS7960
motor drivers
M1 + M2
JGB37-520 12 V
+ Hall encoders
4 x HX711
24-bit load-cell
amplifiers
4 x LOAD CELL
10 kg bar
RPLIDAR A1M8
360 deg 2D lidar
USB CAMERA
UVC wide-angle
LAPTOP
RViz, Nav2 goals
teleop
12 V
+12 V MAIN
+12 V MOTOR
5.1 V (USB-C)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
