ahmedoab/cargo_robot/backup_v2/cad/output/parts/load_cell_spacer.step

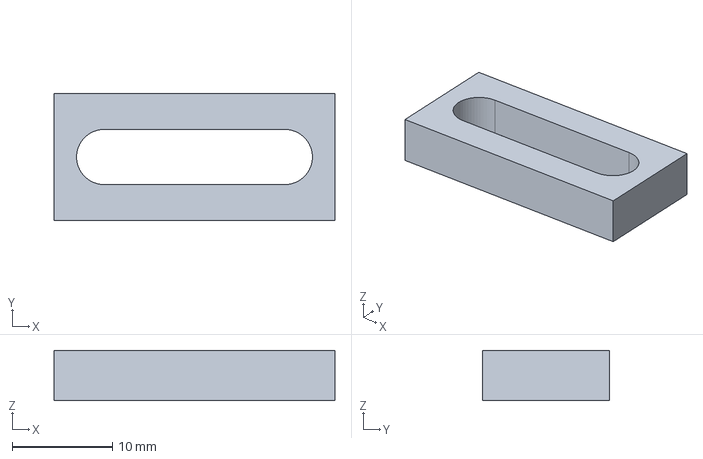
[picture p58: CAD file, 2026-09-29]
backup_v2/cad/output/parts/load_cell_spacer.step
28.0 x 12.7 x 5.00 mm
