ahmedoab/cargo_robot/cad/output/parts/servo_mount_front.step

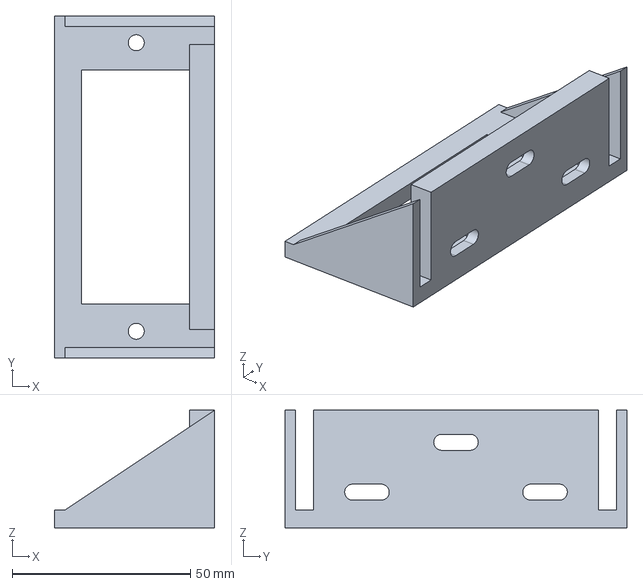
[picture p59: CAD file, 2026-11-10]
cad/output/parts/servo_mount_front.step
45.0 x 96.0 x 33.0 mm
