ahmedoab/cargo_robot/cad/output/parts_step/bed_front_right.step

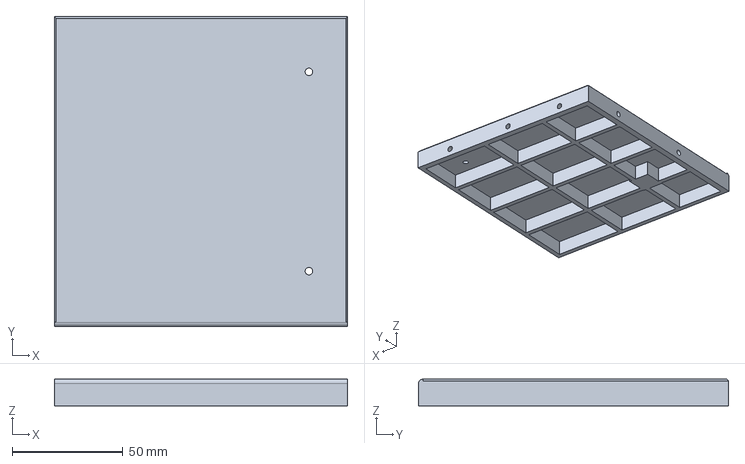
[picture p60: CAD file, 2026-10-20]
cad/output/parts_step/bed_front_right.step
132.5 x 140.0 x 12.0 mm
