ahmedoab/cargo_robot/conveyor/output/parts/end_stop.stl

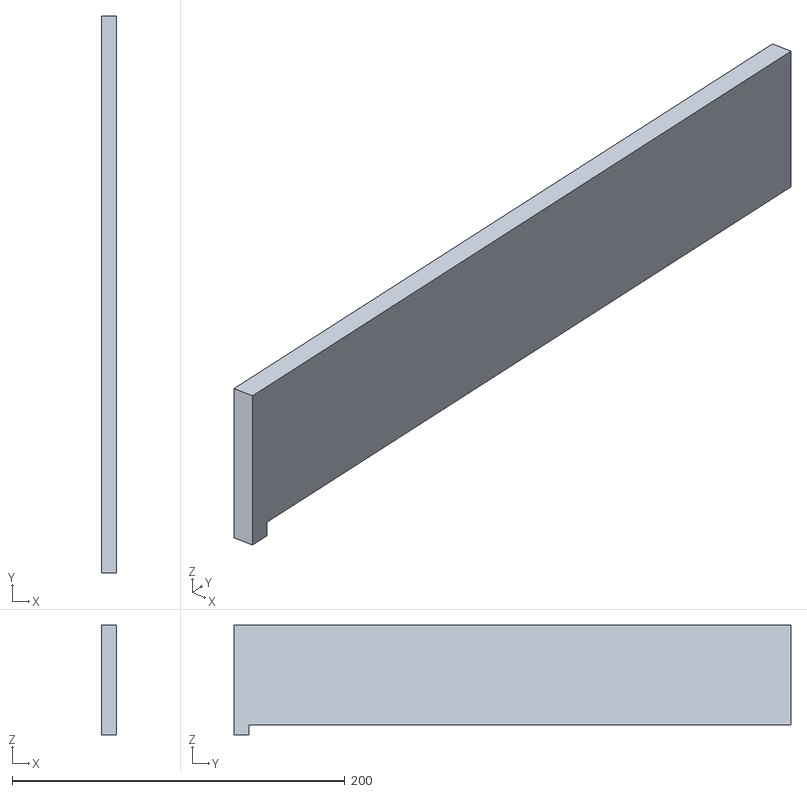
[picture p61: CAD file, 2026-10-13]
conveyor/output/parts/end_stop.stl
9.00 x 335.0 x 66.0
