ahmedoab/cargo_robot/print/ABS/pusher_motor_holder.stl

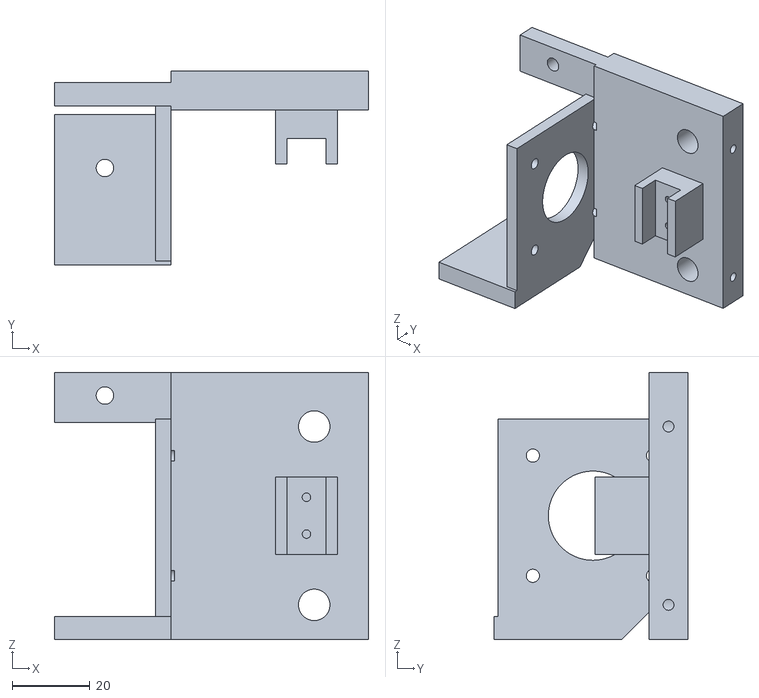
[picture p62: CAD file, 2026-10-20]
print/ABS/pusher_motor_holder.stl
81.0 x 50.0 x 69.0
