ahmedoab/cargo_robot/print/PETG/pusher_idler_holder.stl

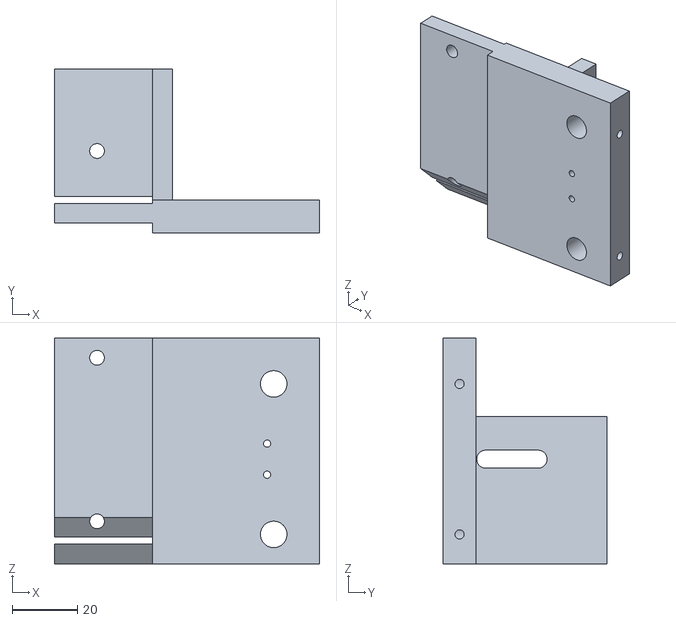
[picture p63: CAD file, 2026-10-20]
print/PETG/pusher_idler_holder.stl
81.0 x 50.0 x 69.0
