ahmedoab/cargo_robot/print/PLA/rear_panel_left.stl

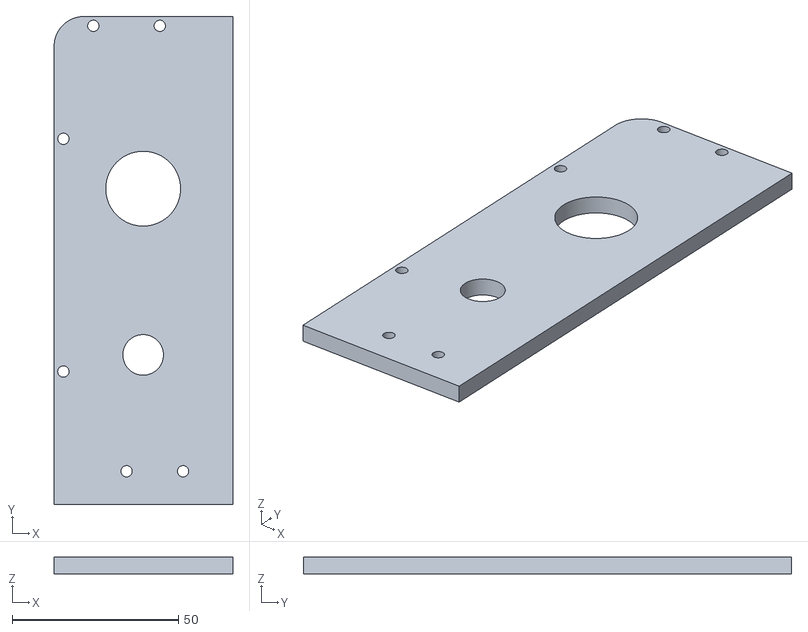
[picture p64: CAD file, 2026-10-20]
print/PLA/rear_panel_left.stl
53.8 x 146.8 x 5.00
