ahmedoab/cargo_robot/print/TPU/front_bumper.stl

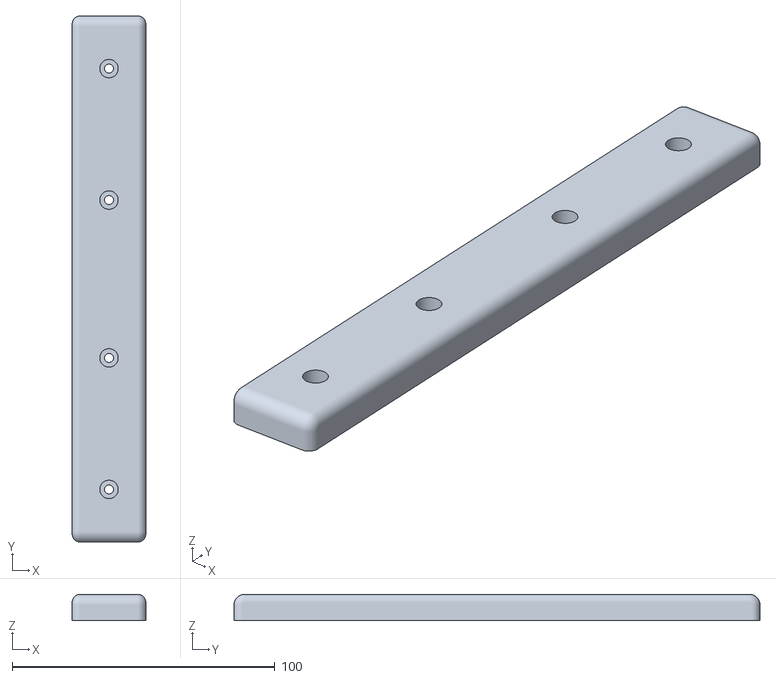
[picture p65: CAD file, 2026-10-20]
print/TPU/front_bumper.stl
28.0 x 200.0 x 10.0
