ahmedoab/cargo_robot/backup_v2/cad/output/parts/top_deck.step

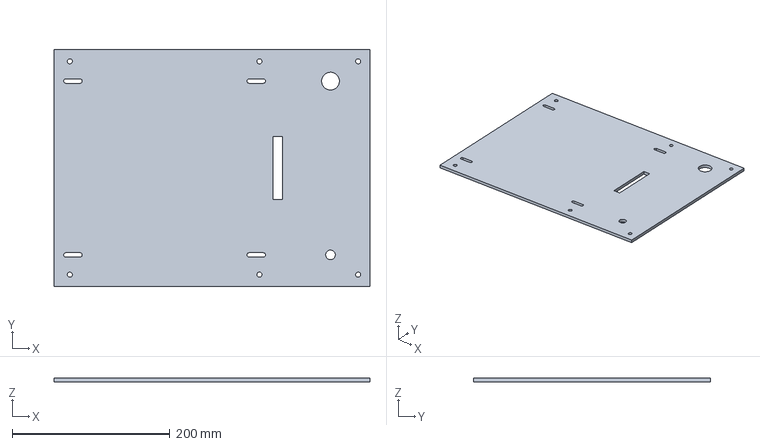
[picture p66: CAD file, 2026-09-29]
backup_v2/cad/output/parts/top_deck.step
400.0 x 300.0 x 5.00 mm
