ahmedoab/cargo_robot/cad/output/parts/bed_riser.step

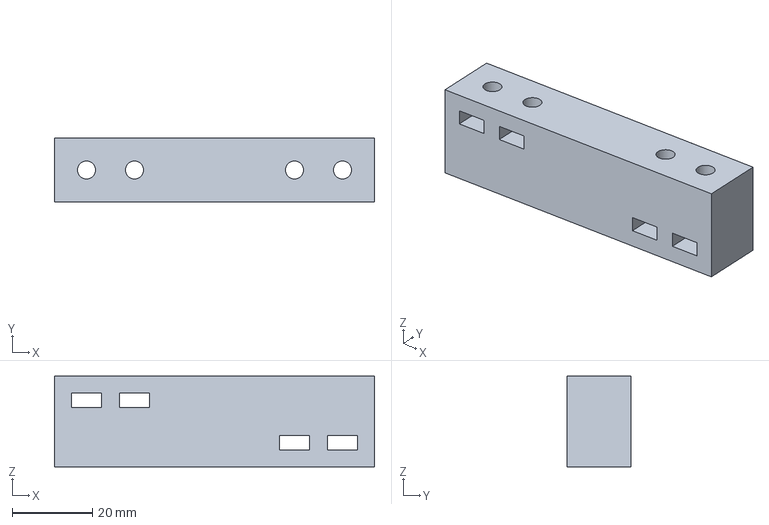
[picture p68: CAD file, 2026-11-10]
cad/output/parts/bed_riser.step
80.0 x 16.0 x 22.7 mm
