ahmedoab/cargo_robot/cad/output/parts_step/tub_rear_left.step

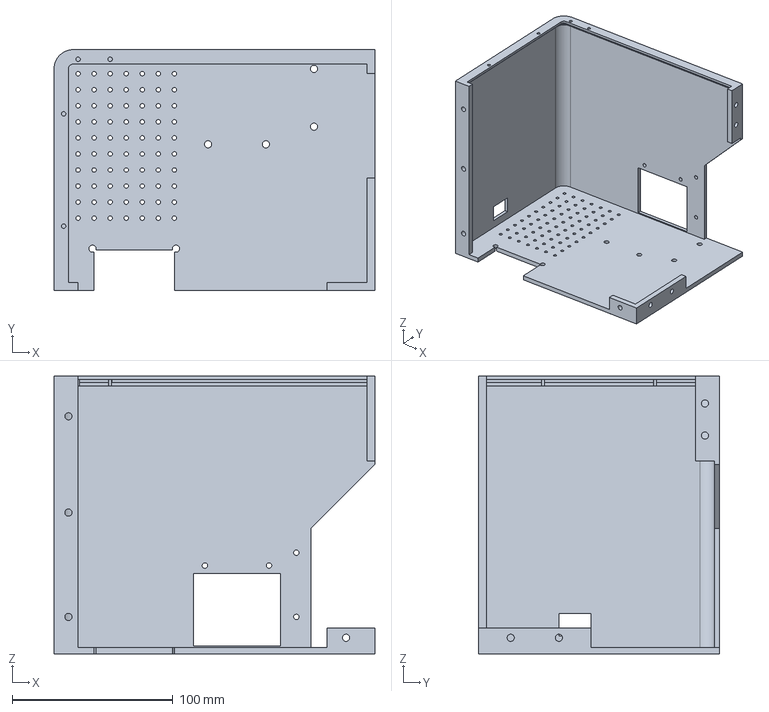
[picture p69: CAD file, 2026-10-20]
cad/output/parts_step/tub_rear_left.step
200.0 x 150.0 x 173.0 mm
