ahmedoab/cargo_robot/conveyor/output/parts/roller_idler.stl

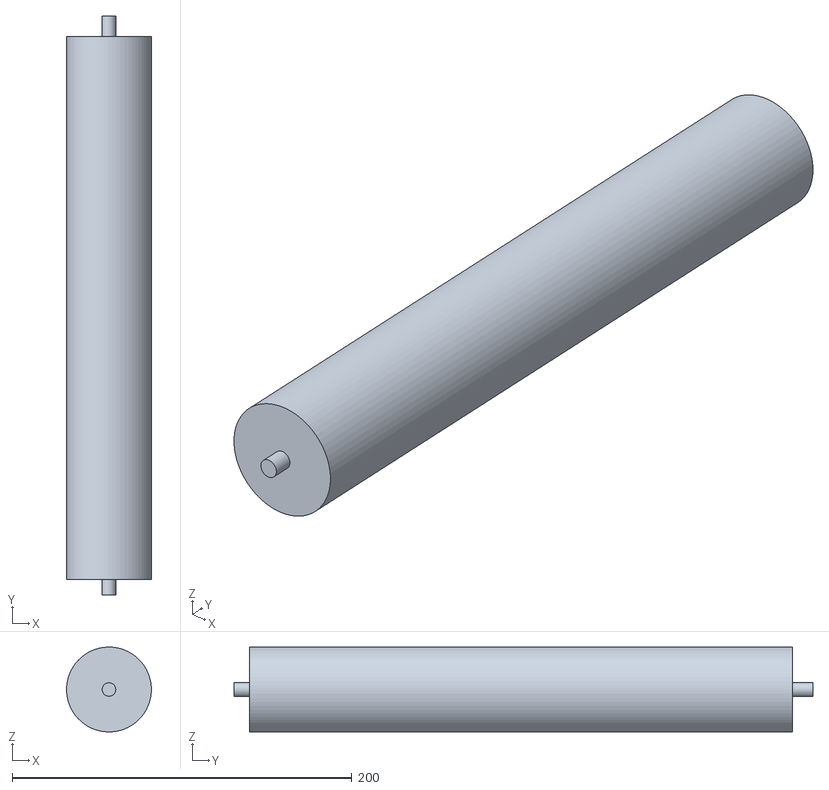
[picture p70: CAD file, 2026-10-13]
conveyor/output/parts/roller_idler.stl
50.0 x 341.0 x 50.0
