ahmedoab/cargo_robot/print/PETG/guide_rail_x4.stl

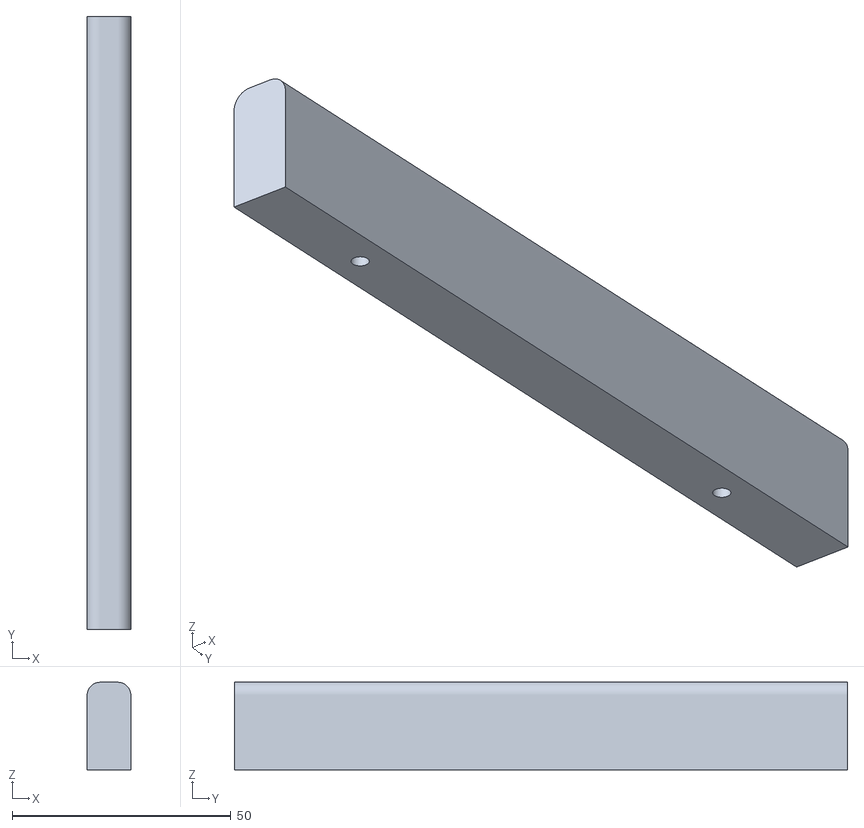
[picture p71: CAD file, 2026-10-20]
print/PETG/guide_rail_x4.stl
10.0 x 140.0 x 20.0
