ahmedoab/cargo_robot/print/PLA/ultrasonic_clip_x3.stl

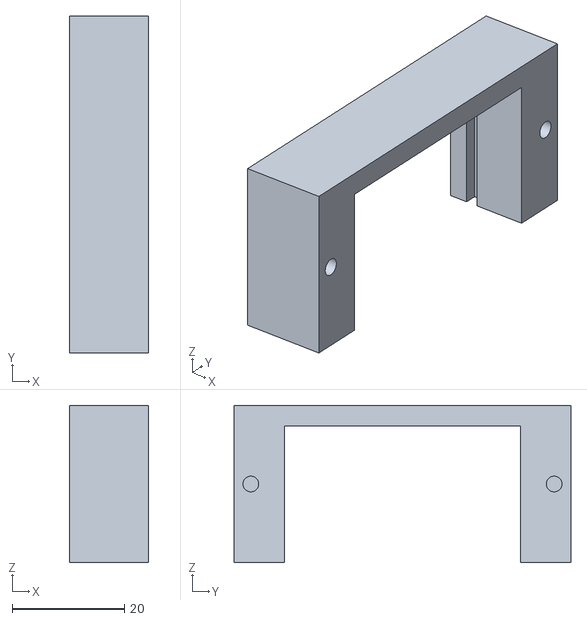
[picture p72: CAD file, 2026-10-20]
print/PLA/ultrasonic_clip_x3.stl
14.0 x 60.0 x 28.0
