ahmedoab/cargo_robot/print/TPU/battery_pad_x2.stl

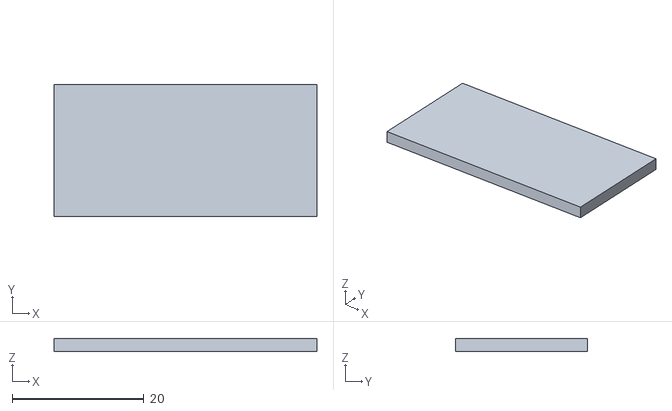
[picture p73: CAD file, 2026-10-20]
print/TPU/battery_pad_x2.stl
40.0 x 20.0 x 2.00
