ahmedoab/cargo_robot/cad/autocad/CargoRobot_v3.dxf

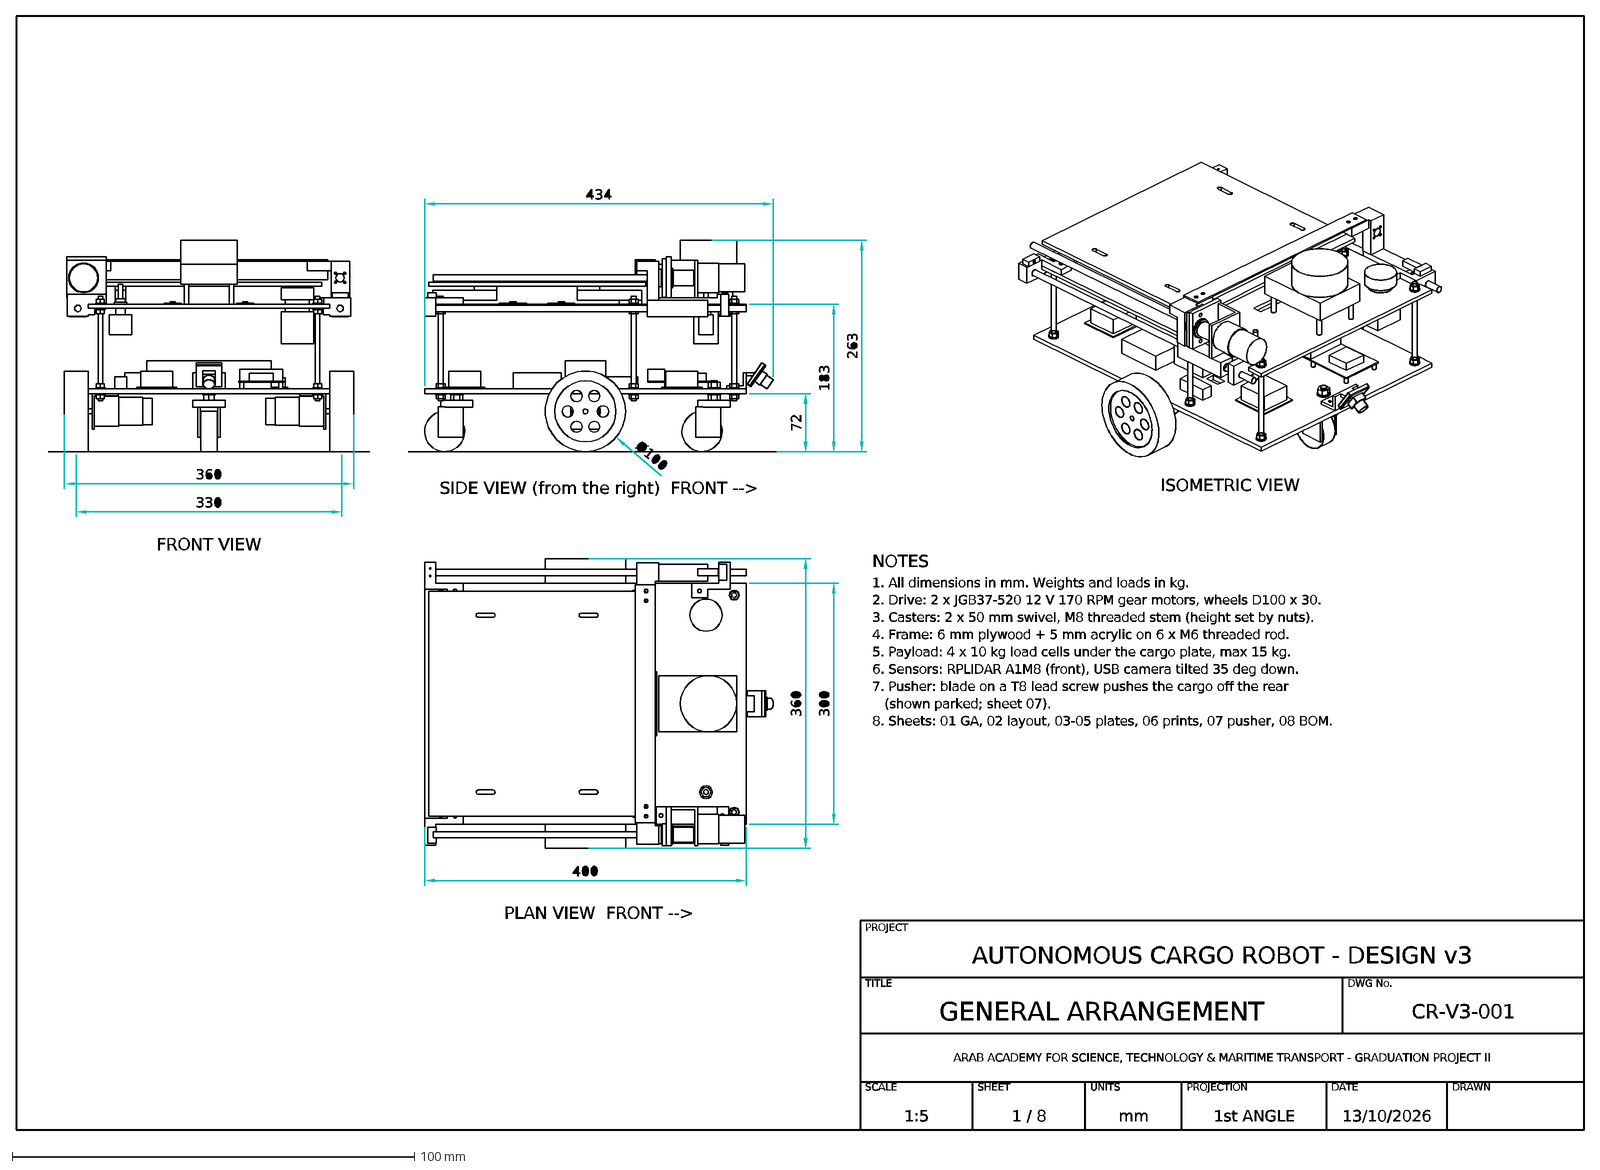
[picture p74: CAD file, 2026-10-13]
cad/autocad/CargoRobot_v3.dxf
SCALE
1:5
SHEET
1 / 8
UNITS
mm
PROJECTION
1st ANGLE
DATE
13/10/2026
DRAWN
PROJECT
AUTONOMOUS CARGO ROBOT - DESIGN v3
TITLE
GENERAL ARRANGEMENT
DWG No.
CR-V3-001
ARAB ACADEMY FOR SCIENCE, TECHNOLOGY & MARITIME TRANSPORT - GRADUATION PROJECT II
SIDE VIEW (from the right) FRONT -->
FRONT VIEW
PLAN VIEW FRONT -->
ISOMETRIC VIEW
NOTES
1. All dimensions in mm. Weights and loads in kg.
2. Drive: 2 x JGB37-520 12 V 170 RPM gear motors, wheels D100 x 30.
3. Casters: 2 x 50 mm swivel, M8 threaded stem (height set by nuts).
4. Frame: 6 mm plywood + 5 mm acrylic on 6 x M6 threaded rod.
5. Payload: 4 x 10 kg load cells under the cargo plate, max 15 kg.
6. Sensors: RPLIDAR A1M8 (front), USB camera tilted 35 deg down.
7. Pusher: blade on a T8 lead screw pushes the cargo off the rear
(shown parked; sheet 07).
8. Sheets: 01 GA, 02 layout, 03-05 plates, 06 prints, 07 pusher, 08 BOM.
