ahmedoab/cargo_robot/conveyor/output/parts/frame.stl

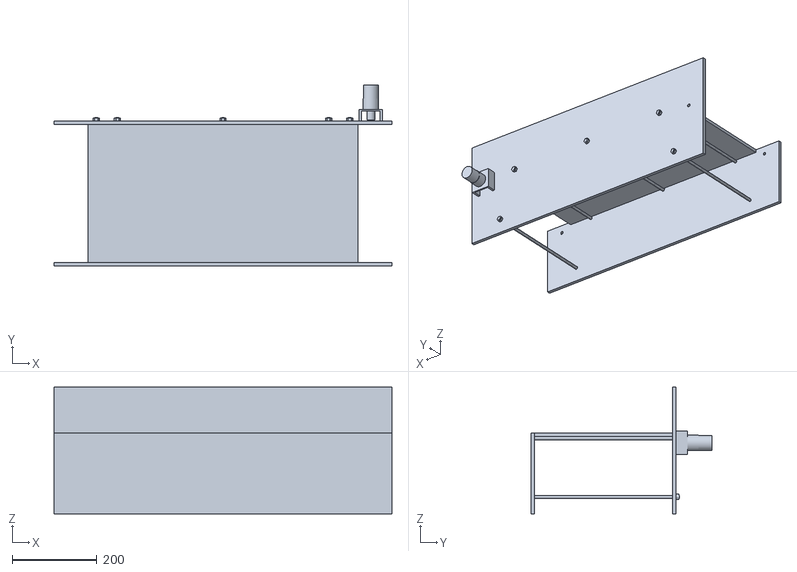
[picture p75: CAD file, 2026-10-13]
conveyor/output/parts/frame.stl
800.0 x 429.0 x 300.0
