ahmedoab/cargo_robot/print/ABS/motor_clamp_cap_x2.stl

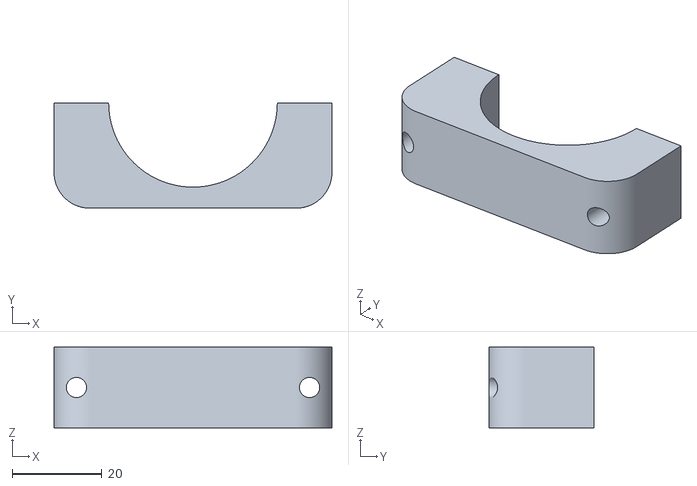
[picture p76: CAD file, 2026-10-20]
print/ABS/motor_clamp_cap_x2.stl
62.0 x 23.5 x 18.0
