ahmedoab/cargo_robot/print/PLA/rear_panel_right.stl

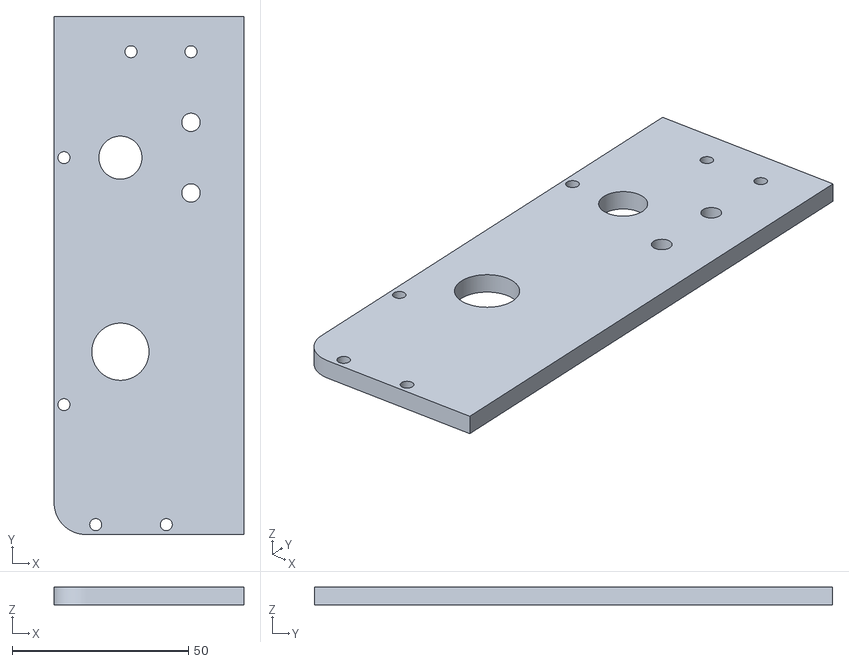
[picture p77: CAD file, 2026-10-20]
print/PLA/rear_panel_right.stl
53.8 x 146.8 x 5.00
