ahmedoab/cargo_robot/cad/output/parts/servo_clamp.step

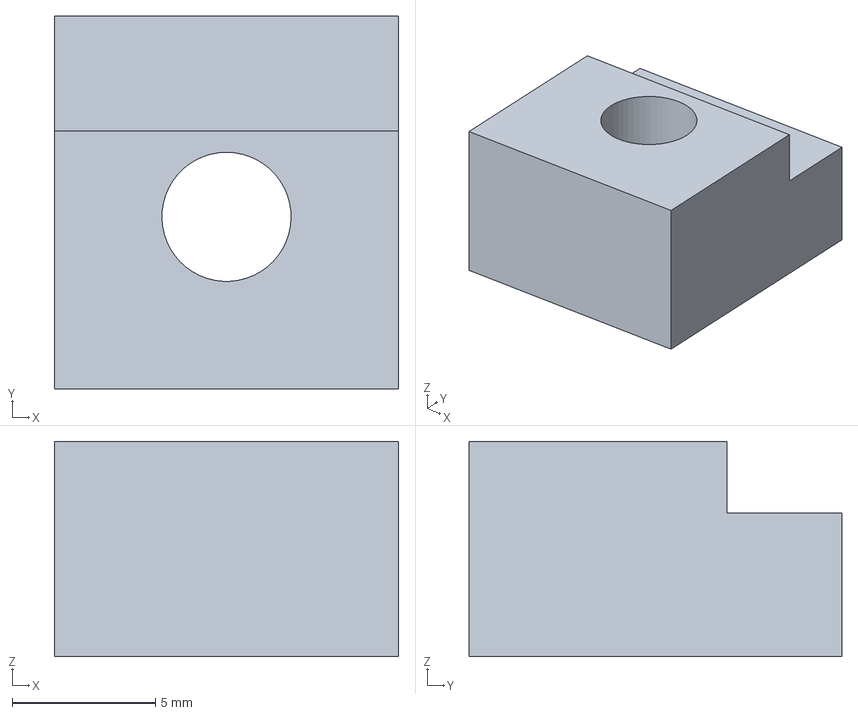
[picture p78: CAD file, 2026-11-10]
cad/output/parts/servo_clamp.step
12.0 x 13.0 x 7.50 mm
