ahmedoab/cargo_robot/conveyor/output/parts/roller_drive.stl

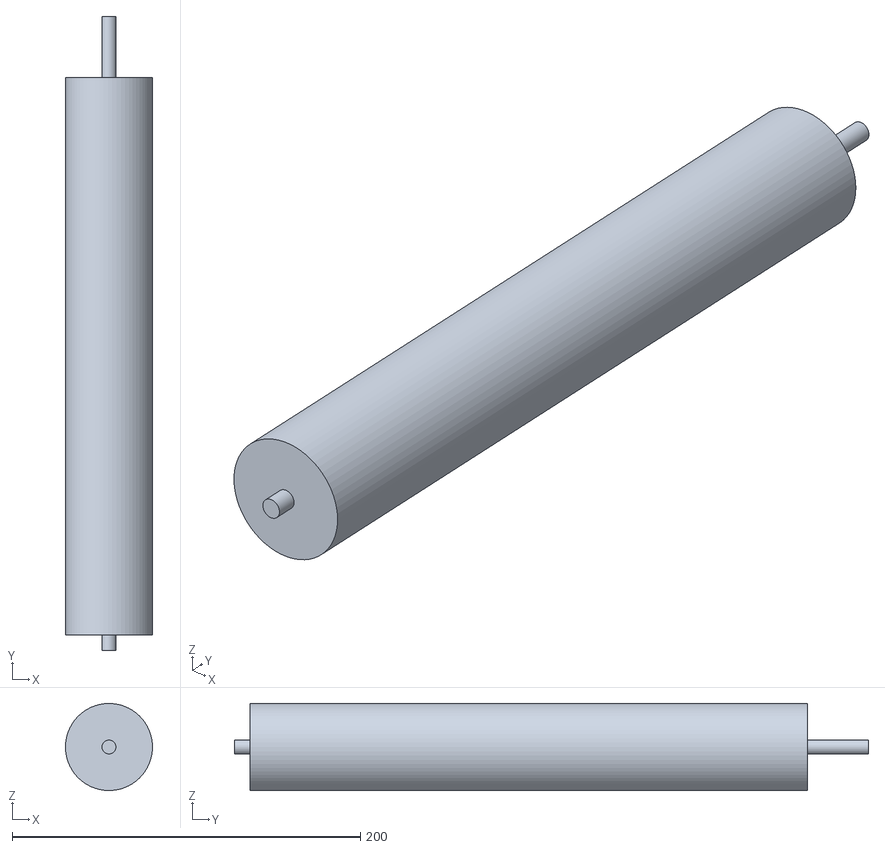
[picture p79: CAD file, 2026-10-13]
conveyor/output/parts/roller_drive.stl
50.0 x 364.0 x 50.0
