ahmedoab/cargo_robot/print/PETG/pusher_carriage.stl

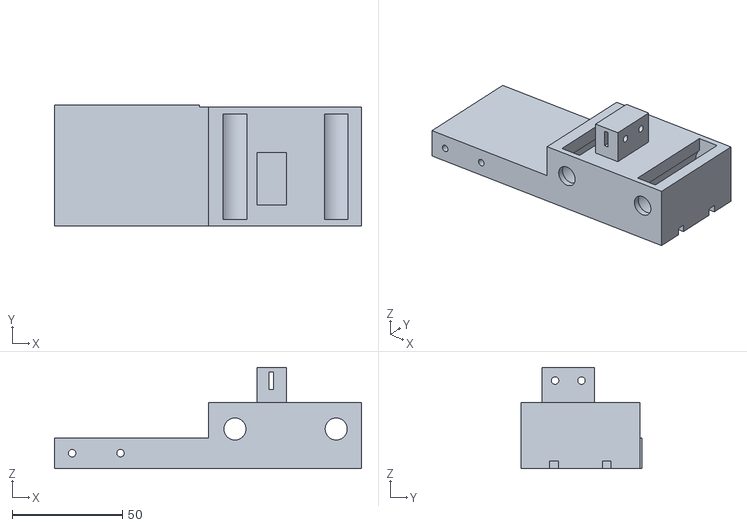
[picture p80: CAD file, 2026-10-20]
print/PETG/pusher_carriage.stl
139.5 x 55.0 x 46.0
