ahmedoab/cargo_robot/print/PLA/battery_door.stl

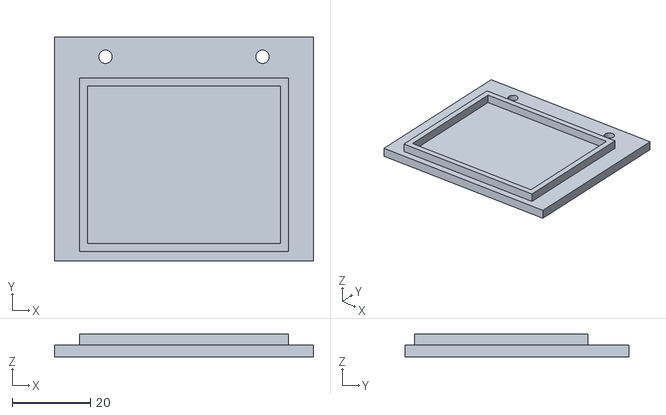
[picture p81: CAD file, 2026-10-20]
print/PLA/battery_door.stl
66.0 x 57.0 x 5.80
