ahmedoab/cargo_robot/cad/output/parts/line_sensor_bar.step

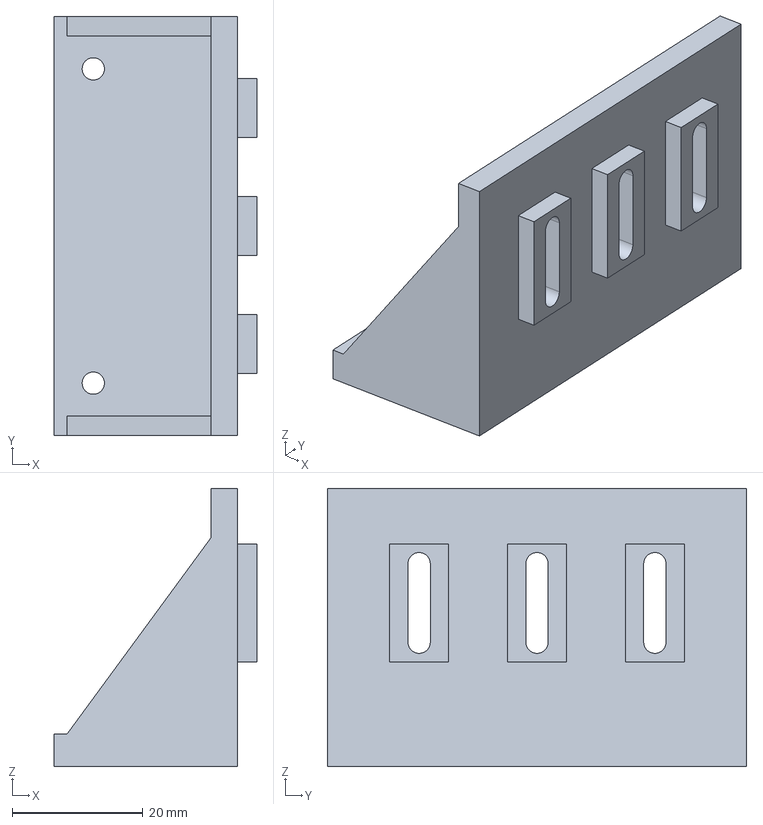
[picture p82: CAD file, 2026-11-10]
cad/output/parts/line_sensor_bar.step
31.0 x 64.0 x 42.5 mm
