ahmedoab/cargo_robot/cad/output/parts_step/bridge_left.step

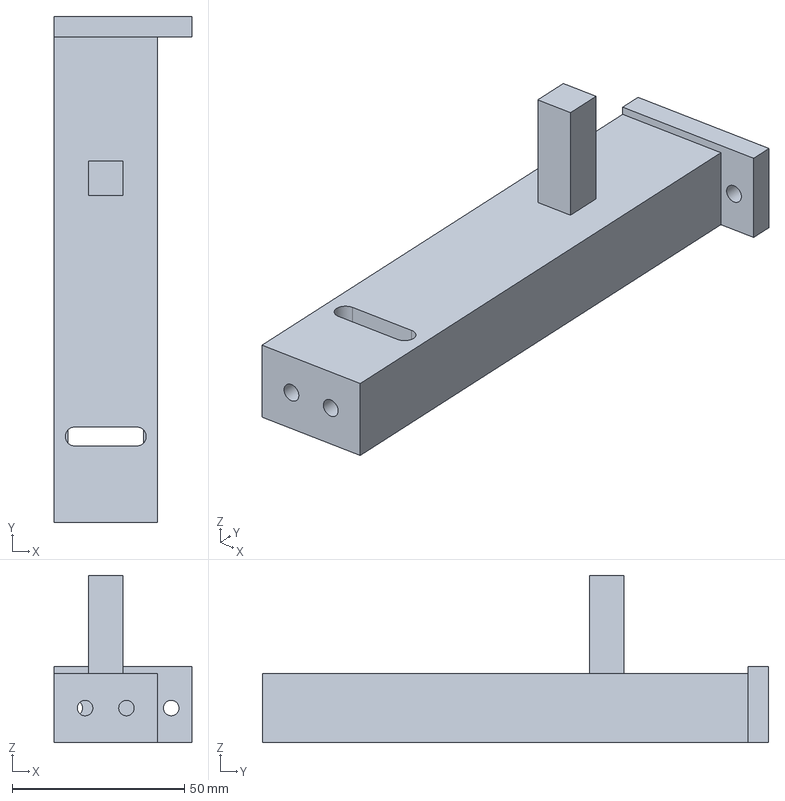
[picture p83: CAD file, 2026-10-20]
cad/output/parts_step/bridge_left.step
40.0 x 147.0 x 48.5 mm
