ahmedoab/cargo_robot/print/PLA/tof_bracket.stl

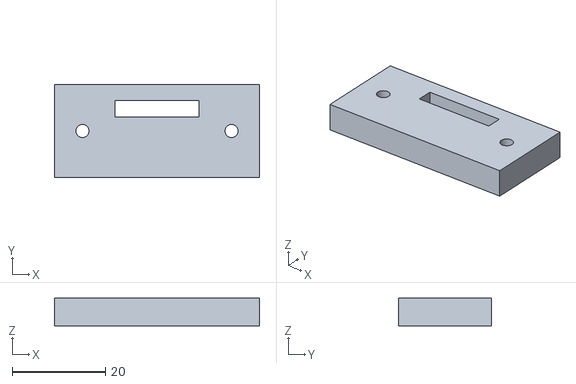
[picture p84: CAD file, 2026-10-20]
print/PLA/tof_bracket.stl
44.0 x 20.0 x 6.00
