ahmedoab/cargo_robot/cad/output/parts/horn_adapter_rear.step

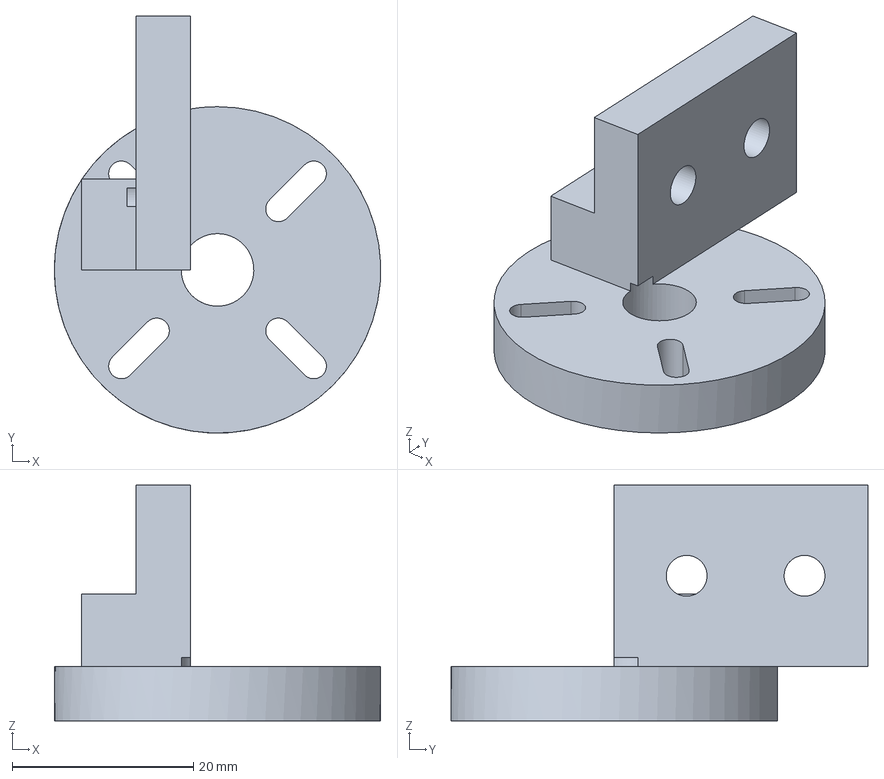
[picture p85: CAD file, 2026-11-10]
cad/output/parts/horn_adapter_rear.step
36.0 x 46.0 x 26.0 mm
