ahmedoab/cargo_robot/print/PETG/pusher_blade.stl

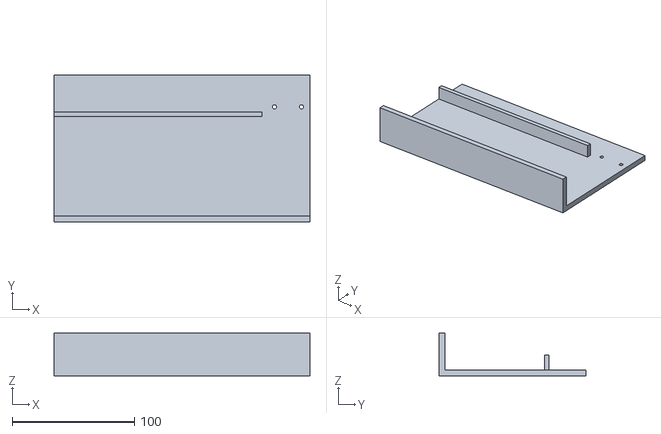
[picture p86: CAD file, 2026-10-20]
print/PETG/pusher_blade.stl
209.0 x 120.0 x 35.0
