ahmedoab/cargo_robot/print/PLA/front_cover.stl

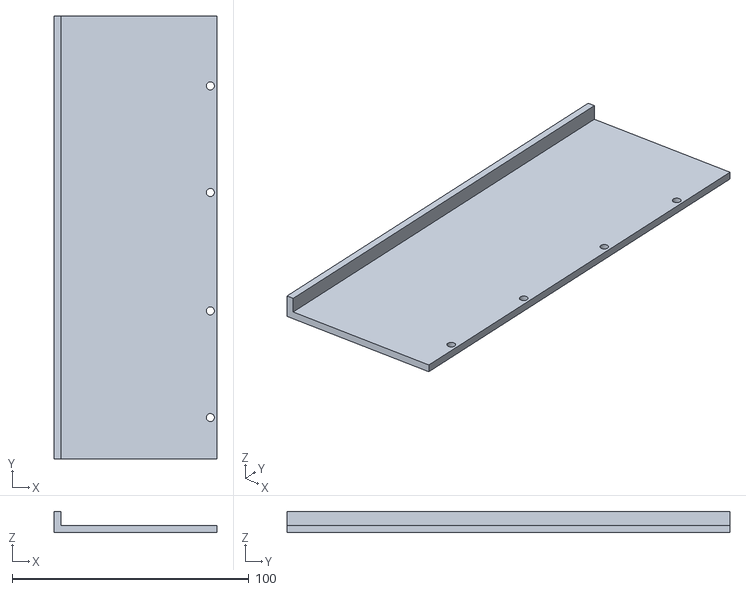
[picture p87: CAD file, 2026-10-20]
print/PLA/front_cover.stl
68.8 x 187.0 x 9.00
