ahmedoab/cargo_robot/cad/output/parts/sonar_bracket.step

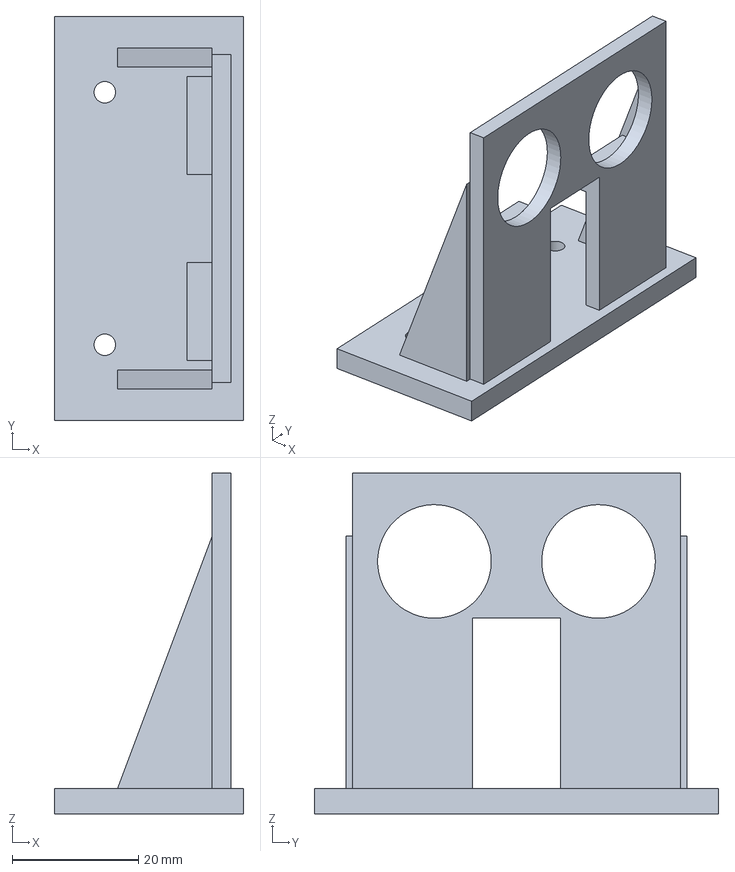
[picture p88: CAD file, 2026-11-10]
cad/output/parts/sonar_bracket.step
30.0 x 64.0 x 54.0 mm
