ahmedoab/cargo_robot/print/PLA/rear_panel_joiner.stl

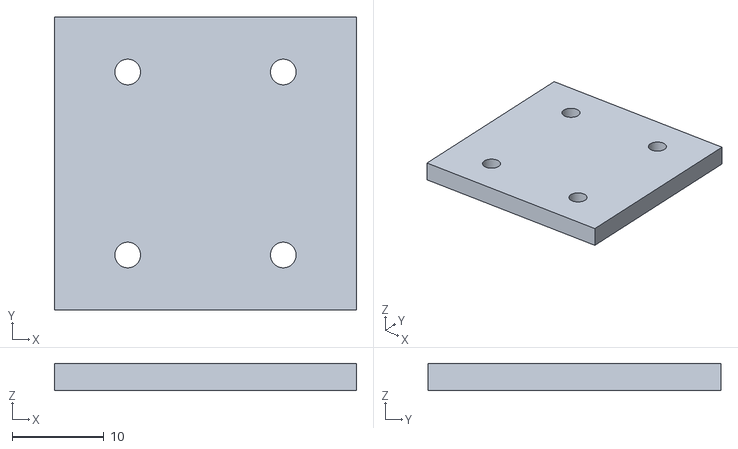
[picture p89: CAD file, 2026-10-20]
print/PLA/rear_panel_joiner.stl
33.0 x 32.0 x 3.00
