ahmedoab/cargo_robot/cad/output/parts/caster_ring.step

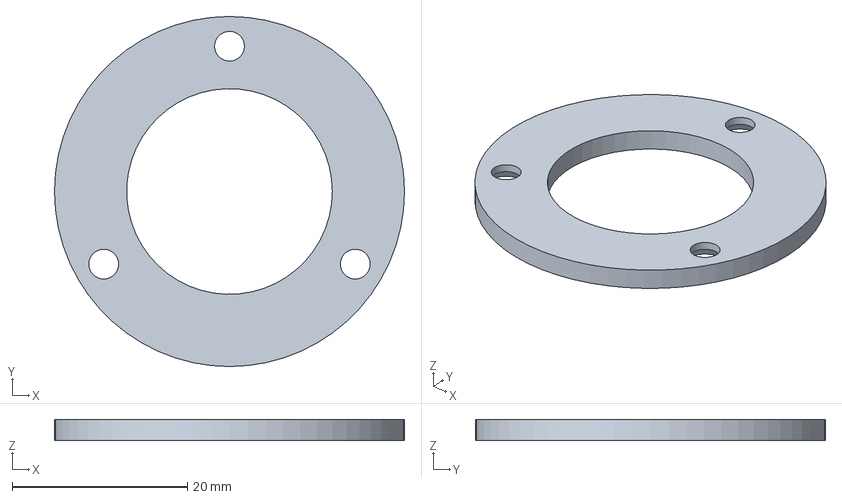
[picture p90: CAD file, 2026-11-10]
cad/output/parts/caster_ring.step
40.0 x 40.0 x 2.40 mm
