ahmedoab/cargo_robot/cad/output/parts_step/battery_tray.step

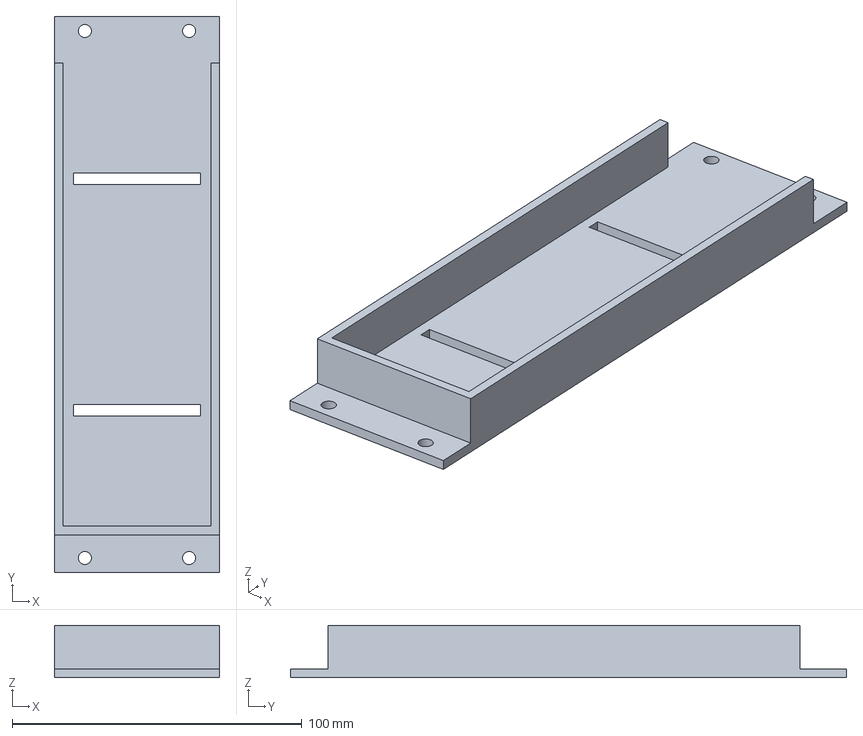
[picture p91: CAD file, 2026-10-20]
cad/output/parts_step/battery_tray.step
57.0 x 192.0 x 18.0 mm
