ahmedoab/cargo_robot/cad/output/parts/caster_cup.step

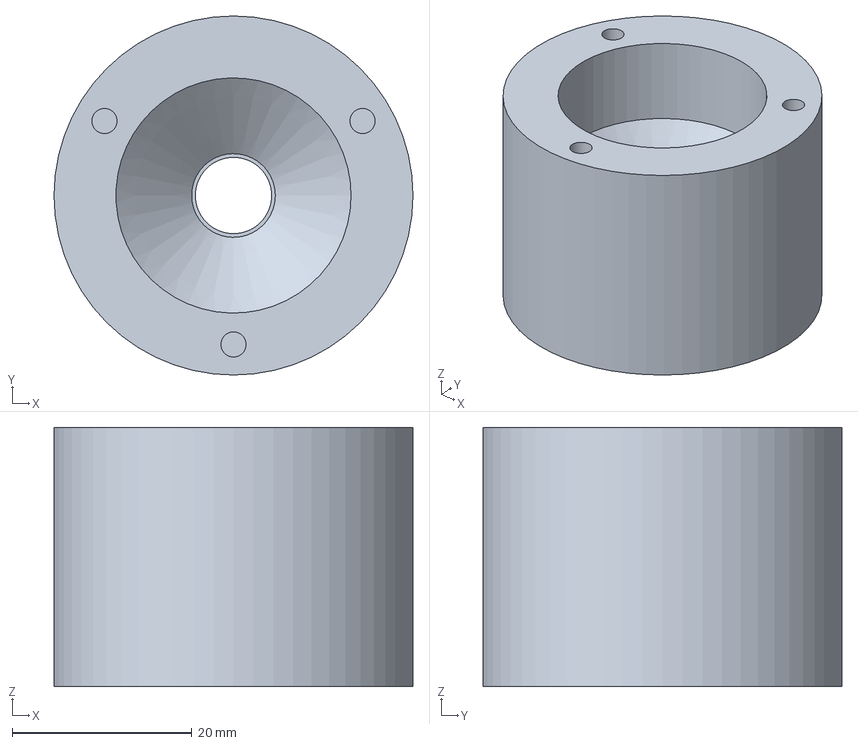
[picture p92: CAD file, 2026-11-10]
cad/output/parts/caster_cup.step
40.0 x 40.0 x 28.9 mm
