ahmedoab/cargo_robot/print/PETG/caster_shim_1mm_x4.stl

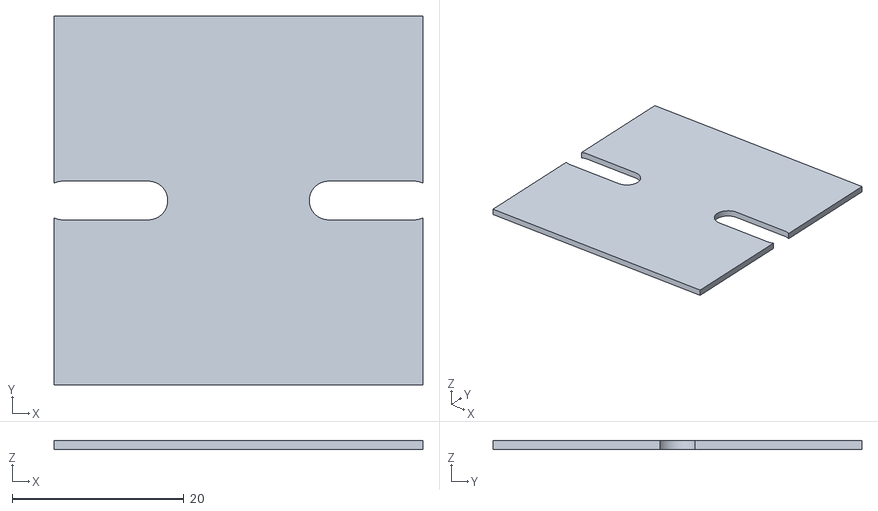
[picture p93: CAD file, 2026-10-20]
print/PETG/caster_shim_1mm_x4.stl
43.0 x 43.0 x 1.00
