ahmedoab/cargo_robot/cad/output/parts/line_sensor_bracket.step

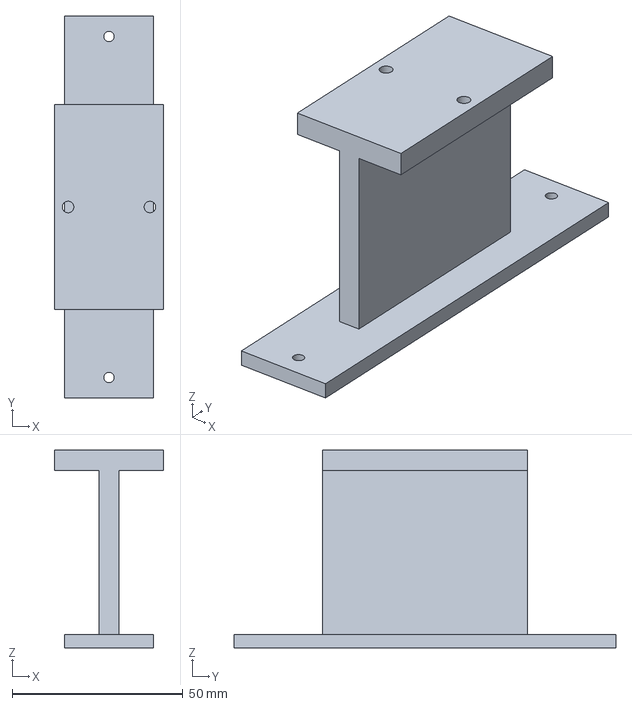
[picture p94: CAD file, 2026-10-22]
cad/output/parts/line_sensor_bracket.step
32.0 x 112.0 x 58.0 mm
