ahmedoab/cargo_robot/cad/output/parts/tof_bracket.step

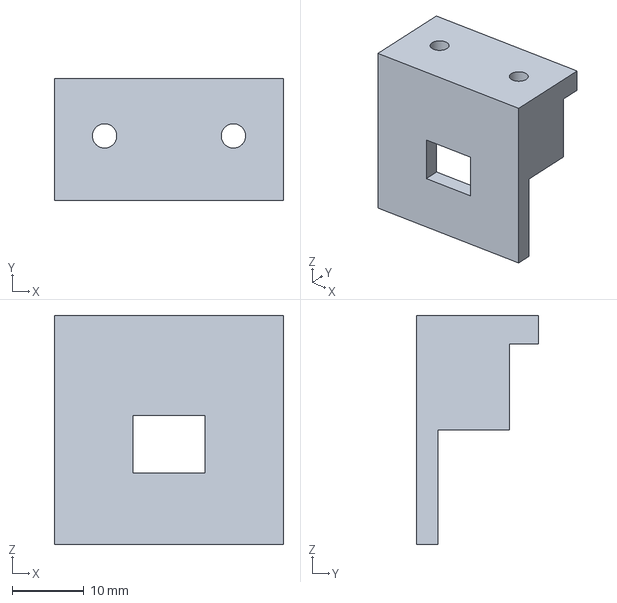
[picture p95: CAD file, 2026-10-22]
cad/output/parts/tof_bracket.step
32.0 x 17.0 x 32.0 mm
