ahmedoab/cargo_robot/cad/output/parts_step/caster_shim_2mm.step

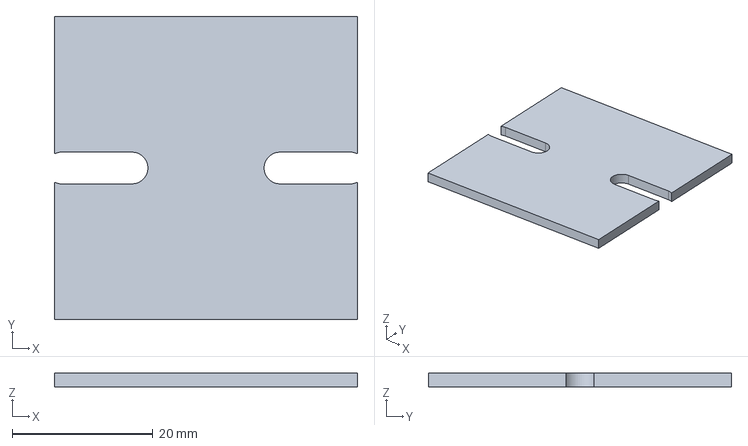
[picture p96: CAD file, 2026-10-20]
cad/output/parts_step/caster_shim_2mm.step
43.0 x 43.0 x 2.00 mm
