ahmedoab/cargo_robot/cad/output/parts/tilt_plate.step

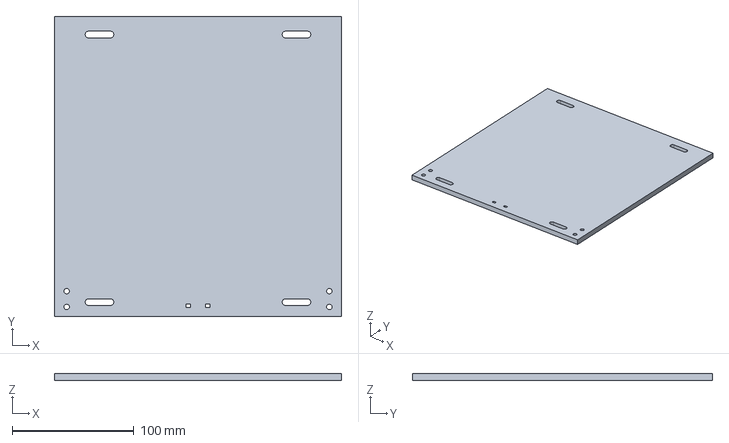
[picture p97: CAD file, 2026-10-22]
cad/output/parts/tilt_plate.step
236.0 x 247.0 x 6.00 mm
