ahmedoab/cargo_robot/cad/output/parts/cargo_plate.step

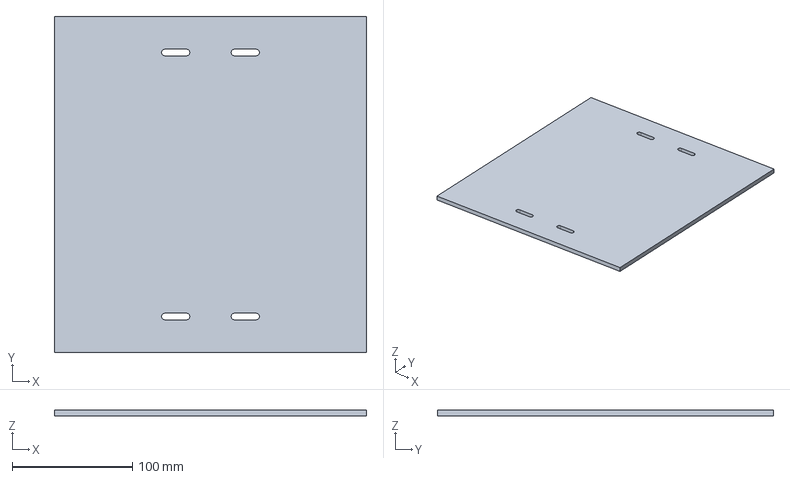
[picture p98: CAD file, 2026-10-22]
cad/output/parts/cargo_plate.step
260.0 x 280.0 x 5.00 mm
