ahmedoab/cargo_robot/cad/output/parts/bottom_plate.step

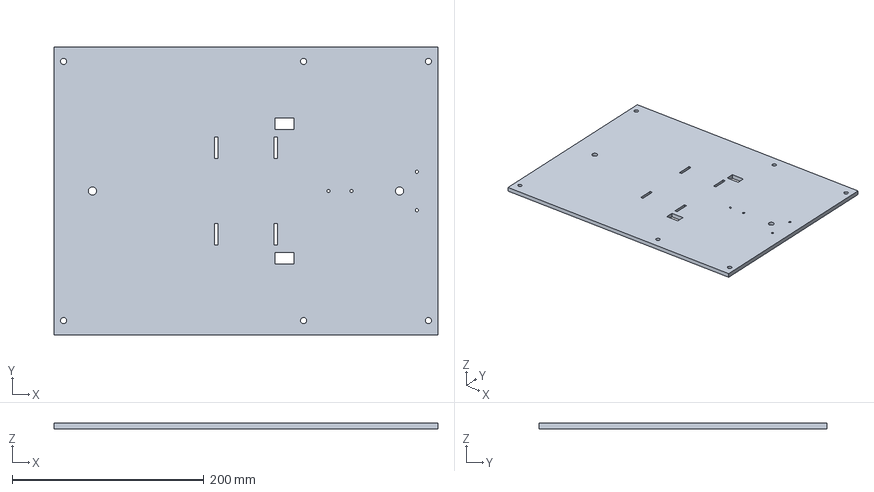
[picture p99: CAD file, 2026-10-22]
cad/output/parts/bottom_plate.step
400.0 x 300.0 x 6.00 mm
