ahmedoab/cargo_robot/cad/output/parts/pusher_carriage_R.step

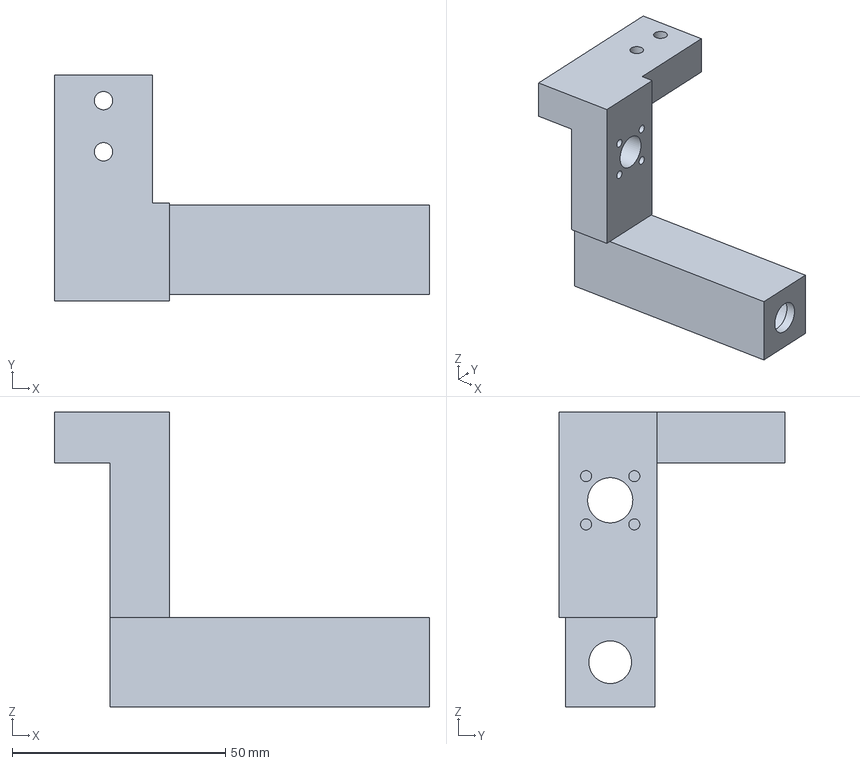
[picture p100: CAD file, 2026-10-13]
cad/output/parts/pusher_carriage_R.step
88.0 x 53.0 x 69.2 mm
