ahmedoab/cargo_robot/cad/output/parts/pusher_rail_holder_B.step

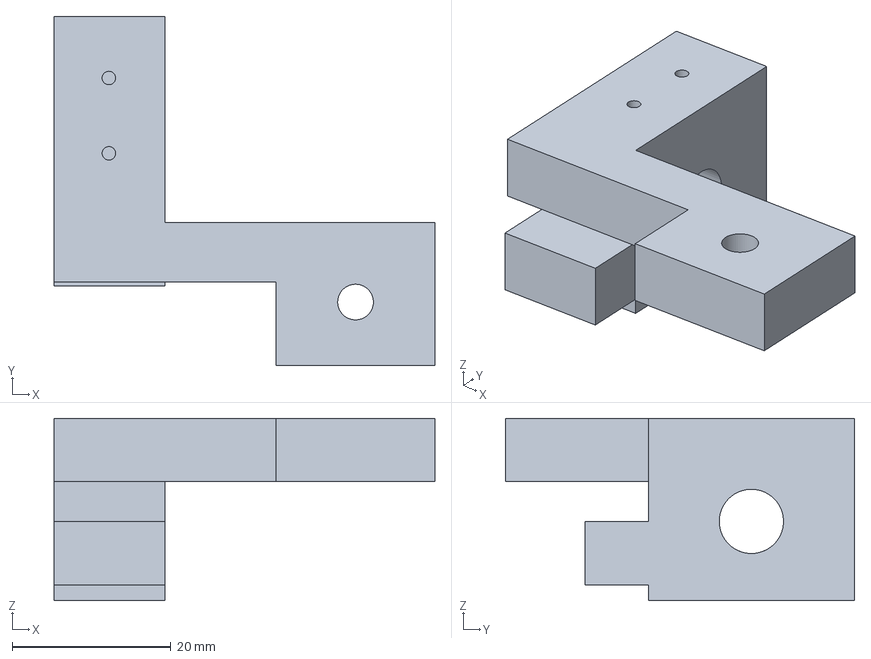
[picture p101: CAD file, 2026-10-13]
cad/output/parts/pusher_rail_holder_B.step
48.0 x 44.0 x 23.0 mm
