ahmedoab/cargo_robot/cad/output/parts/pusher_carriage_L.step

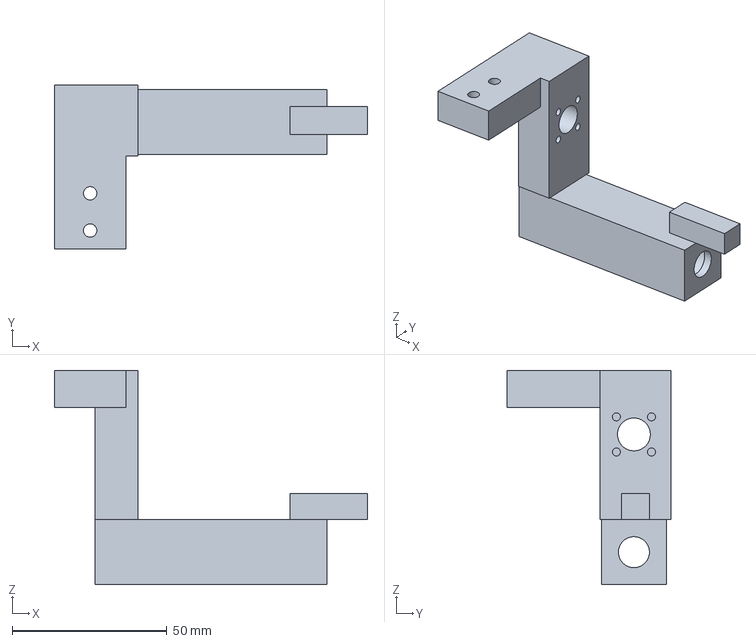
[picture p102: CAD file, 2026-10-13]
cad/output/parts/pusher_carriage_L.step
101.0 x 53.0 x 69.2 mm
