ahmedoab/cargo_robot/cad/output/parts/pusher_drive_bracket.step

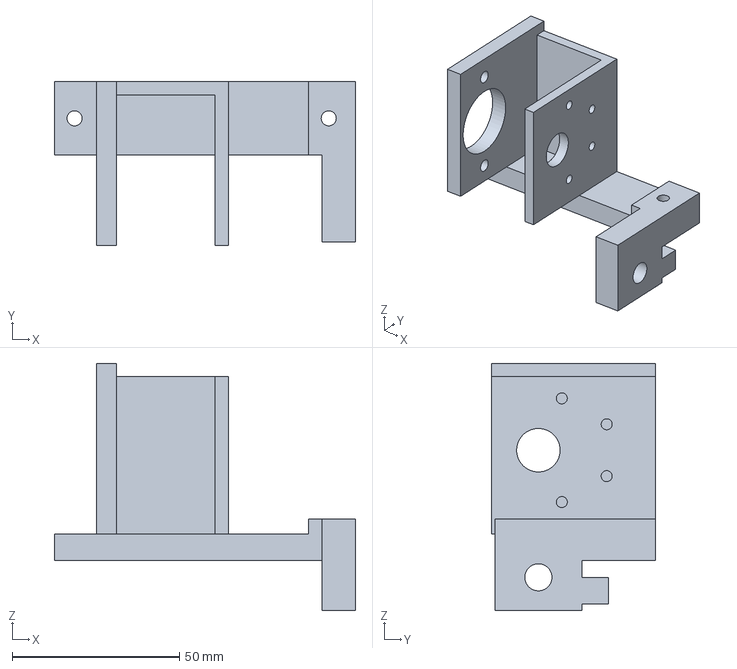
[picture p103: CAD file, 2026-10-13]
cad/output/parts/pusher_drive_bracket.step
90.0 x 49.0 x 74.0 mm
