ahmedoab/cargo_robot/(list of files, cad)

Other CAD files:
print/ABS/motor_mount_right.stl
cad/output/parts/servo_mount_rear.step
cad/output/parts_step/tub_front_left.step
print/PETG/tub_front_right.stl
cad/output/parts_step/cable_grommet.step
print/PETG/bed_rear_right.stl
cad/output/parts_step/pusher_idler_holder.step
cad/output/parts_step/pusher_carriage.step
print/PETG/bed_front_left.stl
cad/output/parts_step/battery_door.step
print/PETG/tub_rear_right.stl
cad/output/parts/horn_adapter_front.step
print/PETG/bridge_left.stl
cad/output/parts_step/rear_panel_joiner.step
print/PETG/bridge_right.stl
cad/output/parts/load_cell_spacer.step
cad/output/parts_step/motor_mount_left.step
cad/output/parts/top_deck.step
cad/output/parts_step/tub_rear_right.step
print/PETG/tub_front_left.stl
cad/output/parts_step/front_bumper.step
print/PETG/load_cell_spacer_x2.stl
print/PETG/caster_pod_x2.stl
cad/output/parts_step/rear_panel_right.step
print/PETG/tub_rear_left.stl
cad/output/parts_step/bed_rear_left.step
print/PETG/bed_front_right.stl
cad/output/parts_step/bed_front_left.step
print/PETG/caster_shim_2mm_x4.stl
cad/output/parts_step/tub_front_right.step
print/PETG/battery_tray.stl
cad/output/parts_step/rear_panel_left.step
cad/output/parts/pusher_rail_holder_A.step
cad/output/parts_step/bed_rear_right.step
cad/output/parts_step/pusher_blade.step
cad/output/parts_step/battery_pad.step
cad/output/parts/camera_mount.step
cad/output/parts_step/ultrasonic_clip.step
cad/output/parts_step/motor_mount_right.step
cad/output/parts_step/caster_shim_1mm.step
cad/output/parts_step/front_cover.step
cad/output/parts_step/pusher_motor_holder.step
cad/output/parts_step/bridge_right.step
cad/output/parts_step/guide_rail.step
cad/output/parts_step/motor_clamp_cap.step
backup_v2/cad/output/dxf/top_deck.dxf
backup_v2/cad/output/parts/top_deck.stl
cad/autocad/CargoRobot_v2.dxf
cad/autocad/CargoRobot_v2_schematics.dxf
cad/output/dxf/bottom_plate.dxf
cad/output/dxf/cargo_plate.dxf
cad/output/dxf/tilt_plate.dxf
cad/output/dxf/top_deck.dxf
cad/output/parts/bed_rest.stl
cad/output/parts/bed_riser.stl
cad/output/parts/bottom_plate.stl
cad/output/parts/camera_mount.stl
cad/output/parts/cargo_plate.stl
cad/output/parts/caster_cup.stl
cad/output/parts/caster_ring.stl
cad/output/parts/horn_adapter_front.stl
cad/output/parts/horn_adapter_rear.stl
cad/output/parts/line_sensor_bar.stl
cad/output/parts/line_sensor_bracket.stl
cad/output/parts/load_cell_spacer.stl
cad/output/parts/pusher_blade.step
cad/output/parts/pusher_blade.stl
cad/output/parts/pusher_carriage_L.stl
cad/output/parts/pusher_carriage_R.stl
cad/output/parts/pusher_drive_bracket.stl
cad/output/parts/pusher_rail_holder_A.stl
cad/output/parts/pusher_rail_holder_B.stl
cad/output/parts/servo_clamp.stl
cad/output/parts/servo_mount_front.stl
cad/output/parts/servo_mount_rear.stl
cad/output/parts/sonar_bracket.stl
cad/output/parts/tilt_plate.stl
cad/output/parts/tof_bracket.stl
cad/output/parts/top_deck.stl
cad/output/parts_step/line_sensor_bar.step
cad/output/parts_step/load_cell_spacer.step
cad/output/parts_step/tof_bracket.step
conveyor/output/conveyor.stl
