ahmedoab/cargo_robot/cad/autocad/previews/E03_CONTROL_and_SENSOR_WIRING.png

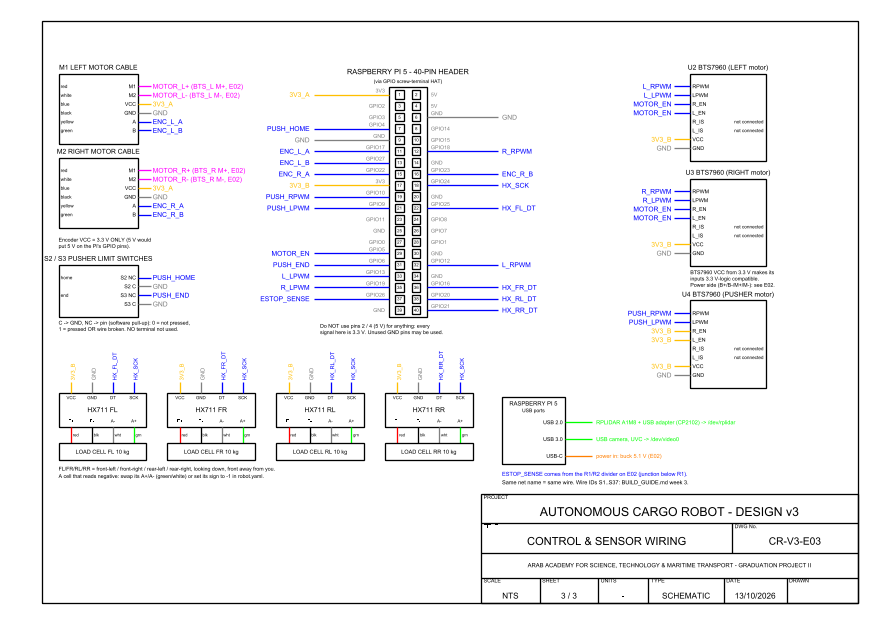
cad/autocad/previews/E03_CONTROL_and_SENSOR_WIRING.png
