ahmedoab/cargo_robot/cad/autocad/previews/E03_ESP32_WIRING.png

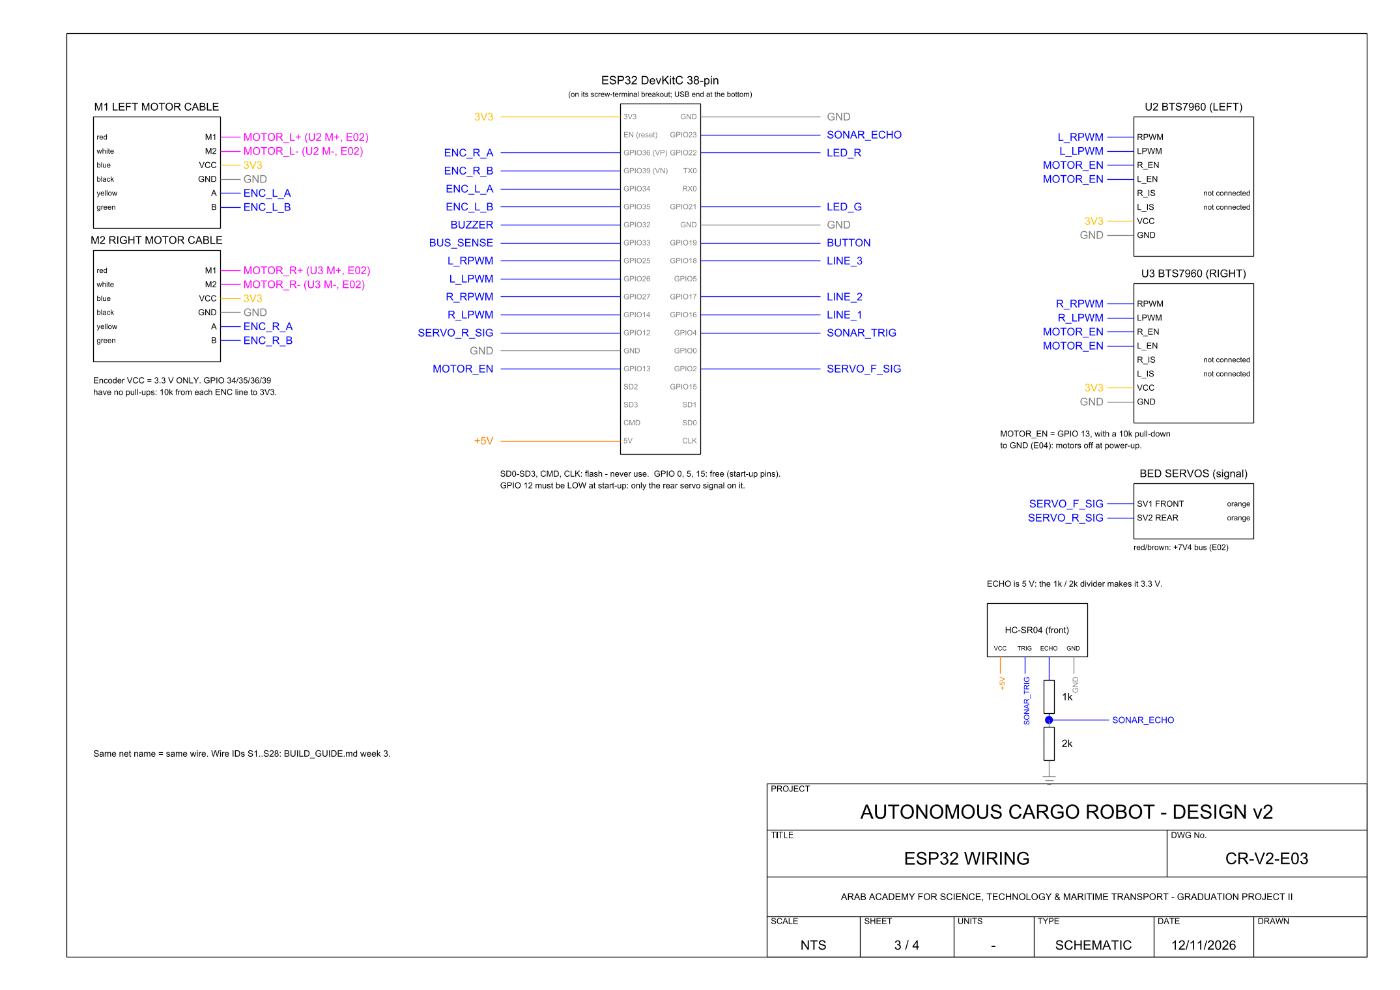
cad/autocad/previews/E03_ESP32_WIRING.png
