ahmedoab/cargo_robot/cad/autocad/CargoRobot_v3_schematics.pdf

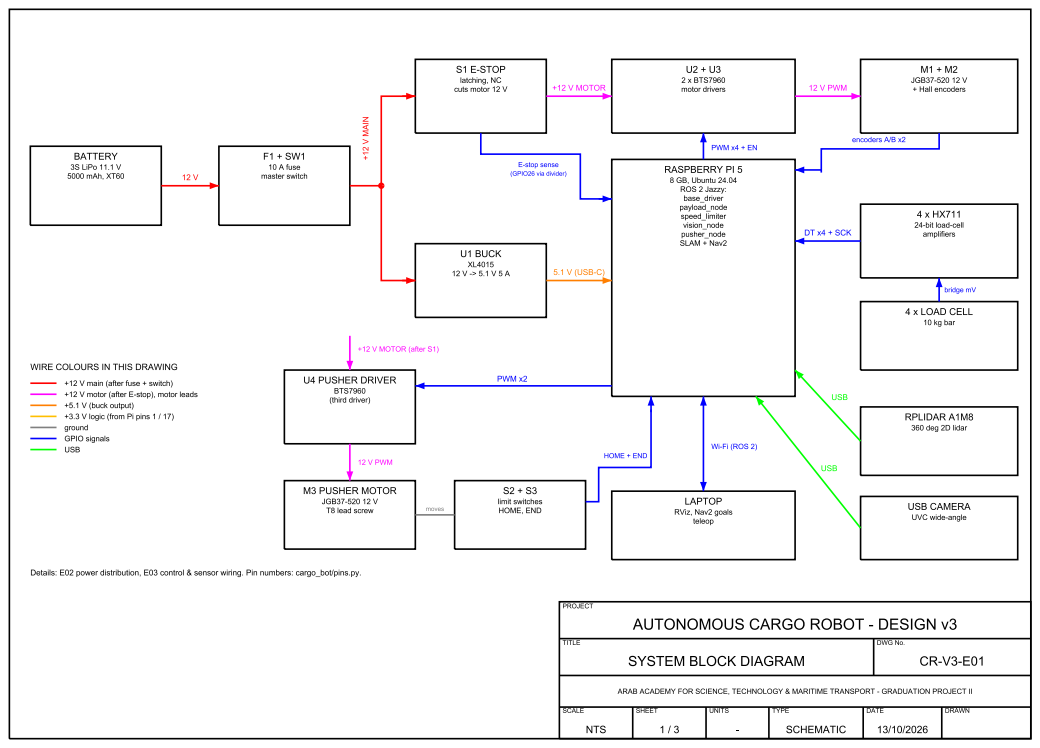
[picture p113: page 1]

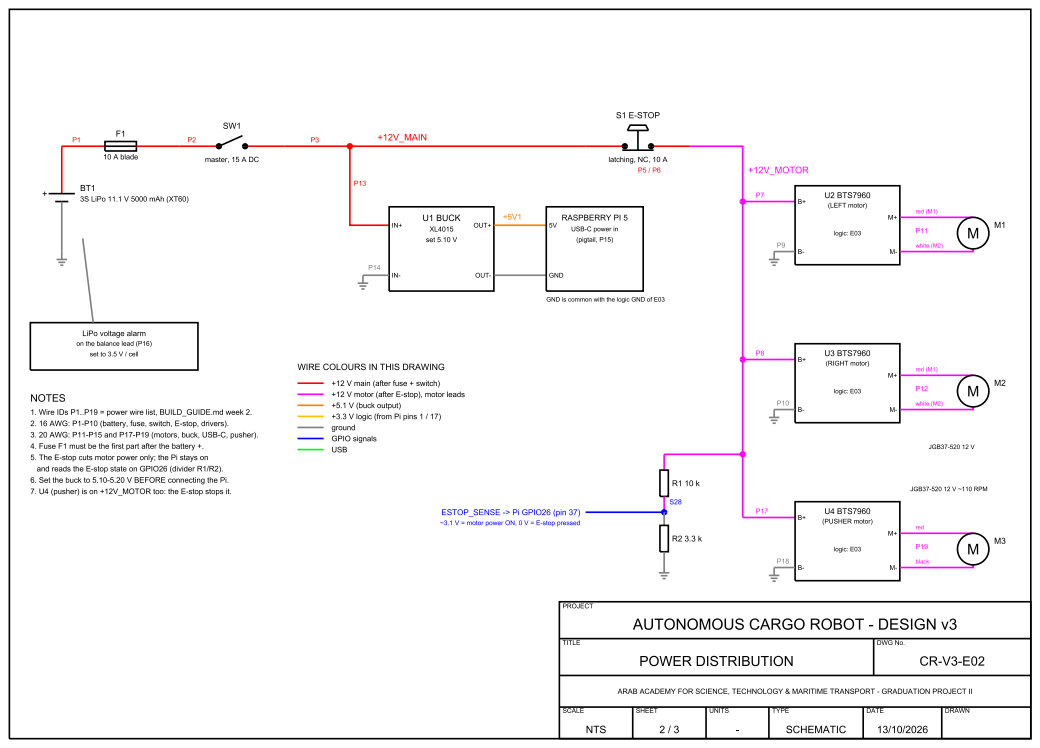
[picture p114: page 2]

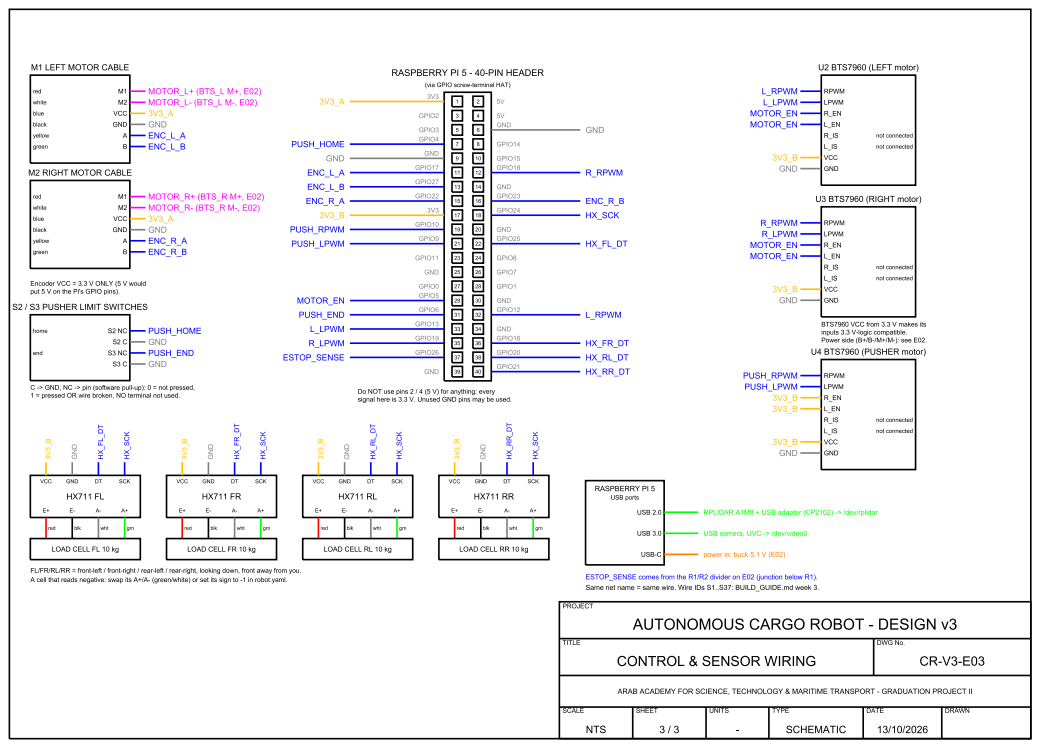
[picture p115: page 3]
