ahmedoab/cargo_robot/backup_v2/cad/autocad/CargoRobot_v2_schematics.pdf

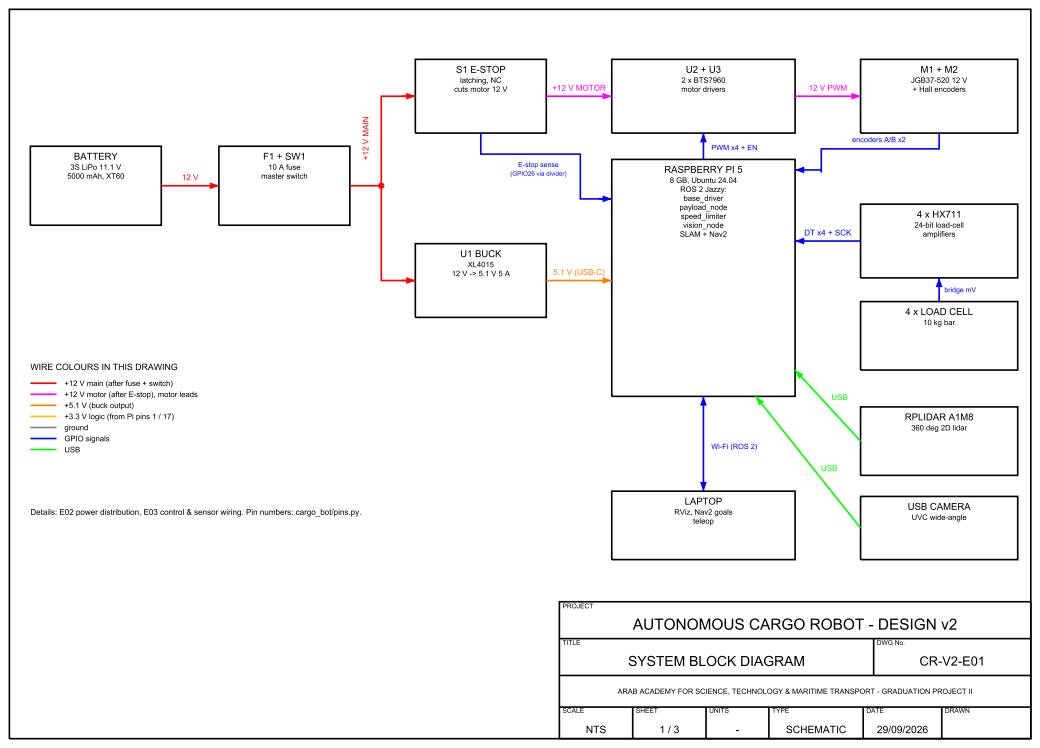
[picture p116: page 1]

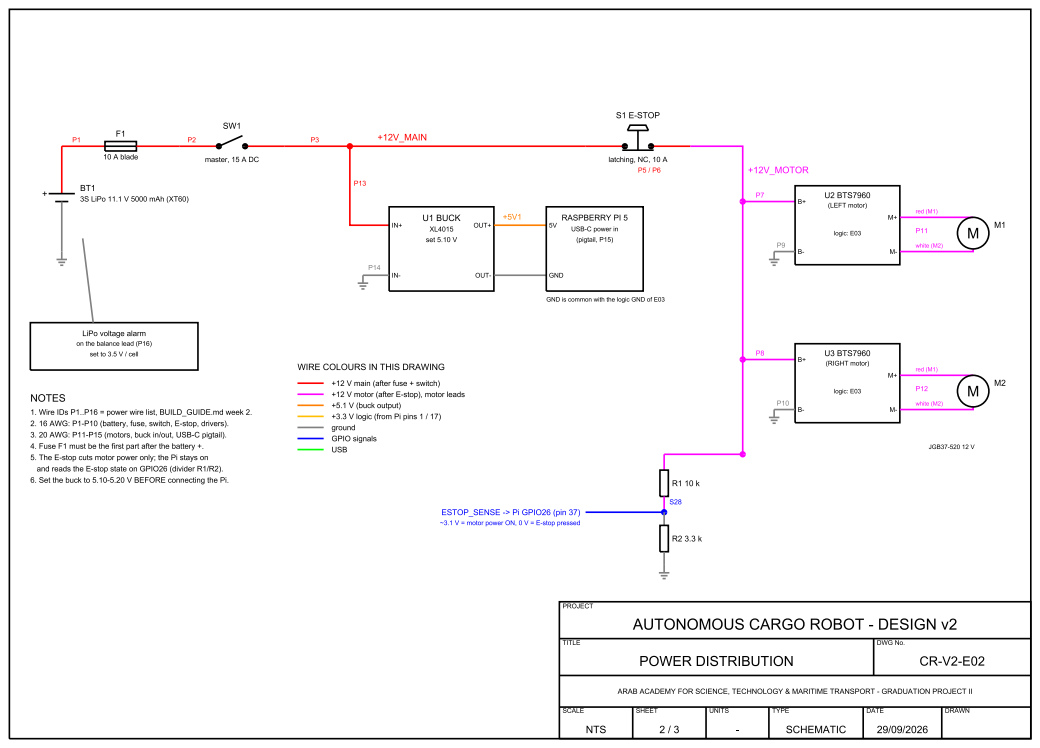
[picture p117: page 2]

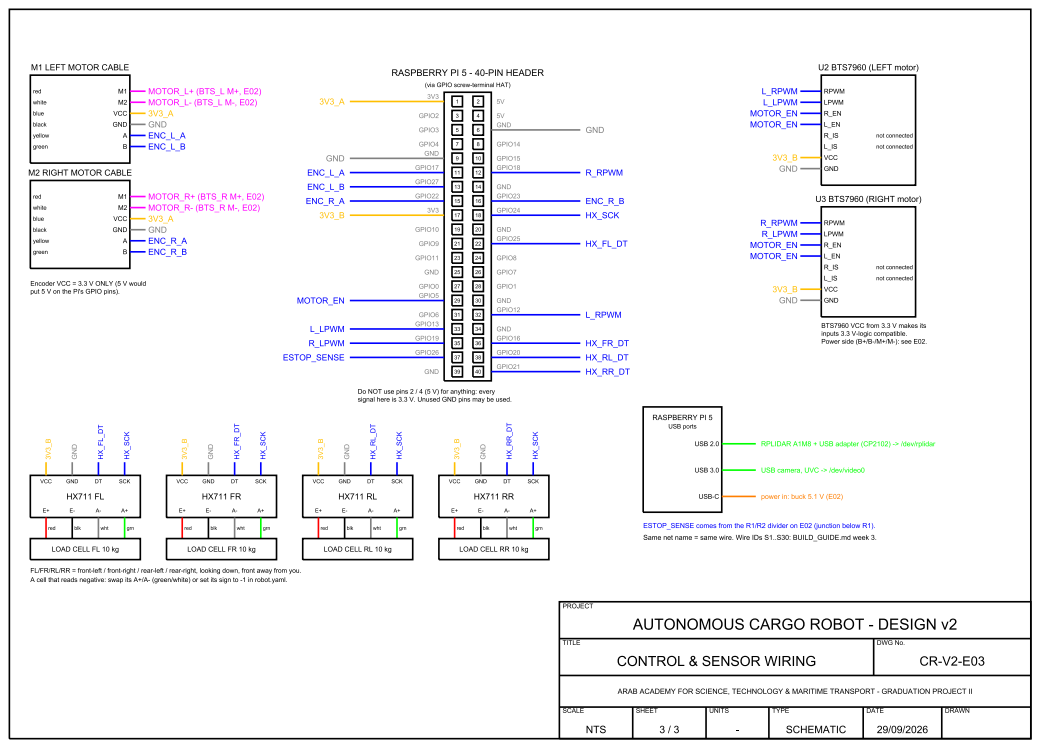
[picture p118: page 3]
