ahmedoab/cargo_robot/cad/autocad/CargoRobot_v3_drawings.pdf

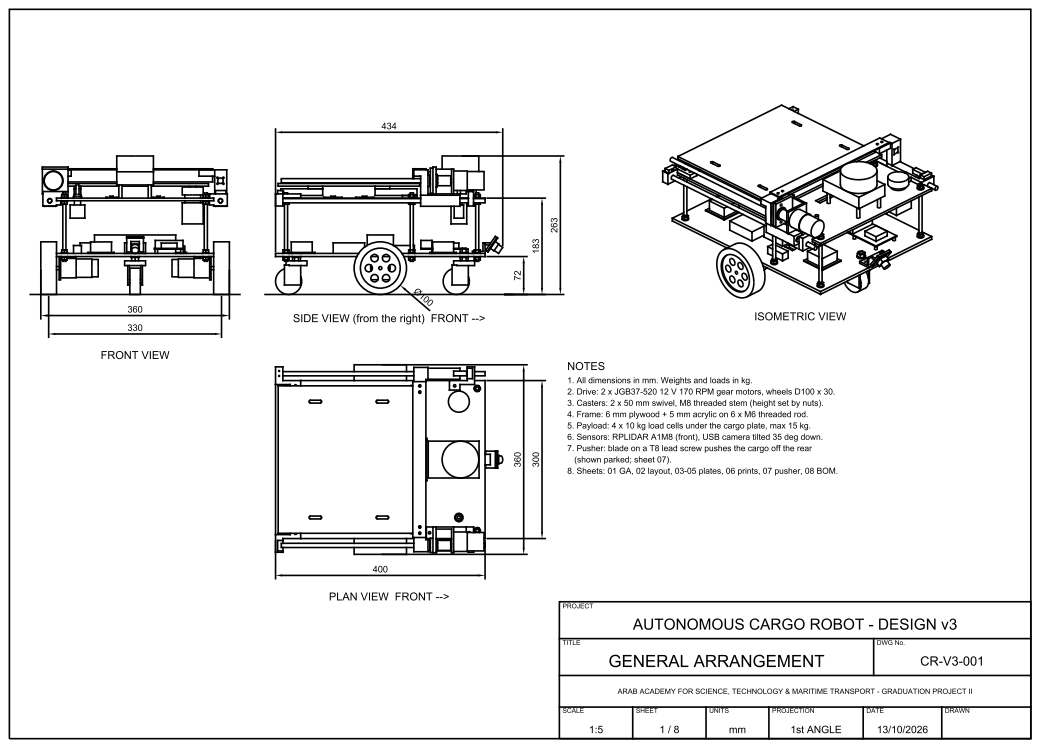
[picture p119: page 1]

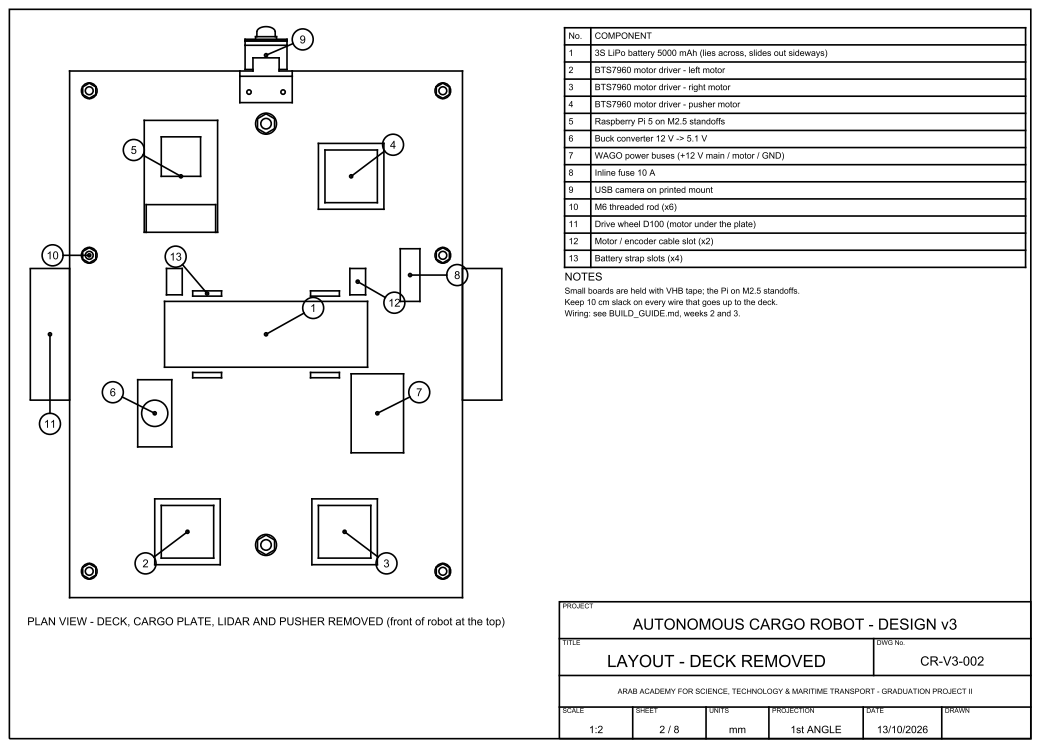
[picture p120: page 2]

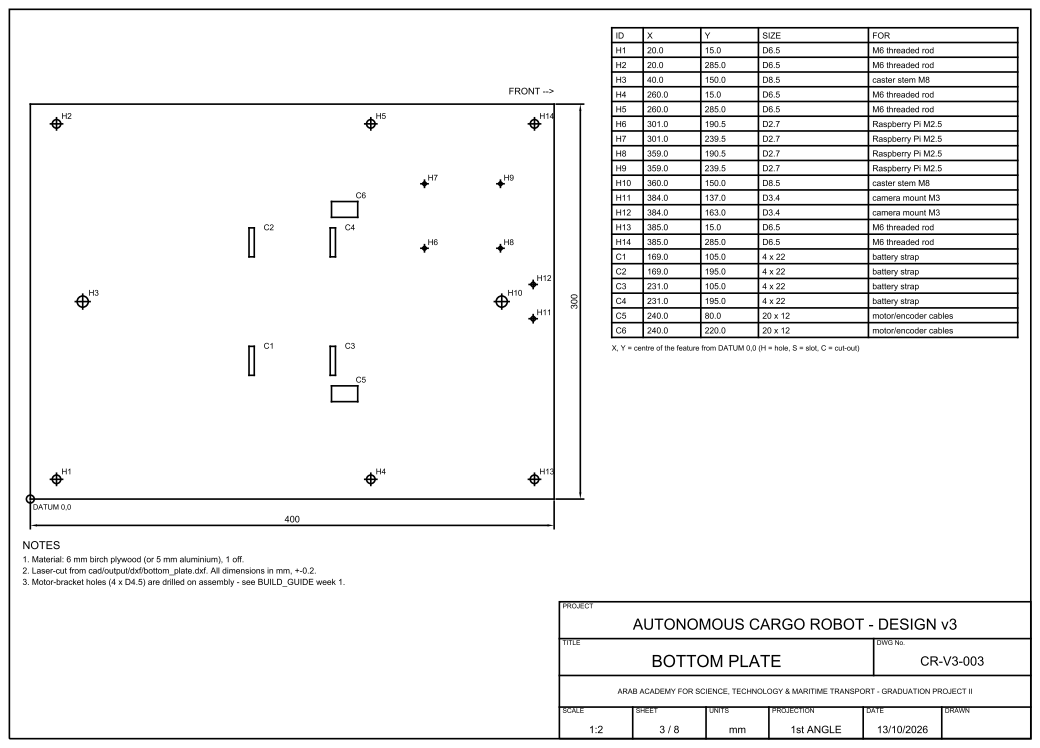
[picture p121: page 3]

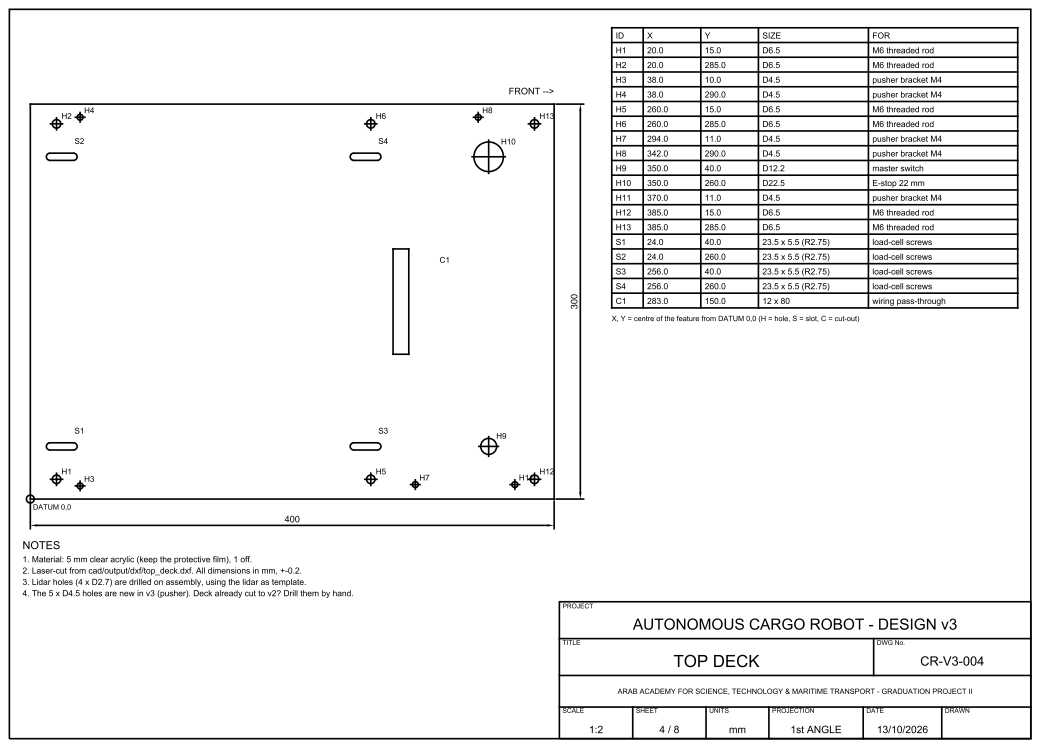
[picture p122: page 4]

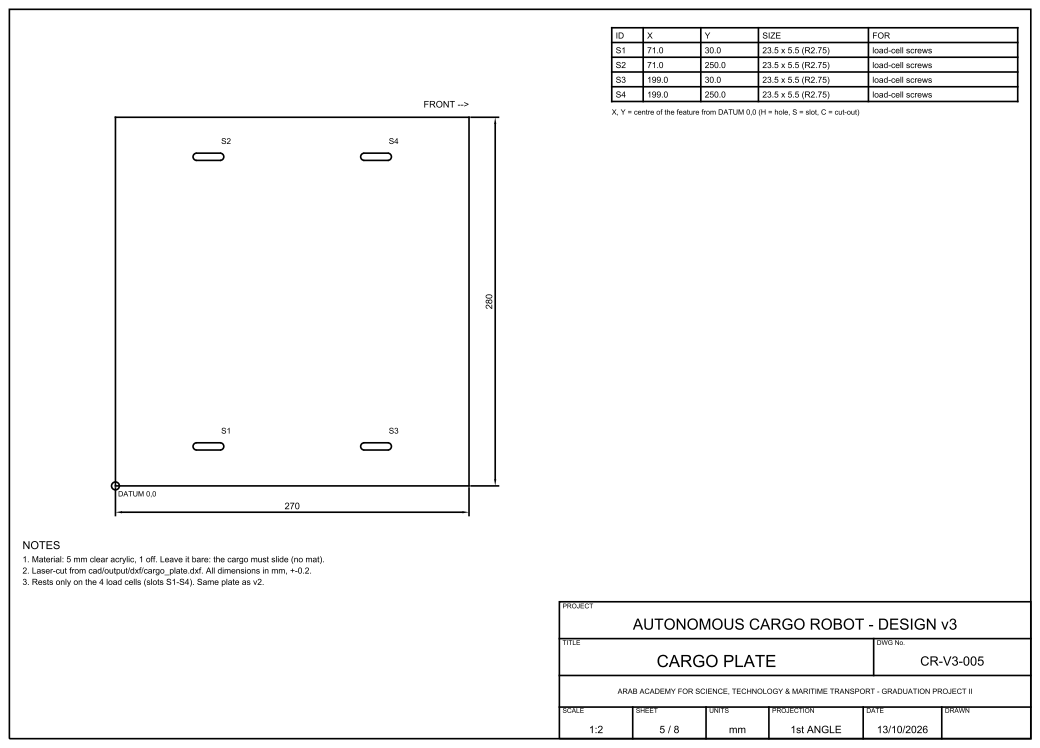
[picture p123: page 5]

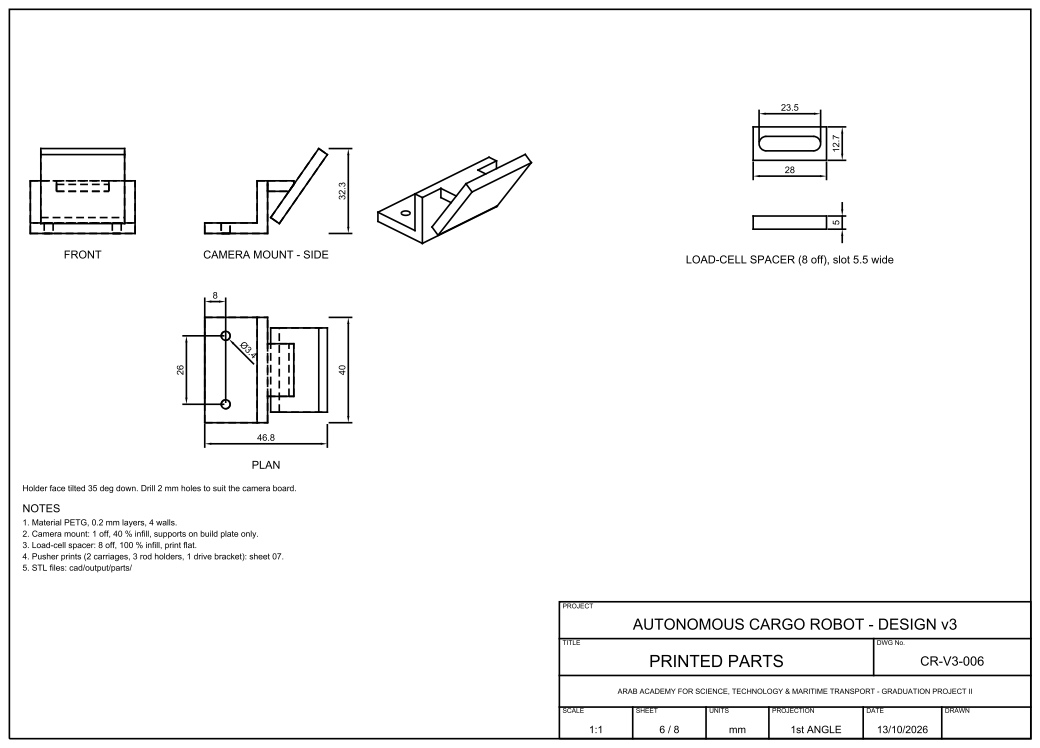
[picture p124: page 6]

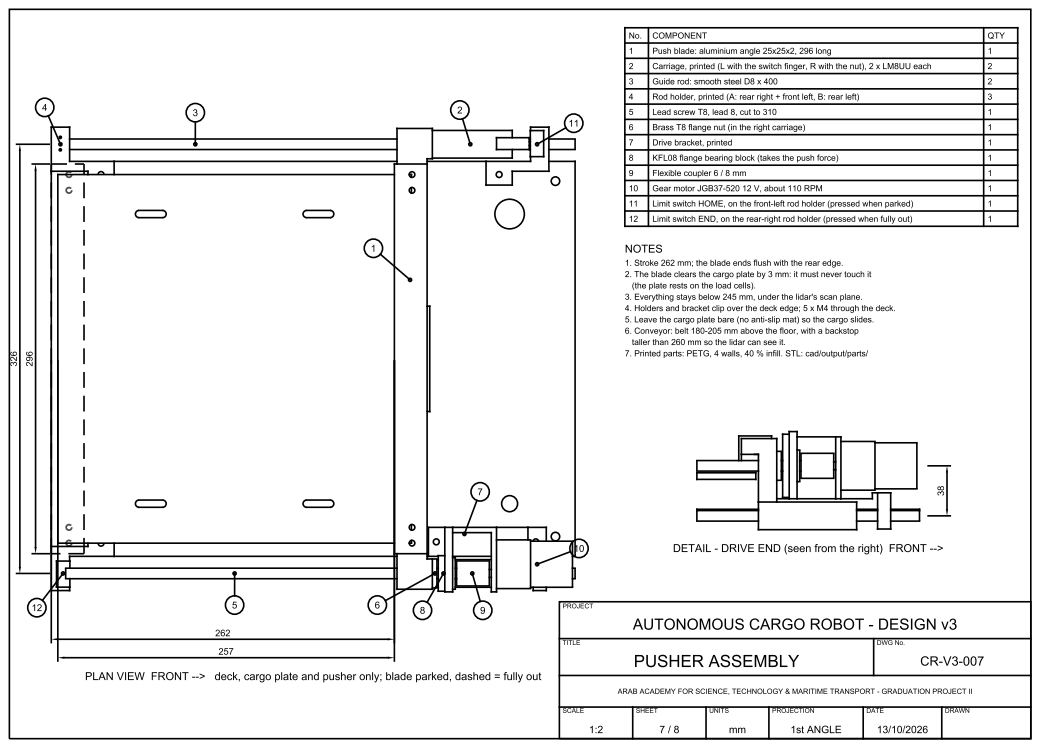
[picture p125: page 7]

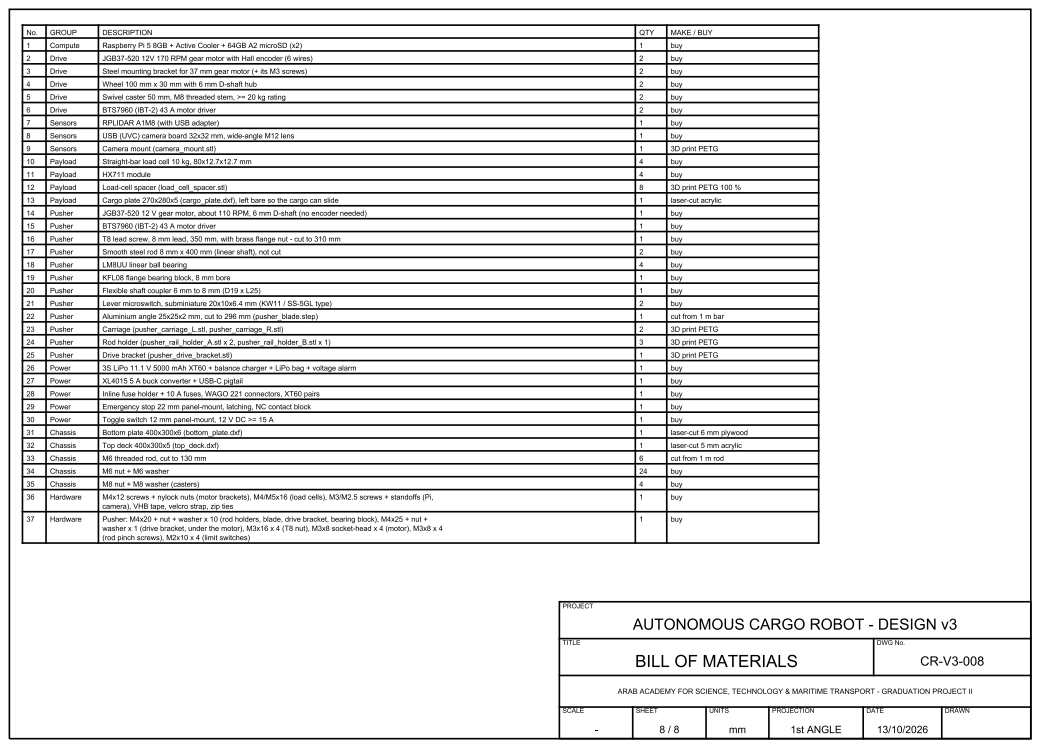
[picture p126: page 8]
