ahmedoab/cargo_robot/backup_v2/cad/autocad/CargoRobot_v2_drawings.pdf

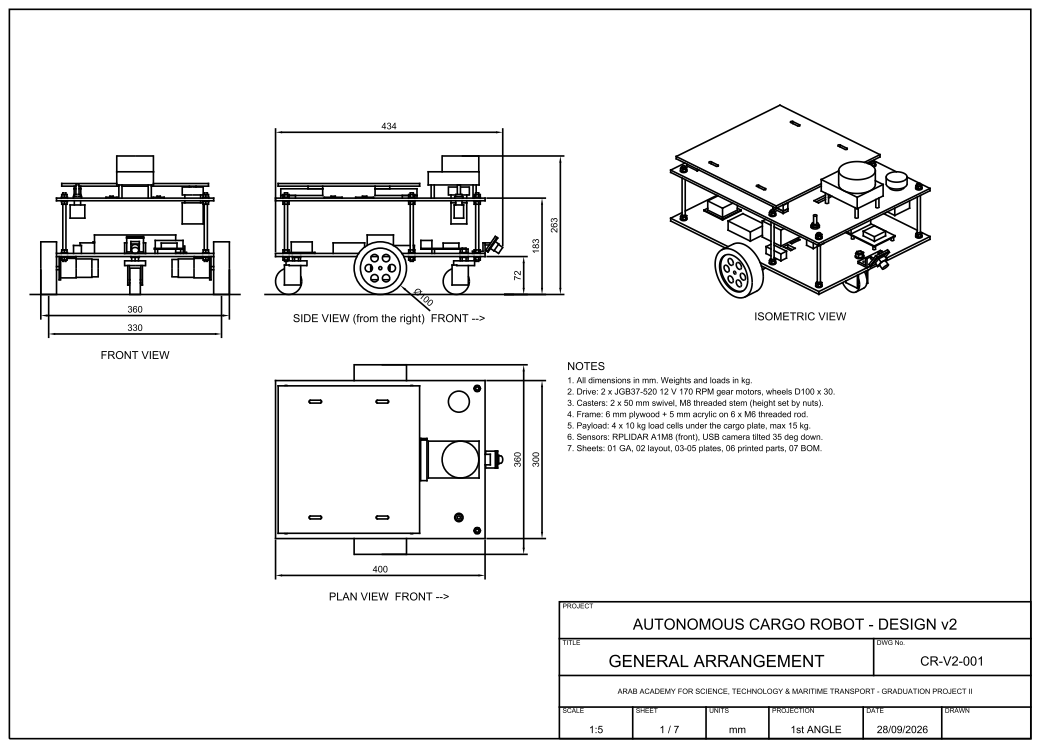
[picture p127: page 1]

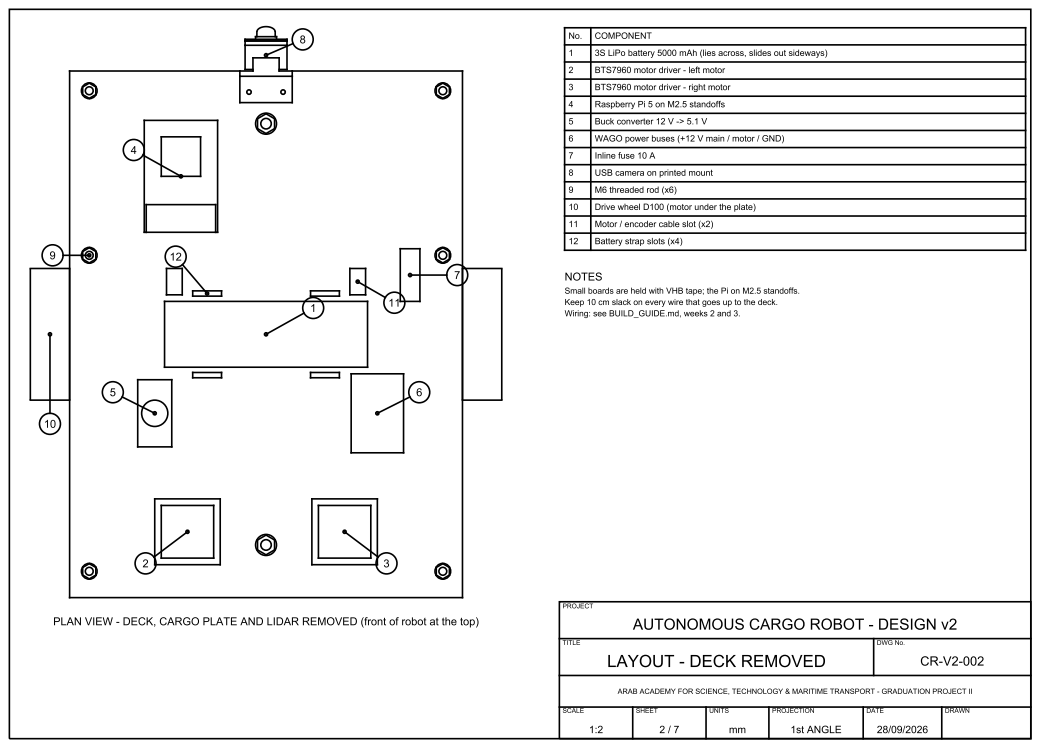
[picture p128: page 2]

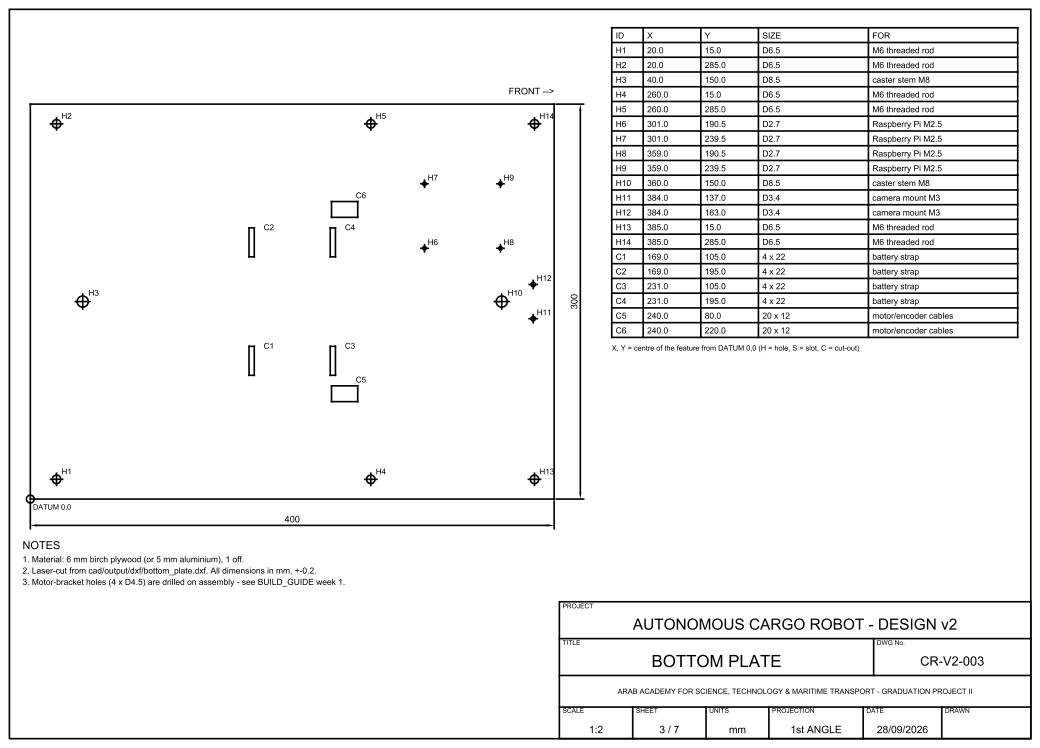
[picture p129: page 3]

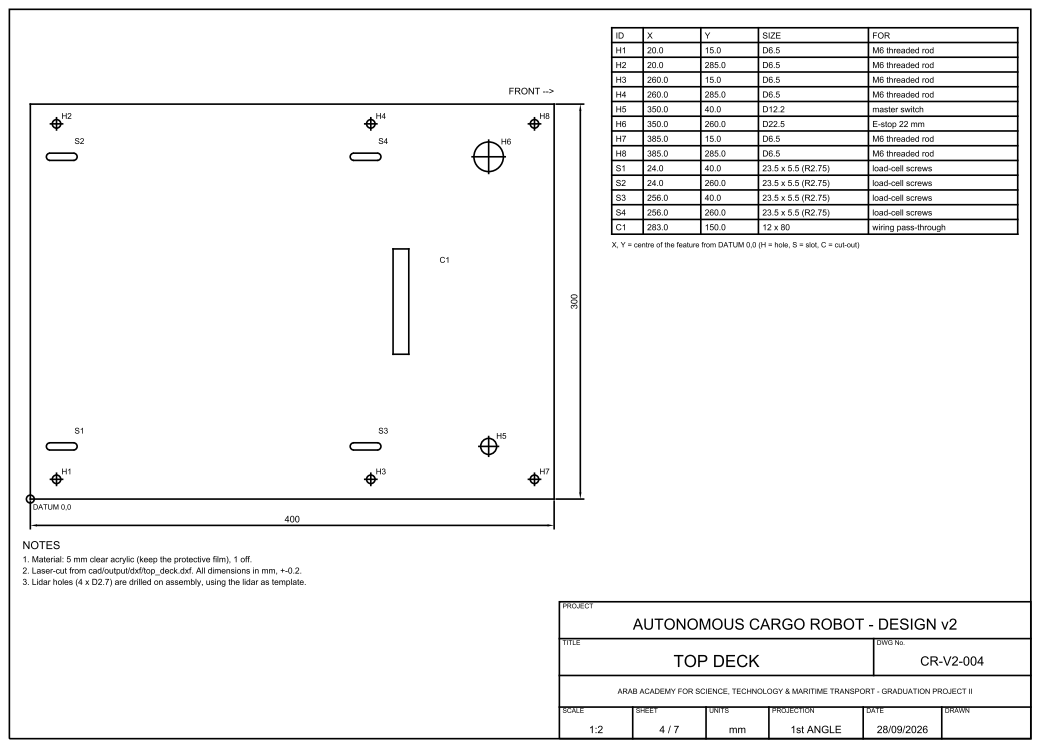
[picture p130: page 4]

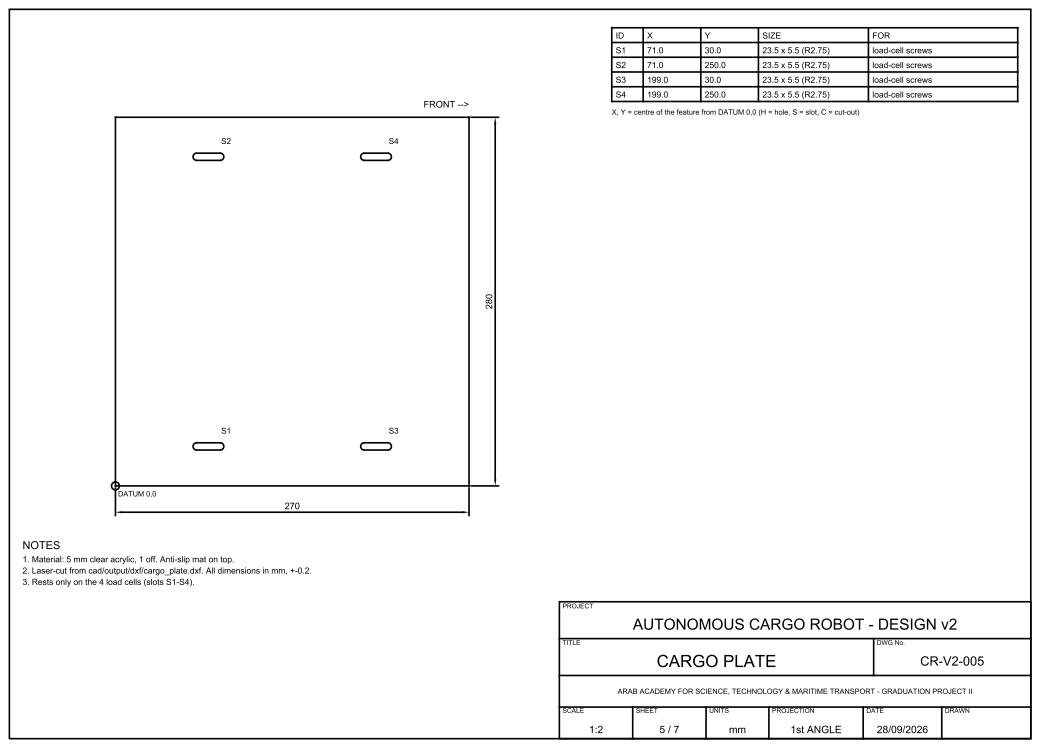
[picture p131: page 5]

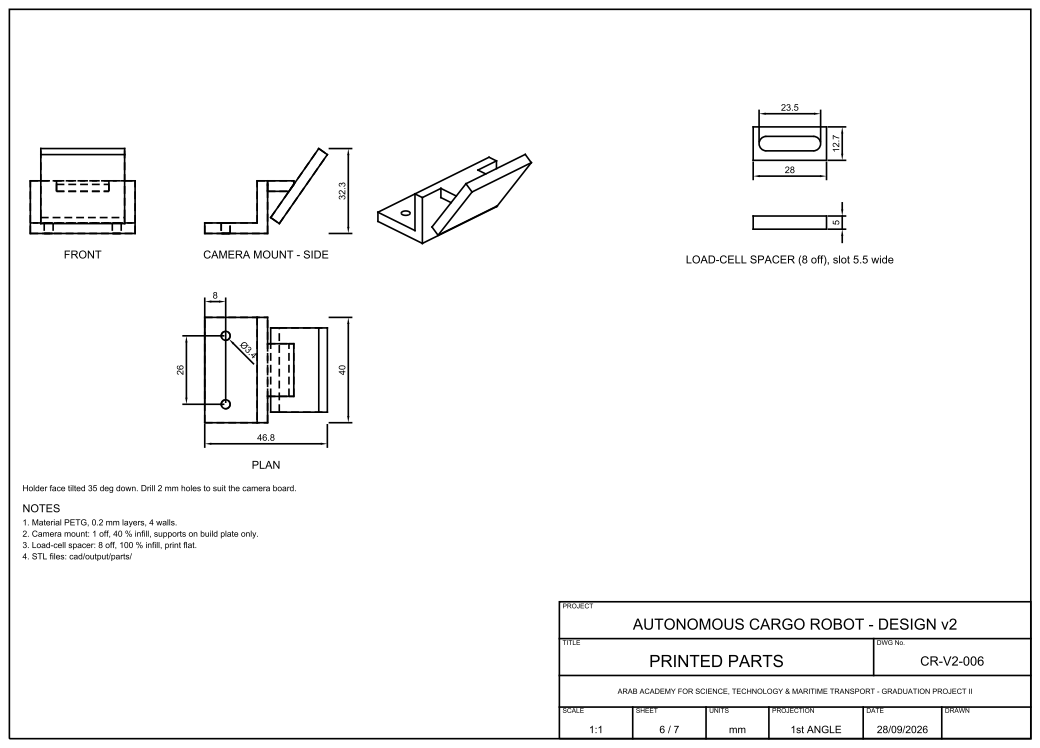
[picture p132: page 6]

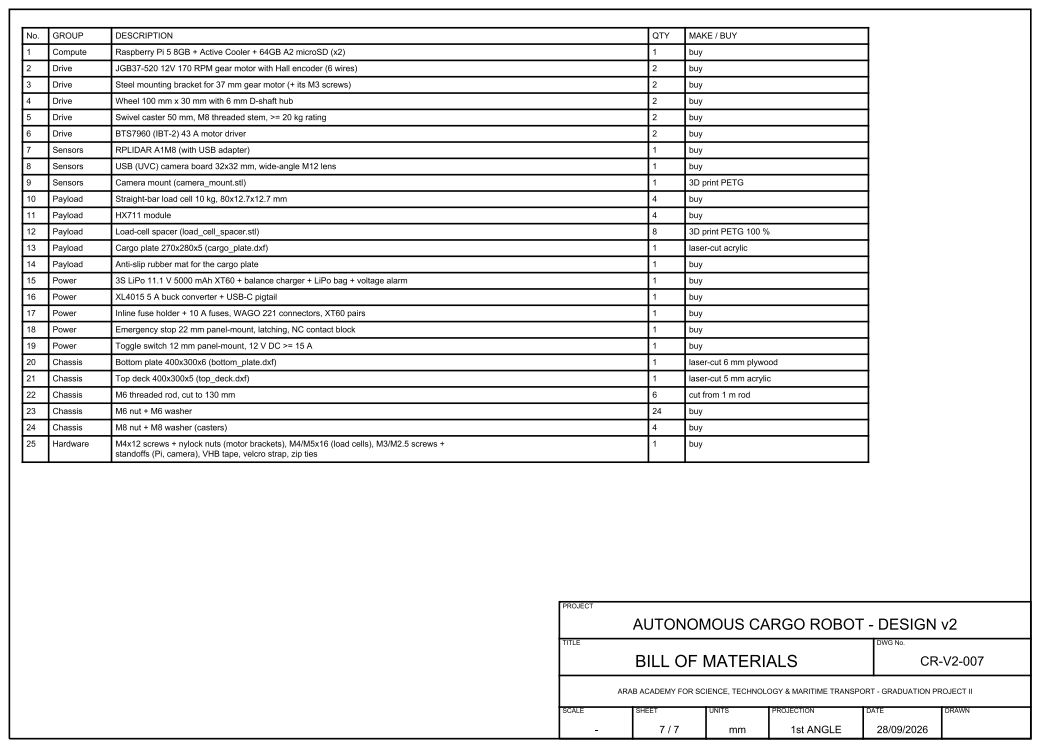
[picture p133: page 7]
