ahmedoab/cargo_robot/cad/autocad/CargoRobot_v2_drawings.pdf

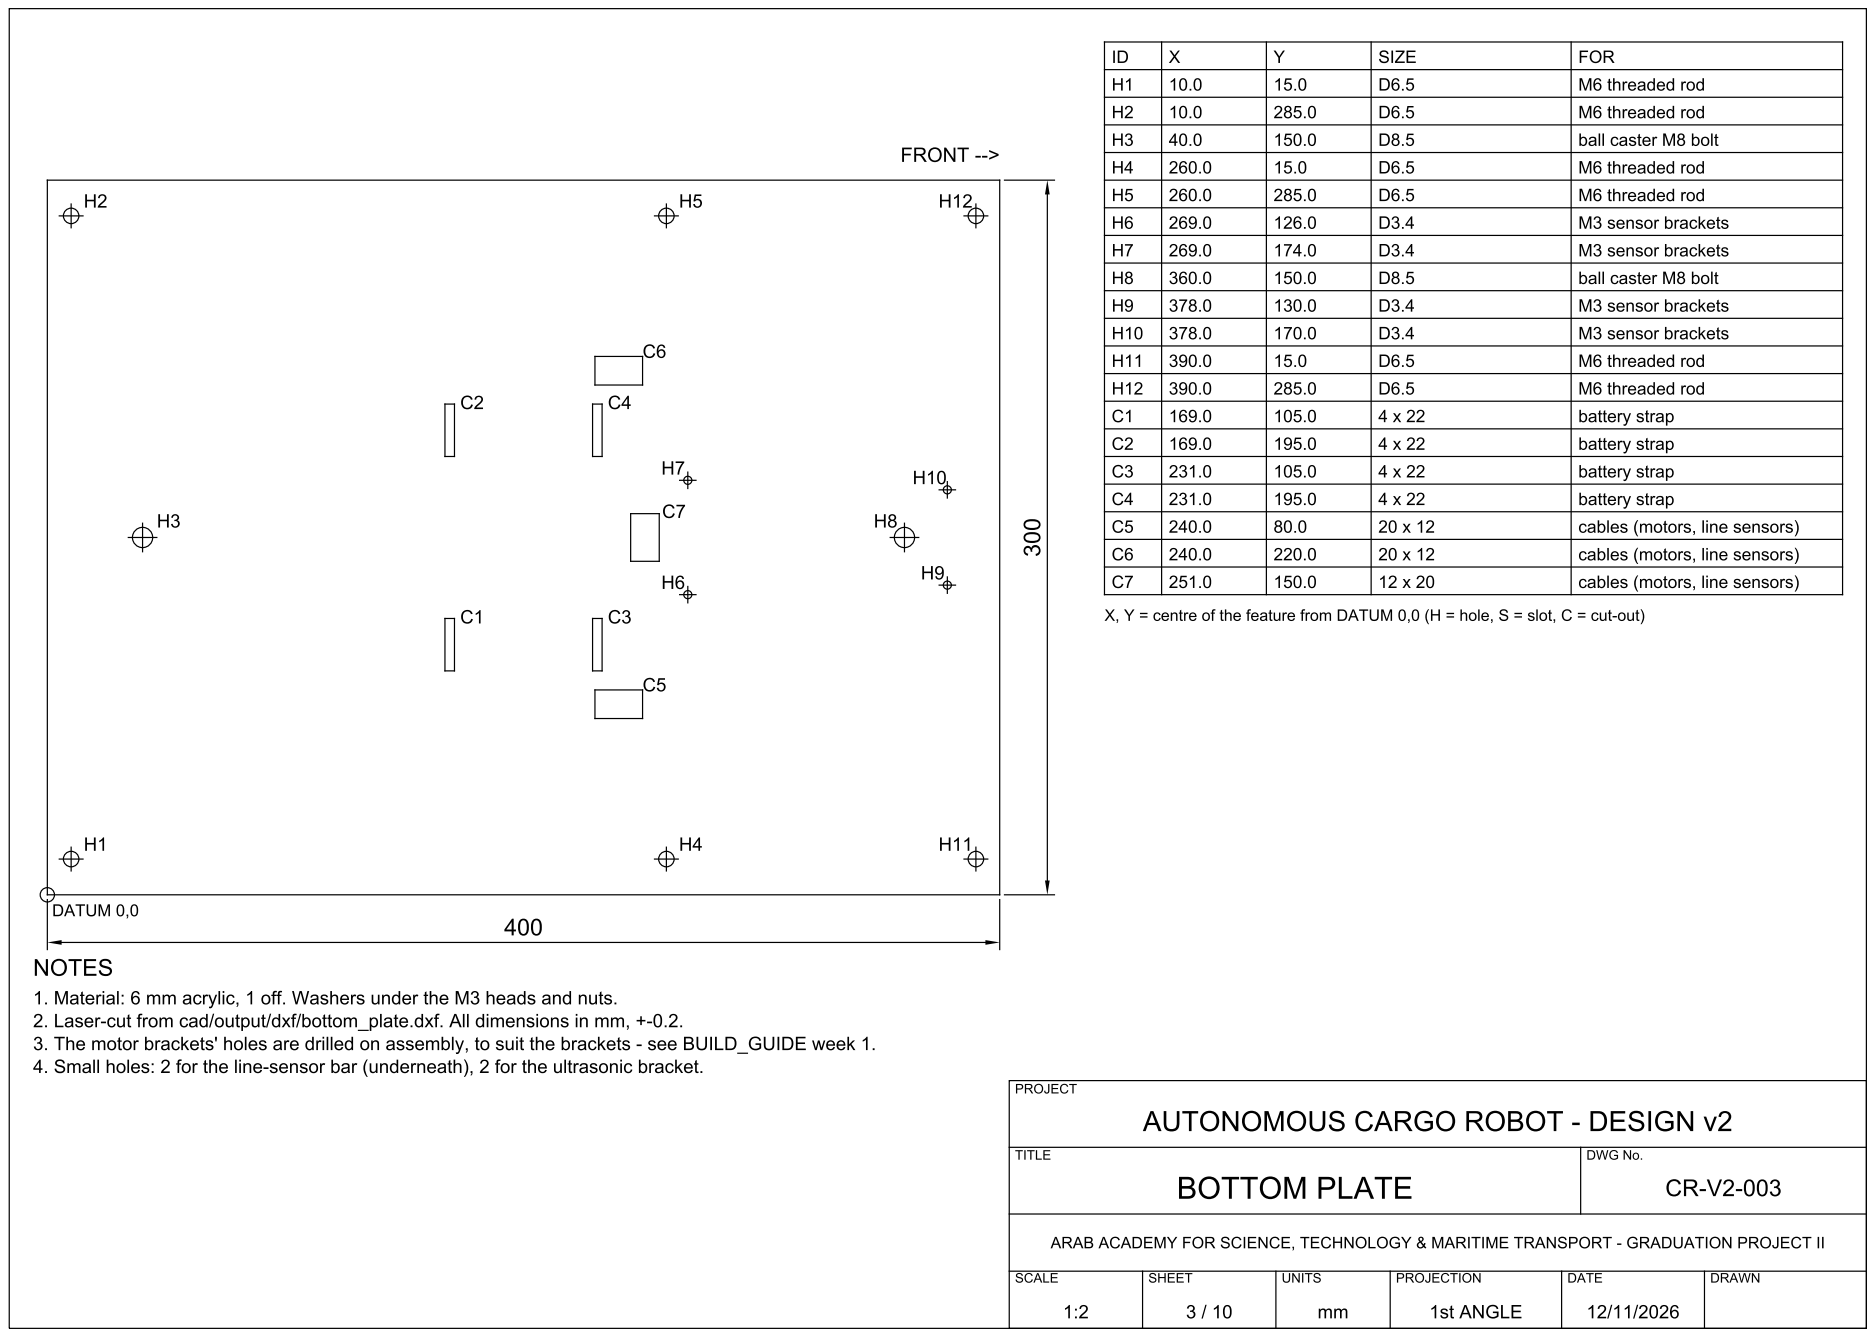
[picture p134: page 3]

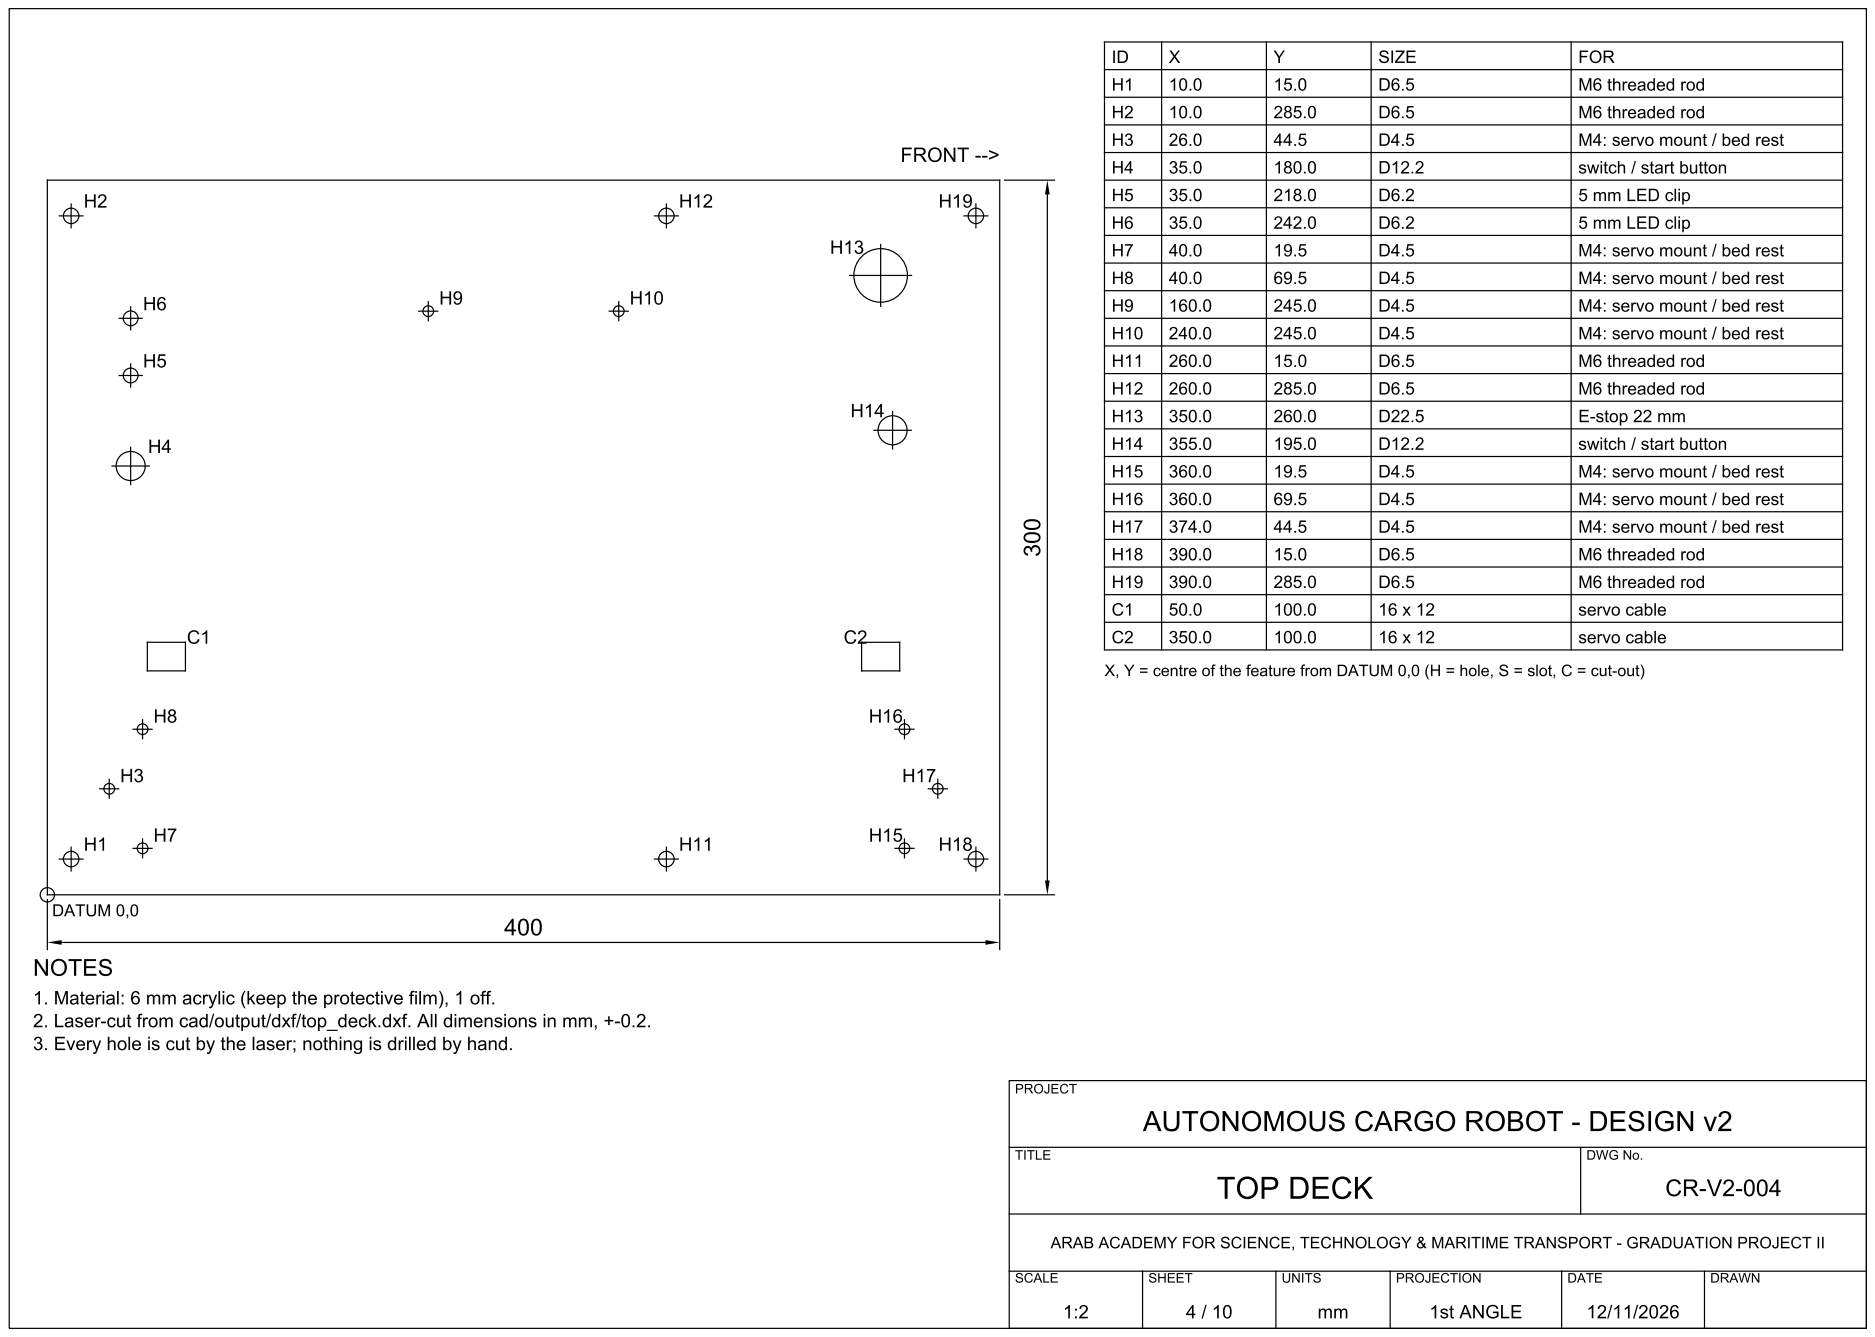
[picture p135: page 4]

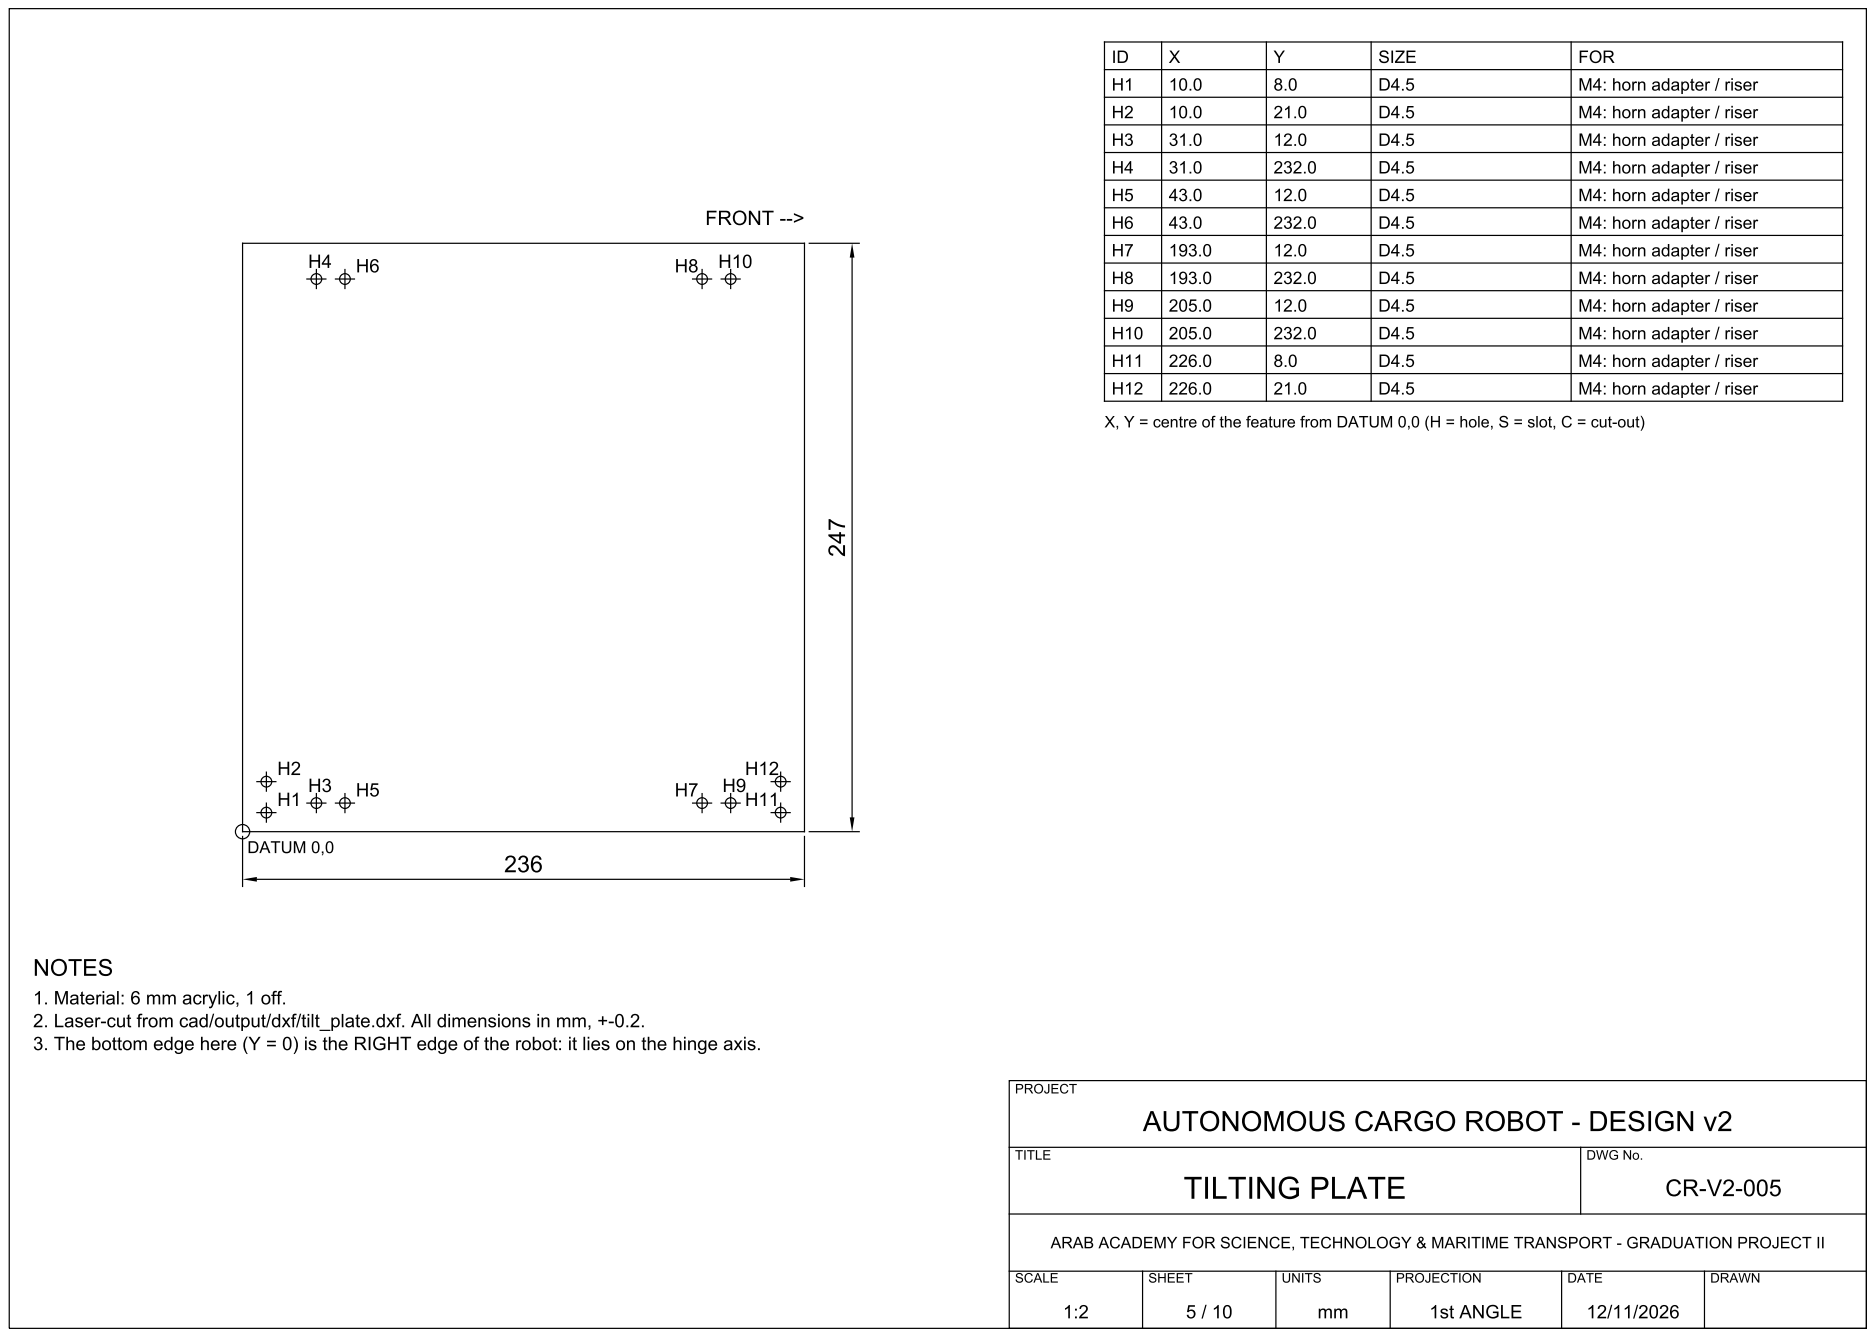
[picture p136: page 5]

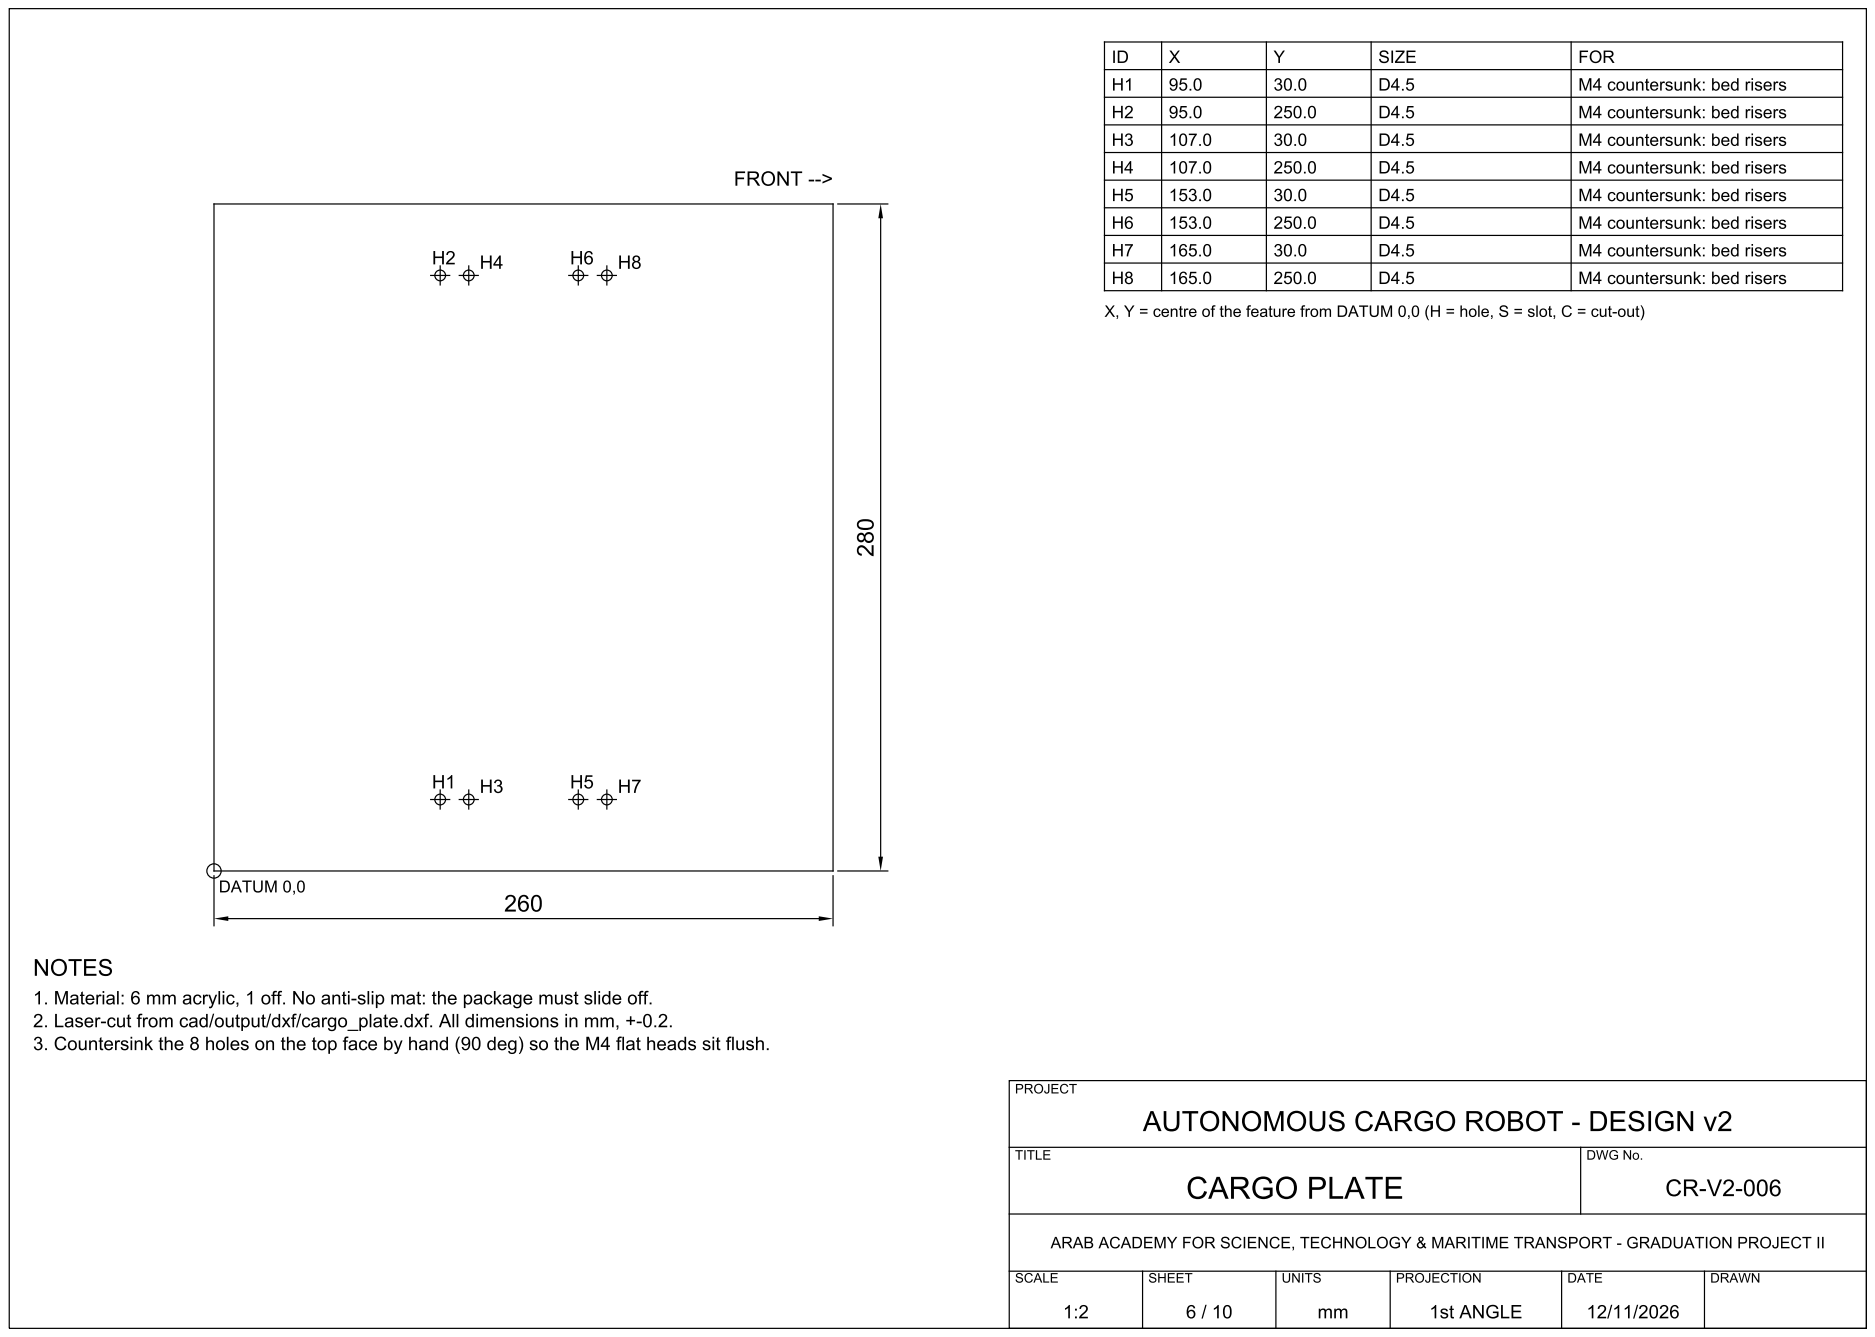
[picture p137: page 6]


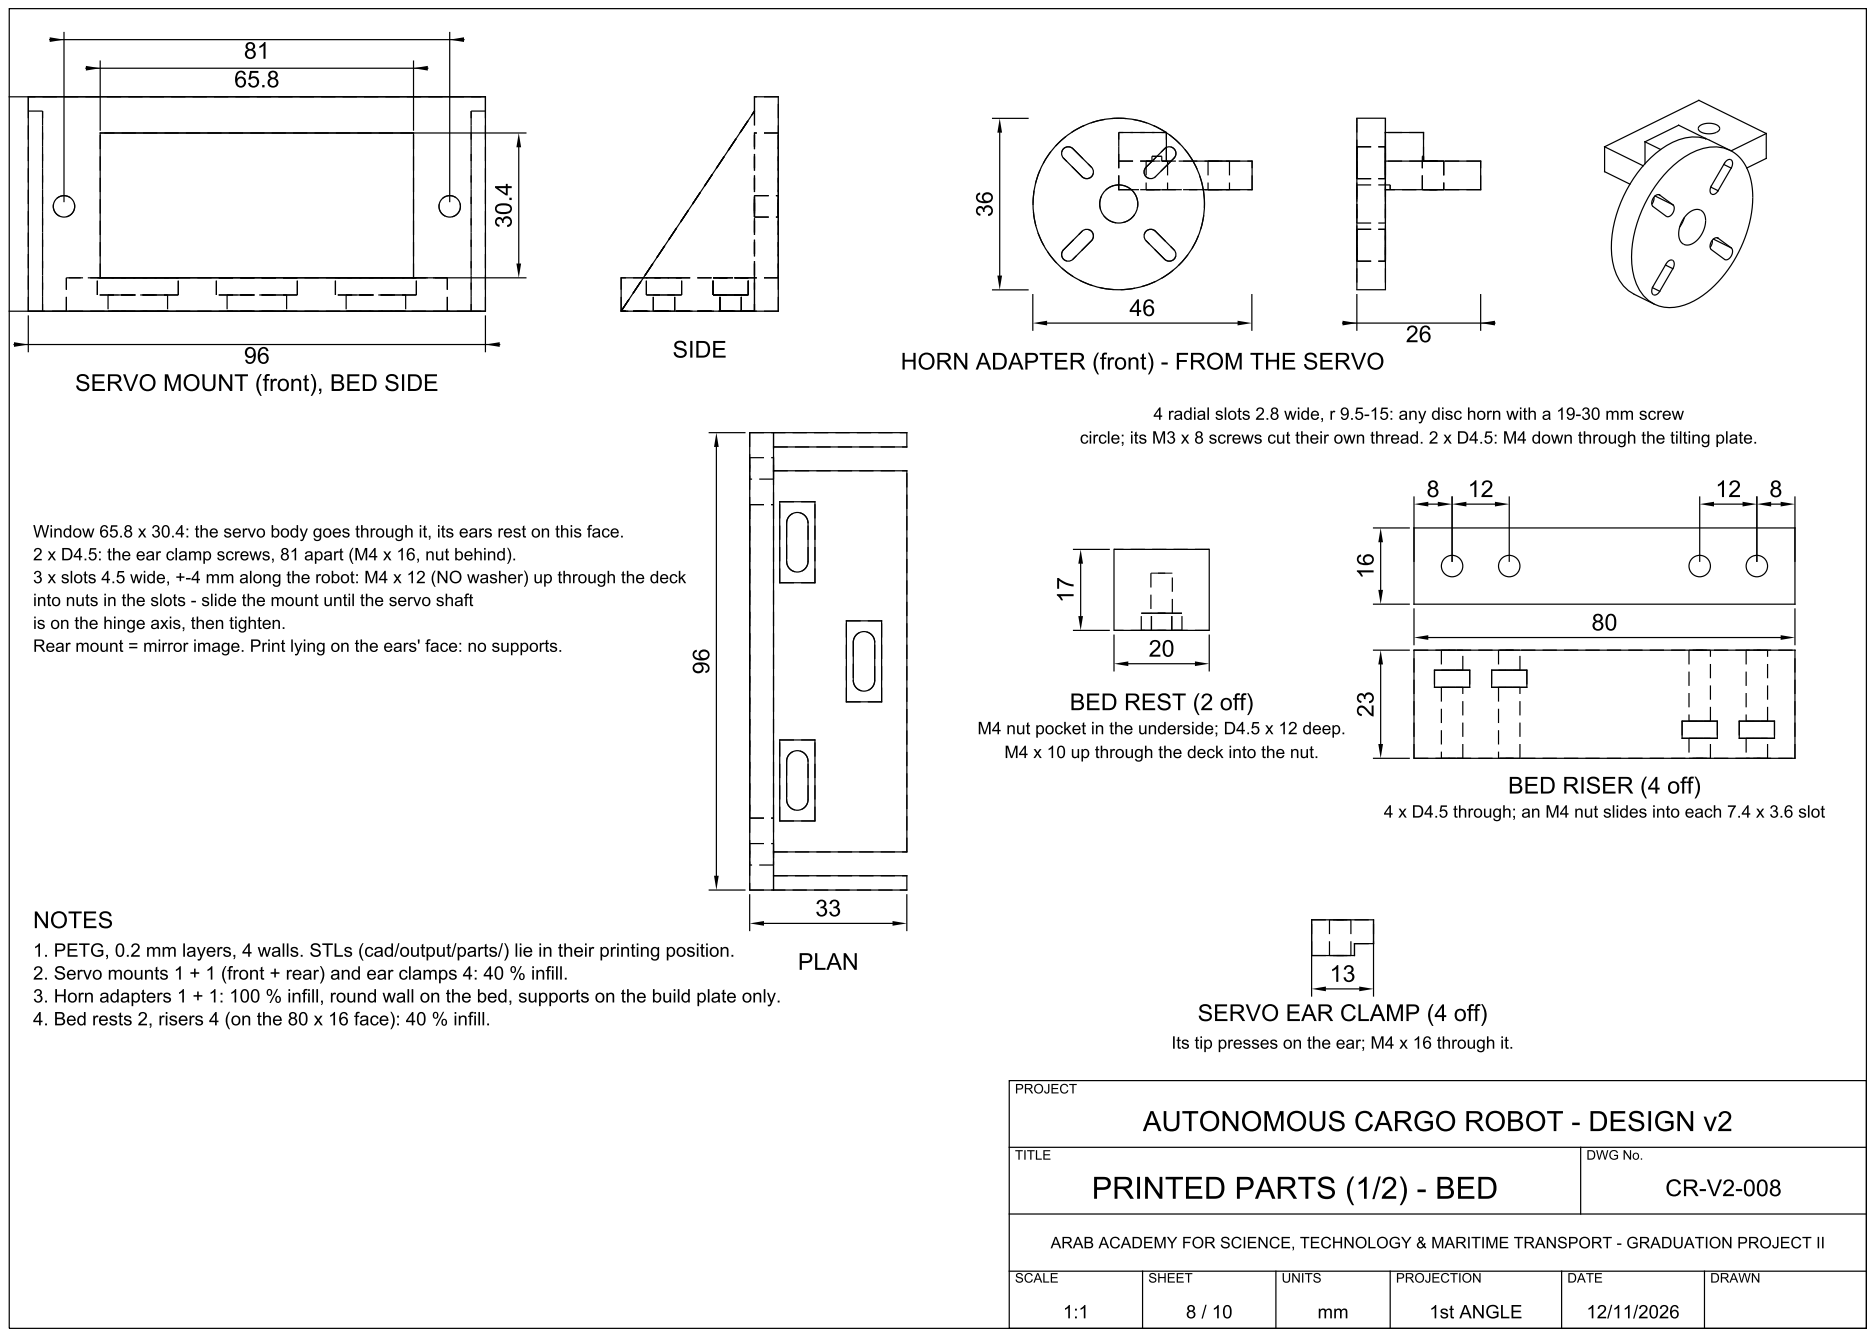
[picture p138: page 8]

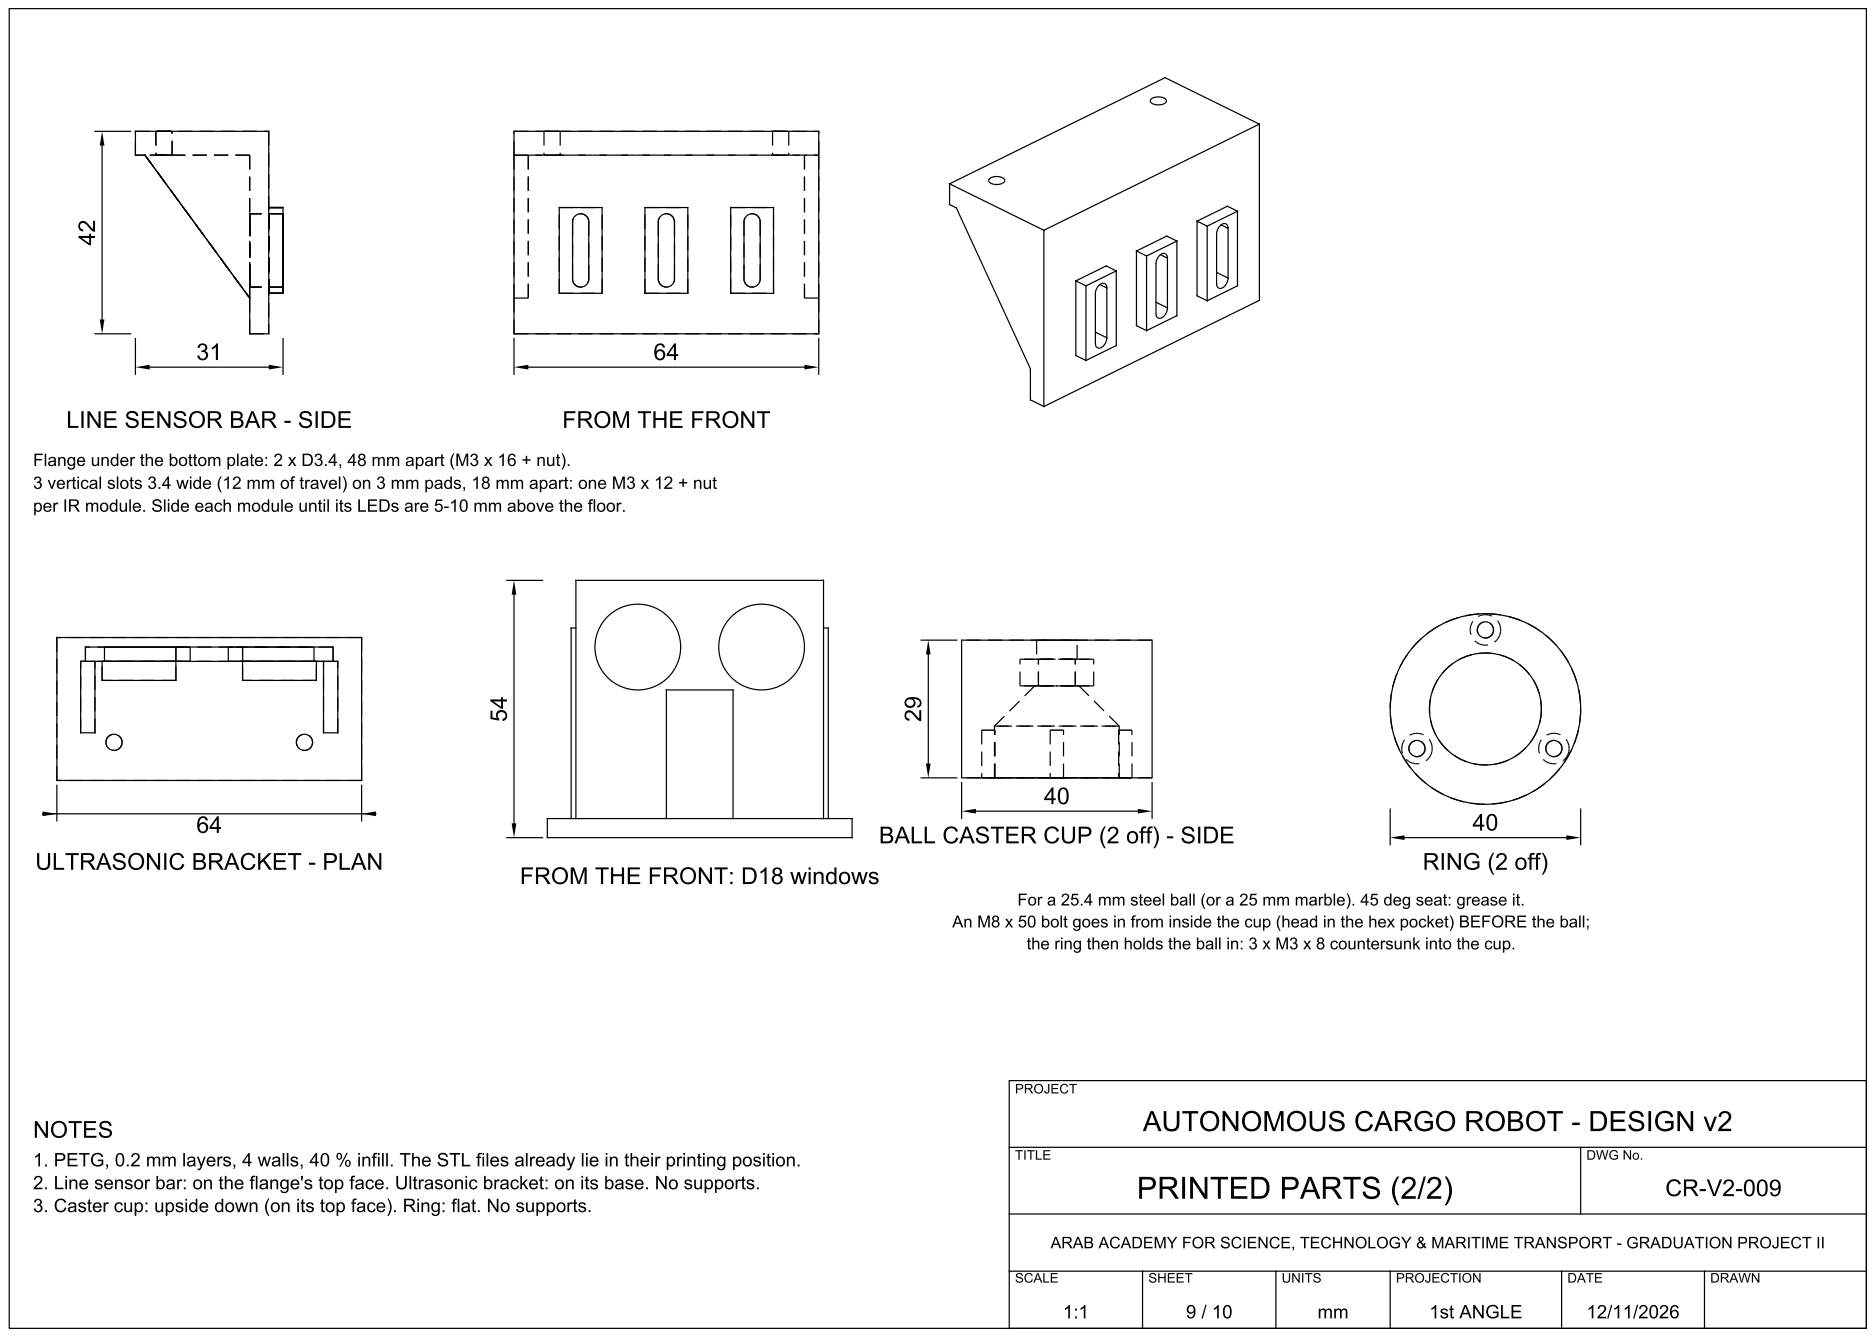
[picture p139: page 9]

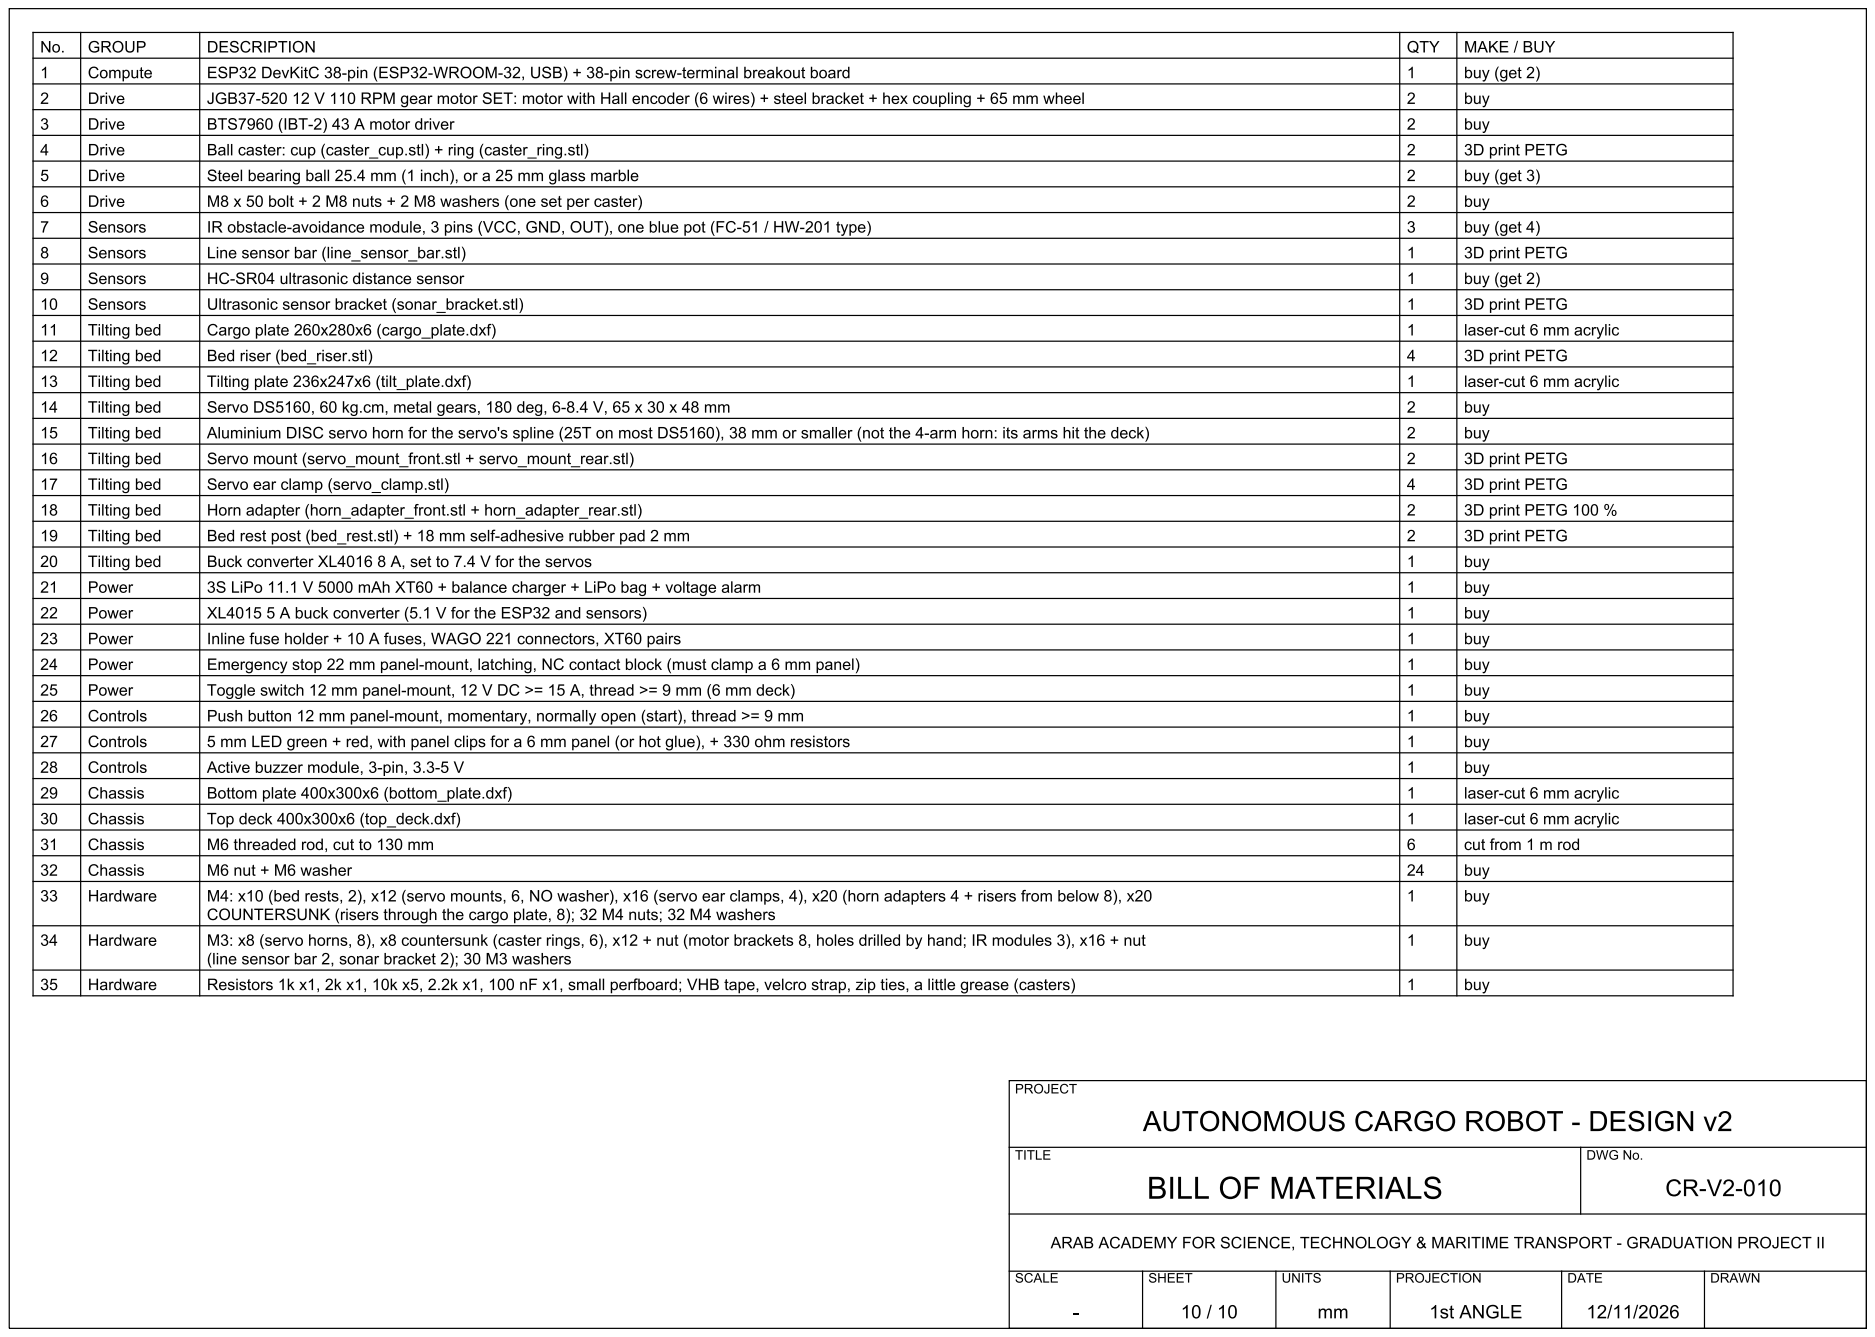
[picture p140: page 10]
