ahmedoab/cargo_robot/robot_ws/src/cargo_bot/config/robot.yaml

# Settings for the cargo_bot nodes. After editing: colcon build, then relaunch.
# Keep the decimal point on decimal numbers (write 1.0, not 1) or ROS will refuse the value.
# Pin numbers live in cargo_bot/pins.py.

base_driver:
  ros__parameters:
    wheel_radius: 0.05          # m - fine-tune with the 3 m straight-line test (week 5)
    wheel_separation: 0.33      # m - fine-tune with the 10-turn rotation test (week 5)
    ticks_per_rev: 2464         # encoder counts per wheel turn - measure with tools/test_encoders.py
    max_wheel_speed: 12.0       # rad/s (12 rad/s x 0.05 m = 0.6 m/s)
    rate: 50.0
    cmd_timeout: 0.5
    kf: 0.05                    # from tools/test_motors.py --max
    kp: 0.02
    ki: 0.10
    min_duty: 0.10              # from tools/test_motors.py --min
    pwm_freq: 1000
    invert_left_motor: false
    invert_right_motor: false
    invert_left_encoder: false
    invert_right_encoder: false
    use_estop_sense: true       # false if the 10k/3.3k divider on GPIO26 is not fitted yet

payload_node:
  ros__parameters:
    scale: 22000.0              # from tools/test_hx711.py --calibrate
    signs: [1, 1, 1, 1]
    tare_on_start: true         # the cargo bed must be EMPTY when the robot starts
    median_window: 5

speed_limiter:
  ros__parameters:
    max_payload_kg: 15.0
    min_factor: 0.5
    overload_ratio: 1.1
    max_linear: 0.5
    max_angular: 1.5
    weight_timeout: 2.0

pusher_node:
  ros__parameters:
    duty_out: 1.0               # 0-1: motor power while pushing the cargo off
    duty_in: 1.0                # 0-1: motor power while the blade returns
    stroke_timeout: 45.0        # s - a stroke that takes longer is a fault (jammed, or no motor power)
    dwell: 0.5                  # s - pause at the rear before returning
    invert_motor: false         # from tools/test_pusher.py: true if "out" moves the blade to the FRONT
    pwm_freq: 1000

vision_node:
  ros__parameters:
    device: 0                   # /dev/video0
    width: 640
    height: 480
    rate: 15.0
    dark_line: true
    roi_top: 0.55
    min_area: 600
    follow_speed: 0.12
    k_turn: 1.5
    lost_timeout: 0.5
    aruco_dict: "DICT_4X4_50"
    debug_image: true
