ahmedoab/cargo_robot/firmware/cargo_robot/cargo_robot.ino

// Cargo robot - main program for the ESP32 (Arduino IDE 2, board "ESP32 Dev Module").
//
// The robot follows a black tape line. Stations are short strips of tape across the line ("station marks"):
// the pickup and the drop-off (on the robot's RIGHT). It carries one package on its tilting bed. 3 IR sensors
// see the line; all 3 on black = a station mark.
//
//   LOAD     at the pickup: wait for the start button (put the package on the bed, then press it)
//   FOLLOW   follow the line to the next station mark: slow or stop for obstacles
//   DOCK     drive on stop_mm so the middle of the bed is level with the mark, then stop
//   SETTLE   at the drop-off: wait half a second for the robot to stand still
//   TIP      tip the bed to tip_deg (at tip_speed); the package slides off to the right
//   HOLD     keep it tipped for tip_hold_s
//   LOWER    lower the bed, switch the servos off and FOLLOW on to the pickup
// Always:  E-stop pressed -> everything stops.  Line lost -> ALARM: red LED + beeps; fix it, then press the
//          start button to carry on.
// The robot does not weigh anything: keep packages within the limit in BUILD_GUIDE.md.
//
// Start a mission with the start button or "run" in the Serial Monitor (115200 baud, Newline). The robot must
// stand at the pickup with the first package on its bed: it sets off at once.
// "help" lists the test and calibration commands. Wiring: config.h. Settings: settings.h.
#include "config.h"
#include "console.h"
#include "robot.h"
#include "settings.h"

enum State { IDLE, LOAD, FOLLOW, DOCK, SETTLE, TIP, HOLD, LOWER, ALARM, ESTOP };
const char *NAMES[] = {"IDLE", "LOAD", "FOLLOW", "DOCK", "SETTLE", "TIP", "HOLD", "LOWER", "ALARM", "ESTOP"};

State state = IDLE, resumeTo = IDLE;    // resumeTo: where ALARM goes back to when the button is pressed
bool toDropoff = true;                  // the next station mark is the drop-off (else the pickup)
int deliveriesLeft = 0;                 // 0 = until stopped
uint32_t since = 0, condSince = 0;      // when the state started / when the condition we wait for became true
float dockStart = 0;
bool buttonWas = false;
bool relaxWhenFlat = false;             // after "stop": lower the bed, then switch the servos off

const char *stateName() { return NAMES[state]; }

void go(State s) {
  state = s;
  since = millis();
  condSince = 0;
  Serial.printf("[%s]\n", NAMES[s]);
}

// true once cond has held for seconds without a break
bool heldFor(bool cond, float seconds) {
  if (!cond) {
    condSince = 0;
    return false;
  }
  if (!condSince) condSince = millis();
  return millis() - condSince >= seconds * 1000;
}

void alarm(const char *why, State retry) {
  driveStop();
  motorsEnable(false);
  resumeTo = retry;
  Serial.printf("!! ALARM: %s - fix it, then press the start button\n", why);
  go(ALARM);
}

void depart();

void startMission(int deliveries) {
  if (rd.busV < BUS_ON_V) {
    Serial.println("motor power is off: release the E-stop first");
    return;
  }
  deliveriesLeft = deliveries;
  bedRelax();
  Serial.println(deliveries ? "mission started" : "mission started (until stopped)");
  depart();
}

void stopMission() {
  driveStop();
  motorsEnable(false);
  if (servoFront.on()) {
    bedMove(0);
    relaxWhenFlat = true;
  }
  go(IDLE);
}

bool buttonPressed() {                  // one press = one event
  bool now = buttonDown();
  bool edge = now && !buttonWas;
  buttonWas = now;
  return edge;
}

// ---------------- line following ----------------
bool markArmed = true;
int markTicks = 0;
float lastPos = 0, lastPosTime = 0;
uint32_t lostSince = 0, obstacleSince = 0;

// Steer along the line at the speed allowed by the obstacles. Returns true when a station mark
// has just been crossed (mark_min = all 3 sensors on black, for 2 readings in a row).
bool follow() {
  const Line &l = rd.line;
  if (l.count == 0) {
    if (!lostSince) lostSince = millis();
    if (millis() - lostSince > cfg.lost_s * 1000) {
      alarm("line lost", state);
      return false;
    }
  } else {
    lostSince = 0;
  }

  float clear = obstacleFactor(rd.sonarCm, cfg.stop_cm, cfg.slow_cm);
  if (clear == 0) {                     // something in front: stop and ask for it to be moved
    if (!obstacleSince) Serial.println("obstacle - please remove it");
    obstacleSince = millis();
    lights(Light::On, Light::Fast);
    if (millis() % 1000 < 30) beep(120);
  } else if (obstacleSince && millis() - obstacleSince < cfg.clear_s * 1000) {
    clear = 0;                          // wait until the way has been clear for clear_s
  } else {
    obstacleSince = 0;
    lights(Light::On, Light::Off);
  }

  float pos = l.count ? l.pos : lastPos;  // line just lost: keep turning the way it went
  float now = millis() / 1000.0f;
  float dpos = (now > lastPosTime && lastPosTime > 0) ? (pos - lastPos) / (now - lastPosTime) : 0;
  lastPos = pos;
  lastPosTime = now;
  float v = cfg.follow_speed * clear;
  float w = (cfg.k_line * pos + cfg.kd_line * dpos) * (v / cfg.follow_speed);
  driveTarget(v, w);

  if (l.count >= cfg.mark_min) {
    if (markArmed && ++markTicks >= 2) {
      markArmed = false;
      return true;
    }
  } else {
    markTicks = 0;
    if (l.count <= 1) markArmed = true;     // back on the plain line: the next mark can count
  }
  return false;
}

// ---------------- the mission ----------------
void depart() {                         // leave the pickup with a package on the bed
  Serial.println("off to the drop-off");
  beep(200);
  toDropoff = true;
  motorsEnable(true);
  markArmed = true;
  go(FOLLOW);
}

void step() {
  bool power = rd.busV > BUS_ON_V;
  if (!power && state != ESTOP && state != IDLE) {
    driveStop();
    motorsEnable(false);
    bedRelax();                         // the servos have lost power too; never jump back to an old angle
    Serial.println("E-STOP: motor power is off");
    lights(Light::Off, Light::On);
    go(ESTOP);
    return;
  }
  bool button = buttonPressed();

  switch (state) {
    case IDLE:
      lights(Light::Slow, power ? Light::Off : Light::On);
      if (relaxWhenFlat && !bedMoving()) {
        bedRelax();
        relaxWhenFlat = false;
      }
      if (button) startMission(0);
      break;

    case ESTOP:
      if (heldFor(power, 1.0f)) {
        Serial.println("motor power is back - press the start button or type run");
        go(IDLE);
      }
      break;

    case LOAD:
      lights(Light::On, Light::Off);
      motorsEnable(false);
      if (button) depart();
      break;

    case FOLLOW:
      if (follow()) {
        dockStart = rd.odom.distance;
        go(DOCK);
      }
      break;

    case DOCK:
      follow();
      if (state == DOCK && rd.odom.distance - dockStart >= cfg.stop_mm / 1000) {
        driveStop();
        motorsEnable(false);
        if (toDropoff) {
          go(SETTLE);
        } else if (deliveriesLeft && --deliveriesLeft == 0) {
          Serial.println("all deliveries done");
          go(IDLE);
        } else {
          Serial.println("at the pickup: put the next package on the bed, then press the start button");
          go(LOAD);
        }
      }
      break;

    case SETTLE:
      if (millis() - since < 500) break;  // let the robot stand still
      bedMove(cfg.tip_deg);
      lights(Light::Fast, Light::Off);
      go(TIP);
      break;

    case TIP:
      if (!bedMoving()) go(HOLD);
      break;

    case HOLD:
      if (millis() - since >= cfg.tip_hold_s * 1000) {
        bedMove(0);
        go(LOWER);
      }
      break;

    case LOWER:
      if (bedMoving()) break;
      bedRelax();                       // resting flat on its posts now
      Serial.println("package delivered");
      toDropoff = false;
      motorsEnable(true);
      markArmed = true;
      lights(Light::On, Light::Off);
      go(FOLLOW);
      break;

    case ALARM:
      lights(Light::Off, Light::On);
      if (millis() % 2000 < 30) beep(150);
      if (button) {
        Serial.println("carrying on");
        if (resumeTo == FOLLOW || resumeTo == DOCK) motorsEnable(true);
        go(resumeTo);
      }
      break;
  }
}

void setup() {
  Serial.begin(115200);
  delay(300);
  Serial.println("\nCargo robot (ESP32) - type help");
  settingsLoad();
  robotBegin();
  robotUpdate();
  Serial.printf("motor power %s (%.1f V)\n", rd.busV > BUS_ON_V ? "ON" : "OFF", rd.busV);
  go(IDLE);
}

void loop() {
  robotUpdate();
  consolePoll();
  step();
}
