ahmedoab/cargo_robot/(commit log)

2026-09-29 Autonomous cargo robot (Graduation Project II): CAD and AutoCAD drawings, electrical schematics, build guide, ROS 2 code and Gazebo simulation
    [CargoRobot_v2.dxf, CargoRobot_v2_schematics.dxf, bom.csv, bottom_plate.dxf, bottom_plate.step, bottom_plate.stl, camera_mount.step, camera_mount.stl]
2026-09-29 Remove backup copy; update folder overview in the build guide
    [CargoRobot_v2.dxf, bom.csv, bottom_plate.dxf, bottom_plate.step, bottom_plate.stl, camera_mount.step, camera_mount.stl, cargo_bot.urdf.xacro]
2026-10-13 Design v3: rear pusher for unloading onto a conveyor; keep v2 in backup_v2
    - CAD: push blade on a T8 lead screw and two 8 mm rods outside the deck
    edges (robot_cad.py); collision check over the whole stroke; 8-sheet
    drawing set; regenerated STEP, STL, DXF, renders, BOM and ROS mesh
    - Electrical: third BTS7960, pusher motor and two limit switches on all
    three schematic sheets; GPIO 9/10 (driver) and 4/6 (switches)
    - ROS: pusher_node, conveyor docking and unloading in the mission
    (--conveyor), tools/test_pusher.py
    - Docs: build guide steps marked "Pusher"; PUSHER_IMPACT.md compares v3
    with v2
    - backup_v2/: untouched copy of design v2 (commit 11388c4)
    The pusher has not been built or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
2026-10-13 Add a 3D model of the drop-off conveyor, for simulation only
    - conveyor/conveyor_cad.py: parametric model (80 cm long, belt 300 mm
    wide at 195 mm, low docking plate on the robot's side, 300 mm
    backstop); exports STEP, STL, glTF and separate meshes for the frame,
    belt, rollers and end stop
    - conveyor/check_render.py: collision check, 8 fit checks against the
    robot's model, renders
    - conveyor/README.md: axes, units, dimensions, collision boxes and the
    robot's docking pose
    - Build guide: points to the folder from the overview and section 8.7
    Shape only: no bearings, fasteners or wiring. It has not been loaded
    into a simulator yet.
2026-10-20 Design v4: 3D-printed robot body, ESP32 only, sideways pusher
    The robot from the 20 October build plan: one ESP32 for line following,
    obstacle detection, weighing and the pusher; no Raspberry Pi or lidar
    (a laptop with a USB webcam does the AI at the conveyor).
    - cad/robot_cad.py: new parametric design. A 400 x 300 mm tub printed in
    4 tiles bolted at the seams; ABS motor mounts that fill a window in
    each side wall and clamp the 37 mm gearbox; ball casters in printed
    pods with height shims; a 265 x 280 mm cargo bed (4 tiles, top at
    212 mm) on one 5 kg load cell, with overload stops; a sideways pusher
    (NEMA17 + GT2 belt, 4 LM8UU on two 8 mm rods, 210 mm stroke, blade
    stops 5 mm in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
2026-10-22 Design v2 with a tilting bed and one ESP32 (no Pi, no lidar)
    Back to design v2 (plywood + acrylic plates on threaded rods), with these
    changes; v3 and v4 are only in the git history, and backup_v2/ keeps v2 as
    it was.
    - Tilting bed: two 60 kg.cm servos on the deck's right edge turn the bed
    about their shafts (the shafts are the hinge) to 40 deg, so the package
    slides off to the right onto the conveyor. The 4 load cells ride on a
    new 6 mm plywood tilting plate; flat, the bed rests on two posts.
    Collision-checked from 0 to 45 deg; torque for a 3 kg package is about
    40 % of the servos' stall torque (calculated, not tested).
    - Electronics: one ESP32 (+ MCP23017) replaces the Raspberry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
2026-10-22 One ultrasonic sensor, and the line sensor under the robot
    - One HC-SR04 at the front, looking straight ahead, instead of three.
    The firmware stops below stop_cm and slows below slow_cm on that one
    reading; ECHO stays on GPIO 23, GPIO 13 and 32 are free. Signal wires
    renumbered S1-S38.
    - The 8-channel line sensor now hangs under the bottom plate, 98 mm in
    front of the axle and clear of the front caster's swivel, instead of
    in front of the robot. Nothing sticks out in front: 407 mm long.
    stop_mm default 214 -> 98. The ultrasonic bracket has its own 2 holes.
    - Regenerated CAD outputs, drawings, schematics, assembly and
    connections PDFs; build guide and cad/README updated.
    Checke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
2026-11-10 Design draft: conveyor feeds the robot, the laptop picks each package's route
    The conveyor (camera, no ESP32) drops packages onto the robot. The laptop
    reads the label and sends the robot left/right turns over Wi-Fi; the robot
    takes that branch where the main line splits, tips the package off, turns
    around and comes back. No colour sensor and no bed walls: the robot's
    hardware does not change. The software is on hold until the laptop's
    network needs are known.
2026-11-10 Remove the load cells and the side sensor; new motors, casters and line sensors
    Weight: no load cells, HX711 boards or spacers. 4 printed risers carry the
    cargo plate (countersunk screws through it, so the package slides clear).
    The robot no longer weighs: at the pickup you load it and press start.
    Hardware:
    - JGB37-520 12 V 110 RPM motor sets with 65 mm wheels (the robot sits
    17.5 mm lower)
    - printed ball casters (25.4 mm ball, M8 bolt, height set by nuts)
    - 3 IR obstacle-avoidance modules on a printed bar as the line sensor
    - no MCP23017 and no VL53L0X: everything wired straight to the ESP32,
    no I2C; signal wires are now S1-S28
    - servo buck: XL4016 8 A
    Printed parts checked and fixed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
2026-11-12 All plates in 6 mm acrylic; readable A3 drawings; list of parts to buy
    Plates: all four were cut in 6 mm acrylic (the design had 6 mm plywood for
    the bottom and tilting plates, 5 mm acrylic for the deck and cargo plate).
    Only the deck and the cargo plate are 1 mm thicker: the bed top is now
    220 mm. All checks pass (57 bolt paths, no collisions at 0-45 deg, all 4
    wheels on the floor). The plate DXFs and the printed parts don't change.
    Screws:
    - line sensor bar and ultrasonic bracket: M3 x 16 (M3 x 12 was too short)
    - servo mounts: M4 x 12 with no washer
    - servo horns: M3 x 8 in the BOM (it said M3 x 10)
    - 30 M3 washers for the acrylic bottom plate
    - the E-stop, switch, button and LED clips m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
2026-11-12 Parts list: spare ESP32, horns and floor confirmed; add a spare 5 A buck converter
    Only one question is left: whether panel parts already owned have long enough threads for the 6 mm deck (now explained in plain words).
2026-11-12 Parts list: no spare 5 A buck converter
2026-11-12 Parts list as a formal procurement list (CR-V2-PL-001 Rev. A)
    A4 landscape with a title block, summary, general notes, numbered items with specification, unit and application columns, components in stock, open items and an approval block. Start button, LEDs, resistors and the capacitor are in stock: 44 line items to purchase.
2026-11-12 Parts list Rev. B: parts to purchase only, USB cable removed
    The PDF is now just the parts table (43 line items, 2 pages); title block, notes, in-stock list, open items and approval block removed.
